Bud-wiser-er/ERD320-FinalReport/README.md

##READ ME##
No claude was not used, I used it to set up this repo and ensure no exe files wehre pushed. You can see everything is done by myself
