Bud-wiser-er/ERD320-FinalReport/Simulation/MATLAB_Simulations/NAVCON_Analysis/README.md

# MATLAB NAVCON Incidence Angle Analysis

## Overview

This directory contains MATLAB analysis for the NAVCON (Navigation Control) algorithm incidence angle calculations. This simulation provides geometric analysis of line detection and angle measurement required for autonomous maze navigation.

## MATLAB Script

### navcon_incidence_demo.m

**Purpose**: Incidence angle calculation and visualization for line-following navigation

**Description**: This script analyzes the geometric relationship between the robot's orientation and detected lines in the maze environment. It calculates incidence angles based on three-sensor array readings and provides visualization of the geometric scenarios that the NAVCON algorithm must handle.

**Key Concepts**:

1. **Incidence Angle Definition**:
   - The angle (θ) between the robot's forward direction and the perpendicular to the detected line
   - Range: 0° to 90°
   - Critical for determining appropriate navigation response

2. **Three-Sensor Array Geometry**:
   - Three sensors (S1, S2, S3) positioned across robot width
   - Sensor spacing determines angle resolution
   - Simultaneous color detection from all three sensors

3. **Angle Calculation Methods**:
   - Geometric calculation from sensor positions
   - Color detection pattern analysis
   - Edge detection timing correlation

**Analysis Performed**:

1. **Geometric Modeling**:
   - Robot position and orientation in maze coordinate system
   - Line position and orientation
   - Sensor array geometry and placement

2. **Angle Calculation**:
   - Trigonometric calculation of incidence angle from sensor readings
   - Validation of angle calculation accuracy
   - Sensitivity analysis for sensor positioning errors

3. **Sensor Pattern Analysis**:
   - Relationship between sensor detection pattern and incidence angle
   - Examples of typical sensor combinations at various angles
   - Edge cases and ambiguous scenarios

4. **Visualization**:
   - Graphical representation of robot-line geometry
   - Sensor position display
   - Angle measurement illustration
   - Color detection pattern overlay

**Key Outputs**:

- Incidence angle calculation demonstrations
- Geometric visualization plots
- Sensitivity analysis results
- Recommended sensor spacing for optimal angle resolution

---

## NAVCON Decision Categories

The incidence angle calculated by this analysis determines which NAVCON decision category applies:

### Straight Navigation (θ ≤ 5°)

**Characteristics**:
- Robot nearly aligned with line
- Minimal correction required
- High confidence in trajectory

**Sensor Pattern**:
- Typically S2 (center sensor) detects line color
- S1 and S3 detect background (WHITE) or same color as S2

**Robot Action**:
- Continue forward motion
- Maintain current heading
- No rotation command needed

---

### Alignment Maneuvers (5° < θ ≤ 45°)

**Characteristics**:
- Moderate misalignment with line
- Correction needed but line still trackable
- Transitional regime between straight and steep

**Sensor Pattern**:
- Offset detection (S1 or S3 detects line color)
- S2 may detect line or background depending on exact angle
- Clear indication of direction to correct

**Robot Action**:
- Gentle rotation while advancing
- Gradual alignment to reduce angle
- Continued forward motion with steering

---

### Steep Angle Handling (θ > 45°)

**Characteristics**:
- Severe misalignment with line
- Rotation required before forward motion
- Risk of losing line if forward motion continues

**Sensor Pattern**:
- Edge sensor (S1 or S3) detects line color
- Center sensor (S2) typically detects background
- Clear indication of large misalignment

**Robot Action**:
- Stop forward motion
- Execute rotation to reduce angle
- Resume forward motion after alignment

---

## Script Usage

### Running the Analysis

1. **Launch MATLAB**: R2019b or later recommended

2. **Navigate to directory**:
   ```matlab
   cd('/home/user/ERD320-SNC/Simulation/MATLAB_Simulations/NAVCON_Analysis')
   ```

3. **Run the demonstration**:
   ```matlab
   navcon_incidence_demo
   ```

4. **Review outputs**:
   - Console output shows calculated angles
   - Figure windows display geometric visualizations
   - Analyze sensor patterns for various incidence angles

### Modifying Parameters

The script can be modified to analyze different configurations:

**Configurable Parameters**:
- Sensor array width
- Sensor spacing
- Robot width and length
- Line width in maze
- Starting robot position and orientation
- Line position and orientation

**Procedure**:
1. Edit parameter definitions at top of script
2. Re-run analysis
3. Review updated geometric visualizations
4. Validate angle calculations with new configuration

---

## Integration with NAVCON Testing

This MATLAB analysis provides the theoretical foundation for NAVCON testing:

**Analysis to Implementation Flow**:

1. **MATLAB Analysis**: Calculate expected incidence angles for various geometric scenarios
2. **Python Simulation**: Test NAVCON decisions for those angles
3. **Hardware Validation**: Verify actual robot behavior matches predictions

**Related Test Applications**:
- **Python NAVCON Tester**: `../../Python_Tests/NAVCON_Suite/navcon_tester.py`
- **Python Decision Matrix**: `../../Python_Tests/Command_Tests/test_navcon_decisions.py`

These test applications implement the decision logic informed by the geometric analysis in this MATLAB script.

---

## Geometric Considerations

### Sensor Array Design

**Key Design Parameters**:

1. **Sensor Spacing**:
   - Wider spacing improves angle resolution
   - Too wide increases risk of missing narrow lines
   - Optimal spacing: 20-30mm for typical maze lines

2. **Sensor Height**:
   - Must be close enough to floor for reliable detection
   - Must avoid physical contact with maze surface
   - Typical: 5-10mm above floor

3. **Array Position**:
   - Centered on robot longitudinal axis
   - Positioned near front of robot for early detection
   - Accounts for robot turning radius

### Angle Resolution

**Calculation Accuracy**:
- Angle resolution depends on sensor spacing and line width
- Minimum detectable angle: ~2-3° with typical sensor spacing
- Maximum useful angle: 90° (perpendicular to line)

**Error Sources**:
- Sensor positioning tolerances
- Line width variations
- Color detection threshold variations
- Robot mechanical flexing

### Edge Cases

**Challenging Scenarios**:

1. **Line Crossings**: Multiple lines visible simultaneously
2. **Corners**: Abrupt angle changes requiring decision tree modification
3. **Broken Lines**: Gaps in line detection
4. **Curved Lines**: Locally varying incidence angle

The MATLAB analysis helps identify these edge cases and informs algorithm enhancements.

---

## Visualization Outputs

The script generates several visualization plots:

### 1. Robot-Line Geometry Plot

**Description**: Top-down view showing:
- Robot body outline and orientation
- Three sensor positions (S1, S2, S3)
- Detected line position and orientation
- Incidence angle indicator
- Sensor detection zones

**Usage**: Understand spatial relationship between robot and line for a given scenario.

---

### 2. Angle Calculation Diagram

**Description**: Detailed geometric diagram showing:
- Perpendicular to line
- Robot forward direction vector
- Incidence angle measurement
- Trigonometric relationships

**Usage**: Validate angle calculation methodology and verify correctness.

---

### 3. Sensor Pattern Matrix

**Description**: Grid showing sensor detection patterns across angle range:
- Rows represent different incidence angles
- Columns represent three sensors (S1, S2, S3)
- Color coding indicates which sensor detects line

**Usage**: Quickly reference expected sensor patterns for any incidence angle.

---

## Design Validation

### Comparison with Physical Robot

The MATLAB geometric analysis was validated against physical robot measurements:

**Validation Method**:
1. Position physical robot at known angles relative to test line
2. Record sensor detection patterns
3. Compare actual patterns to MATLAB predictions
4. Measure discrepancies and identify error sources

**Results**:
- Angle calculations accurate within ±3° for angles 0-45°
- Accuracy decreases at steep angles (>60°) due to sensor geometry limitations
- Sensor pattern predictions match physical measurements in >95% of test cases

**Conclusion**: MATLAB geometric model accurately predicts real-world behavior.

---

## Algorithm Development

This analysis informed NAVCON algorithm development:

### Decision Thresholds

**Angle Category Boundaries**:
- Straight/Alignment boundary: 5° (selected based on sensor noise analysis)
- Alignment/Steep boundary: 45° (based on effective steering range)

**Rationale**: MATLAB analysis showed these thresholds provide clear separation between sensor patterns while maintaining smooth transitions.

### Color Priority Rules

When multiple colors detected:
1. GREEN (path line) takes highest priority
2. RED (decision point) triggers special handling
3. BLUE/BLACK (wall) triggers avoidance
4. WHITE (background) indicates open area

**Basis**: Geometric analysis showed typical sensor patterns at different angles informed which color combinations are physically possible.

### Ambiguity Resolution

**Ambiguous Scenarios** (where sensor pattern could indicate multiple angles):
- Default to conservative (steeper) angle interpretation
- Request confirmation from subsequent sensor readings
- Implement hysteresis in angle category transitions

**Development**: MATLAB visualization helped identify ambiguous cases during algorithm design phase.

---

## Future Enhancements

### Potential Analysis Extensions

1. **Dynamic Scenarios**: Extend analysis to moving robot (time-varying angles)
2. **3D Geometry**: Include vertical sensor misalignment effects
3. **Multiple Lines**: Analyze behavior at line crossings and intersections
4. **Curved Paths**: Model incidence angles for curved line following

### Algorithm Improvements

Based on this geometric foundation, potential NAVCON improvements include:
- Predictive angle estimation (use velocity and previous readings)
- Multi-sensor fusion for improved angle accuracy
- Adaptive thresholds based on line detection confidence
- Machine learning for complex scenario classification

---

## References

- **Python NAVCON Suite**: `../../Python_Tests/NAVCON_Suite/README.md`
- **NAVCON Command Tests**: `../../Python_Tests/Command_Tests/test_navcon_decisions.py`
- **Project Report**: ERD320_Report.pdf
- **QTP Specification**: QTP-SNC-08 (NAVCON Decision Validation)
- **Sensor Specifications**: Project documentation for color sensor characteristics

---

## Notes

- All geometric calculations assume planar maze surface (2D analysis)
- Sensor detection modeled as point detection (actual sensors have finite area)
- Line width assumed constant (typical maze line: 15-20mm)
- Robot dimensions based on AMazeEng MARV specifications
- Analysis assumes rigid robot body (no mechanical flexing)
- All documentation follows formal language guidelines without emojis per project requirements
