Bud-wiser-er/ERD320-FinalReport/EPR320_Group_45_Final_Report/acronyms.tex

% acronyms/acronyms.tex
% Define acronyms for automatic first-use expansion and list generation.

% ==================== PROJECT-SPECIFIC ACRONYMS ====================
\newacronym{marv}{MARV}{Miniature Autonomous Robotic Vehicle}
\newacronym{snc}{SNC}{State-and-Navigation Control}
\newacronym{ss}{SS}{Sensor Subsystem}
\newacronym{mdps}{MDPS}{Motor Drive and Power Subsystem}
\newacronym{scs}{SCS}{Structured Command Set}
\newacronym{navcon}{NAVCON}{Navigation Control}
\newacronym{hmi}{HMI}{Human-Machine Interface}
\newacronym{pec}{PEC}{Project Evaluation Criteria}
\newacronym{hub}{HUB}{Hardware Unit Bench (testing interface)}
\newacronym{eoc}{EoC}{End-of-Calibration}
\newacronym{eom}{EoM}{End-of-Maze}
\newacronym{sos}{SOS}{Save Our Ship (emergency state)}
\newacronym{ist}{IST}{Instruction Type}
\newacronym{spl}{SPL}{Sound Pressure Level}

% ==================== SYSTEMS ENGINEERING ====================
\newacronym{qtp}{QTP}{Qualification Test Procedure}
\newacronym{icd}{ICD}{Interface Control Document}
\newacronym{rtm}{RTM}{Requirements Traceability Matrix}
\newacronym{opscon}{OpsCon}{Operational Concept}
\newacronym{stp}{STP}{System Test Plan}
\newacronym{vv}{V\&V}{Verification and Validation}
\newacronym{fsm}{FSM}{Finite State Machine}
\newacronym{hil}{HIL}{Hardware-in-the-Loop}
\newacronym{mtbf}{MTBF}{Mean Time Between Failures}
\newacronym{mttr}{MTTR}{Mean Time To Repair}

% ==================== HARDWARE & MICROCONTROLLER ====================
\newacronym{mcu}{MCU}{Microcontroller Unit}
\newacronym{cpu}{CPU}{Central Processing Unit}
\newacronym{gpio}{GPIO}{General Purpose Input/Output}
\newacronym{adc}{ADC}{Analogue-to-Digital Converter}
\newacronym{dac}{DAC}{Digital-to-Analogue Converter}
\newacronym{pwm}{PWM}{Pulse Width Modulation}
\newacronym{led}{LED}{Light Emitting Diode}
\newacronym{pcb}{PCB}{Printed Circuit Board}
\newacronym{ic}{IC}{Integrated Circuit}
\newacronym{mosfet}{MOSFET}{Metal-Oxide-Semiconductor Field-Effect Transistor}
\newacronym{afe}{AFE}{Analogue Front-End}
\newacronym{isr}{ISR}{Interrupt Service Routine}

% ==================== COMMUNICATION PROTOCOLS ====================
\newacronym{uart}{UART}{Universal Asynchronous Receiver-Transmitter}
\newacronym{iic}{I\textsuperscript{2}C}{Inter-Integrated Circuit}
\newacronym{spi}{SPI}{Serial Peripheral Interface}
\newacronym{usb}{USB}{Universal Serial Bus}
\newacronym{rf}{RF}{Radio Frequency}

% ==================== NETWORKING & DATA ====================
\newacronym{wifi}{Wi-Fi}{Wireless Fidelity}
\newacronym{http}{HTTP}{Hypertext Transfer Protocol}
\newacronym{rest}{REST}{Representational State Transfer}
\newacronym{api}{API}{Application Programming Interface}
\newacronym{json}{JSON}{JavaScript Object Notation}
\newacronym{csv}{CSV}{Comma-Separated Values}
\newacronym{ws}{WS}{WebSocket}

% ==================== DATA INTEGRITY & PROTOCOL ====================
\newacronym{crc}{CRC}{Cyclic Redundancy Check}
\newacronym{sof}{SOF}{Start of Frame}
\newacronym{eof}{EOF}{End of Frame}
\newacronym{ack}{ACK}{Acknowledge}
\newacronym{nak}{NAK}{Negative Acknowledge}
\newacronym{ber}{BER}{Bit Error Rate}

% ==================== MEMORY & STORAGE ====================
\newacronym{ram}{RAM}{Random Access Memory}
\newacronym{rom}{ROM}{Read-Only Memory}
\newacronym{eeprom}{EEPROM}{Electrically Erasable Programmable Read-Only Memory}
\newacronym{rtc}{RTC}{Real-Time Clock}
\newacronym{dma}{DMA}{Direct Memory Access}

% ==================== CONTROL & SIGNAL PROCESSING ====================
\newacronym{pid}{PID}{Proportional-Integral-Derivative}
\newacronym{dsp}{DSP}{Digital Signal Processing}

% ==================== ELECTROMAGNETIC & SAFETY ====================
\newacronym{emi}{EMI}{Electromagnetic Interference}
\newacronym{emc}{EMC}{Electromagnetic Compatibility}
\newacronym{dc}{DC}{Direct Current}

% ==================== DEVELOPMENT TOOLS ====================
\newacronym{ide}{IDE}{Integrated Development Environment}
\newacronym{cad}{CAD}{Computer-Aided Design}
\newacronym{git}{Git}{Distributed Version Control System}

% ==================== OTHER TECHNICAL TERMS ====================
\newacronym{fpga}{FPGA}{Field-Programmable Gate Array}
\newacronym{iot}{IoT}{Internet of Things}

% ==================== ESP32 & EMBEDDED SYSTEMS ====================
\newacronym{soc}{SoC}{System on Chip}
\newacronym{rtos}{RTOS}{Real-Time Operating System}
\newacronym{wdt}{WDT}{Watchdog Timer}
\newacronym{ota}{OTA}{Over-The-Air (firmware update)}
\newacronym{sdk}{SDK}{Software Development Kit}
\newacronym{bsp}{BSP}{Board Support Package}
\newacronym{hal}{HAL}{Hardware Abstraction Layer}
\newacronym{nvs}{NVS}{Non-Volatile Storage}
\newacronym{jtag}{JTAG}{Joint Test Action Group (debugging interface)}
\newacronym{sram}{SRAM}{Static Random Access Memory}

% ==================== SENSORS & MEASUREMENT ====================
\newacronym{ir}{IR}{Infrared}
\newacronym{rgb}{RGB}{Red Green Blue}
\newacronym{imu}{IMU}{Inertial Measurement Unit}
\newacronym{tof}{ToF}{Time of Flight}
\newacronym{ldr}{LDR}{Light Dependent Resistor}
\newacronym{snr}{SNR}{Signal-to-Noise Ratio}

% ==================== MOTOR CONTROL & POWER ====================
\newacronym{hbridge}{H-Bridge}{H-Bridge Motor Driver Circuit}
\newacronym{rpm}{RPM}{Revolutions Per Minute}
\newacronym{emf}{EMF}{Electromotive Force}
\newacronym{bemf}{Back-EMF}{Back Electromotive Force}
\newacronym{ldo}{LDO}{Low Dropout Regulator}
\newacronym{smps}{SMPS}{Switching Mode Power Supply}
\newacronym{bms}{BMS}{Battery Management System}
\newacronym{lipo}{LiPo}{Lithium Polymer}
\newacronym{liion}{Li-ion}{Lithium-ion}

% ==================== NETWORKING & PROTOCOLS ====================
\newacronym{tcp}{TCP}{Transmission Control Protocol}
\newacronym{udp}{UDP}{User Datagram Protocol}
\newacronym{ip}{IP}{Internet Protocol}
\newacronym{dhcp}{DHCP}{Dynamic Host Configuration Protocol}
\newacronym{dns}{DNS}{Domain Name System}
\newacronym{ssid}{SSID}{Service Set Identifier}
\newacronym{mac}{MAC}{Media Access Control}
\newacronym{ntp}{NTP}{Network Time Protocol}
\newacronym{ap}{AP}{Access Point}
\newacronym{sta}{STA}{Station (Wi-Fi client mode)}

% ==================== SOFTWARE & INTERFACES ====================
\newacronym{cli}{CLI}{Command Line Interface}
\newacronym{gui}{GUI}{Graphical User Interface}
\newacronym{ui}{UI}{User Interface}
\newacronym{cicd}{CI/CD}{Continuous Integration/Continuous Deployment}

% ==================== DATA STRUCTURES & FORMATS ====================
\newacronym{fifo}{FIFO}{First In First Out}
\newacronym{lifo}{LIFO}{Last In First Out}
\newacronym{ascii}{ASCII}{American Standard Code for Information Interchange}
\newacronym{utf}{UTF-8}{8-bit Unicode Transformation Format}
\newacronym{msb}{MSB}{Most Significant Bit}
\newacronym{lsb}{LSB}{Least Significant Bit}

% ==================== COMMUNICATION SIGNALS ====================
\newacronym{rxtx}{RX/TX}{Receive/Transmit}
\newacronym{rtscts}{RTS/CTS}{Request to Send/Clear to Send}
\newacronym{miso}{MISO}{Master In Slave Out}
\newacronym{mosi}{MOSI}{Master Out Slave In}
\newacronym{sck}{SCK}{Serial Clock}
\newacronym{sda}{SDA}{Serial Data}
\newacronym{scl}{SCL}{Serial Clock}

% ==================== SIGNAL PROCESSING ====================
\newacronym{fft}{FFT}{Fast Fourier Transform}
\newacronym{fir}{FIR}{Finite Impulse Response}
\newacronym{iir}{IIR}{Infinite Impulse Response}
\newacronym{lpf}{LPF}{Low Pass Filter}
\newacronym{hpf}{HPF}{High Pass Filter}
\newacronym{bpf}{BPF}{Band Pass Filter}
\newacronym{mfb}{MFB}{Multiple Feedback}

% ==================== ELECTRICAL MEASUREMENTS ====================
\newacronym{rms}{RMS}{Root Mean Square}
\newacronym{ac}{AC}{Alternating Current}
\newacronym{gnd}{GND}{Ground}
\newacronym{vcc}{VCC}{Voltage Common Collector (positive supply)}
\newacronym{vdd}{VDD}{Voltage Drain Drain (positive supply)}

% ==================== UNIVERSITY & DOCUMENTATION ====================
\newacronym{up}{UP}{University of Pretoria}
\newacronym{eece}{EECE}{Electrical, Electronic and Computer Engineering}
\newacronym{pdf}{PDF}{Portable Document Format}
\newacronym{cots}{COTS}{Commercial Off-The-Shelf}
\newacronym{tbd}{TBD}{To Be Determined}
\newacronym{tbc}{TBC}{To Be Confirmed}
\newacronym{wip}{WIP}{Work In Progress}
