Bud-wiser-er/ERD320-FinalReport/EPR320_Group_45_Final_Report/02_SS/concept_exploration.tex

\subsection{Subsystem Concept Exploration}
\textit{-	Refer to Kossiakoff, Chapter 6, 7 and 8\\
-	Do a brief survey of literature on possible methods / circuits / designs that could meet the above needs, other than the prescribed subsystem. MAKE SURE THAT THE DOCUMENTS YOU REFERENCE ARE INCLUDED IN SECTION 1.2!!!}

% Write your concept exploration here

\subsubsection{Colour Detection Sensors}

\subsubsection{Incidence Angle Detection}
