Bud-wiser-er/ERD320-FinalReport/EPR320_Group_45_Final_Report/02_SS/lab_book_excerpts.tex

\subsection{Lab Book Excerpts}
\stepcounter{subsubsection}  % Increment the section number manually

\subsubsection*{\thesubsubsection\hspace{1em} Design Constraints}
% Add lab book excerpt for design constraints
\begin{figure}[H]
\centering
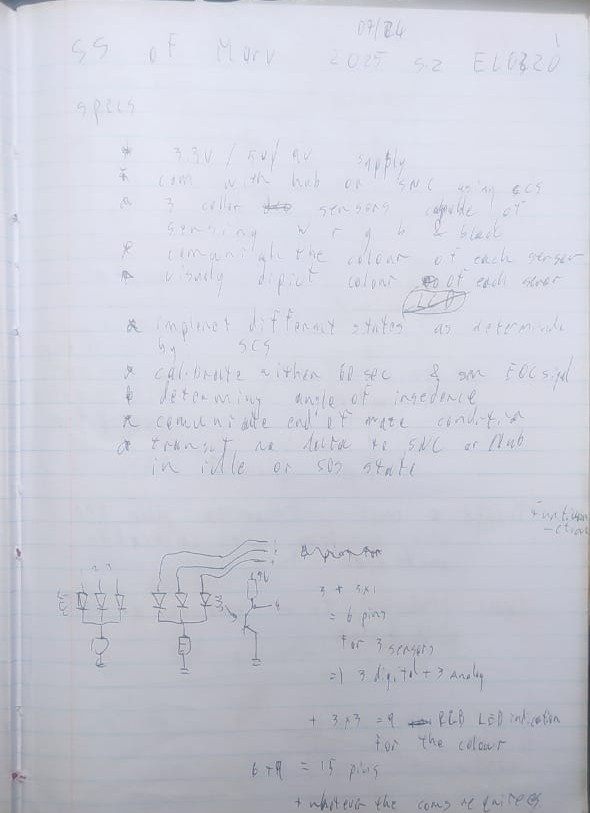
[picture p15: EPR320_Group_45_Final_Report/02_SS/figures/lab_book_constraints.jpg]

\caption{Pure Tone Detection Flow: Analog Signal Chain and Digital Validation}
\label{fig:pure-tone-detection-flow}
\end{figure}

\stepcounter{subsubsection}  % Increment the section number manually

\subsubsection*{\thesubsubsection\hspace{1em} Trade-offs}
% Add lab book excerpt for trade-offs
\begin{figure}[H]
\centering
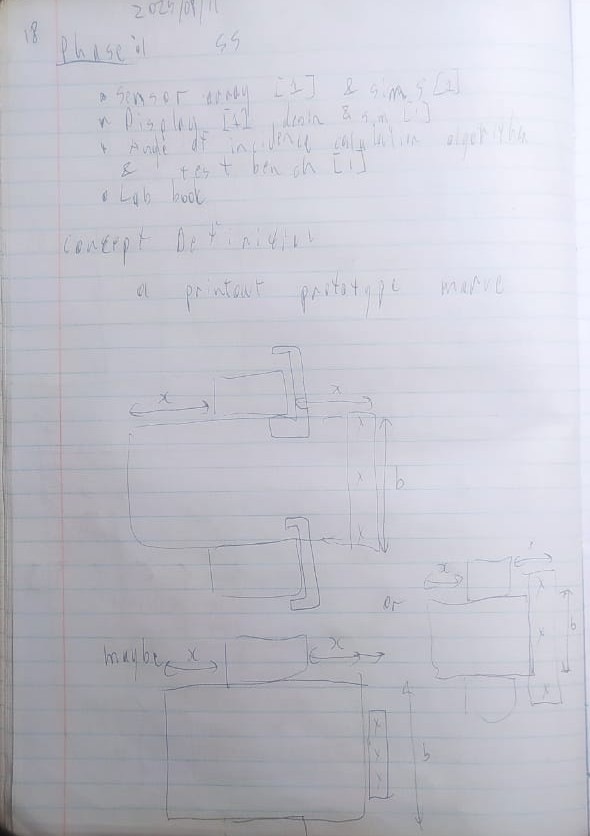
[picture p16: EPR320_Group_45_Final_Report/02_SS/figures/lab_book_trade_offs.jpg]

\caption{Pure Tone Detection Flow: Analog Signal Chain and Digital Validation}
\label{fig:pure-tone-detection-flow}
\end{figure}

\stepcounter{subsubsection}  % Increment the section number manually

\subsubsection*{\thesubsubsection\hspace{1em} Engineering tools}
% Add lab book excerpt for engineering tools
\begin{figure}[H]
\centering
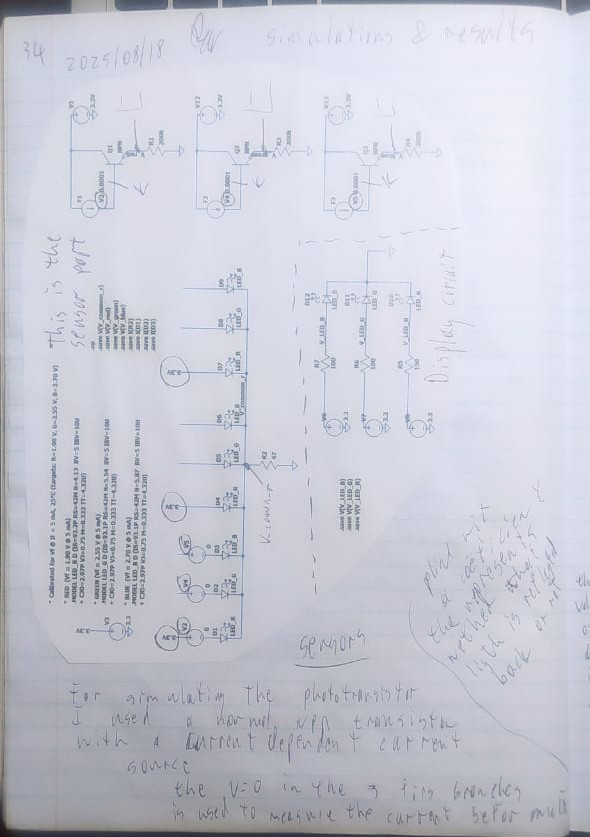
[picture p17: EPR320_Group_45_Final_Report/02_SS/figures/lab_book_tools.jpg]

\caption{Pure Tone Detection Flow: Analog Signal Chain and Digital Validation}
\label{fig:pure-tone-detection-flow}
\end{figure}

\stepcounter{subsubsection}  % Increment the section number manually
\subsubsection*{\thesubsubsection\hspace{1em} Engineering methods}
\begin{figure}[H]
\centering
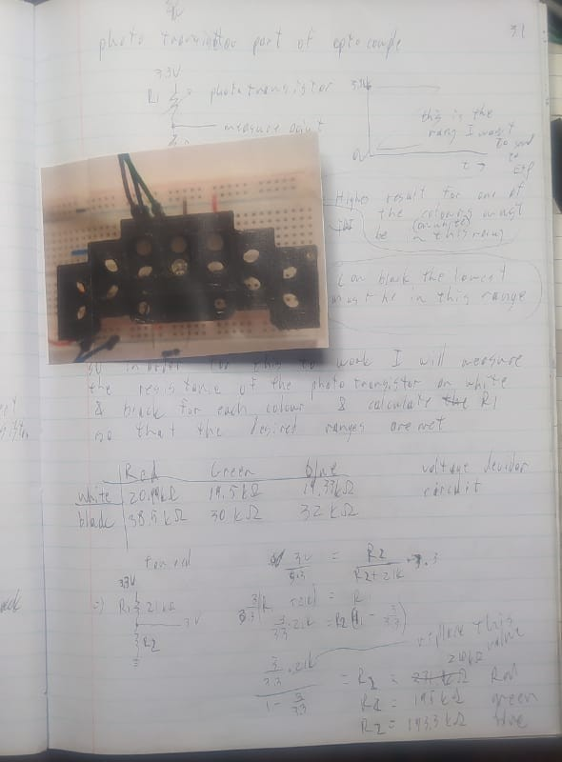
[picture p18: EPR320_Group_45_Final_Report/02_SS/figures/lab_book_methods.jpg]

\caption{Pure Tone Detection Flow: Analog Signal Chain and Digital Validation}
\label{fig:pure-tone-detection-flow}
\end{figure}
% Add lab book excerpt for engineering methods

\stepcounter{subsubsection}  % Increment the section number manually
\subsubsection*{\thesubsubsection\hspace{1em} Statements of requirements}

\begin{figure}[H]
\centering
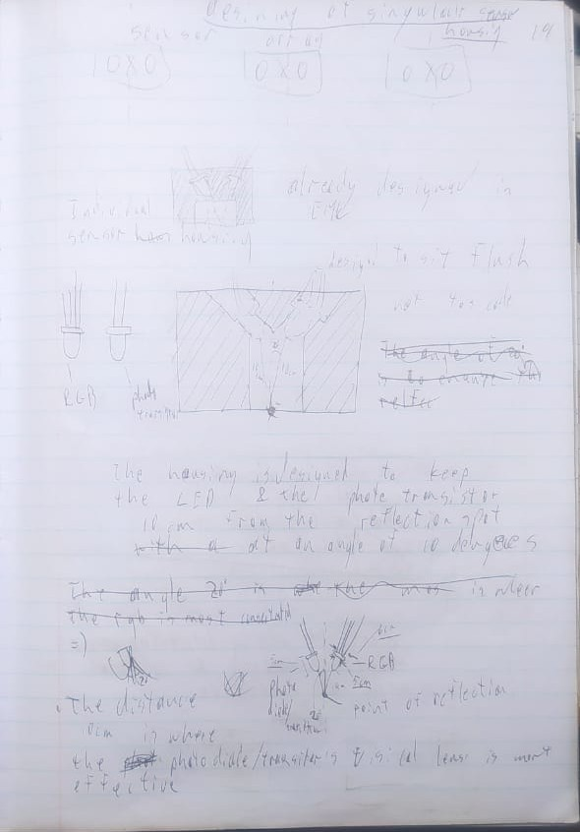
[picture p19: EPR320_Group_45_Final_Report/02_SS/figures/lab_book_requirements.jpg]

\caption{Pure Tone Detection Flow: Analog Signal Chain and Digital Validation}
\label{fig:pure-tone-detection-flow}
\end{figure}
% Add lab book excerpt for statements of requirements

\stepcounter{subsubsection}  % Increment the section number manually
\subsubsection*{\thesubsubsection\hspace{1em} Development}

\begin{figure}[H]
\centering
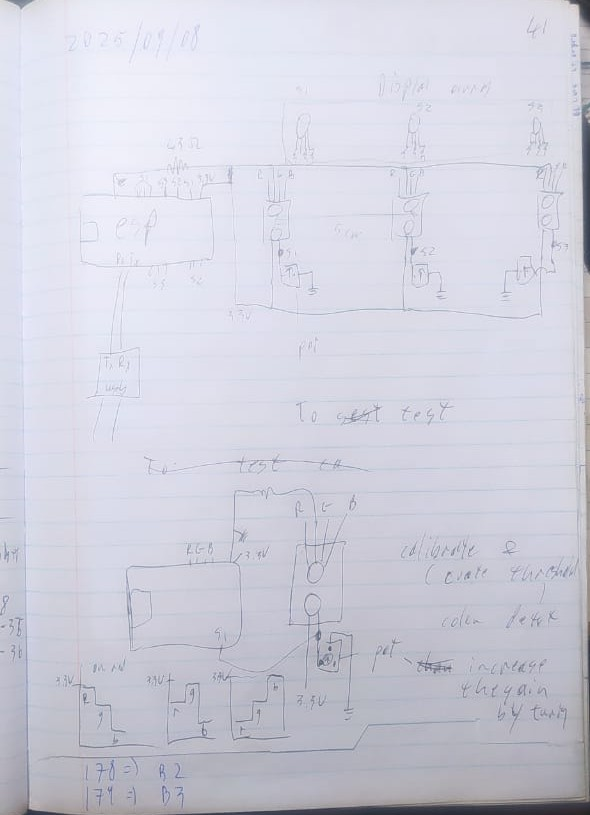
[picture p20: EPR320_Group_45_Final_Report/02_SS/figures/lab_book_developement.jpg]

\caption{Pure Tone Detection Flow: Analog Signal Chain and Digital Validation}
\label{fig:pure-tone-detection-flow}
\end{figure}
% Add lab book excerpt for development

\stepcounter{subsubsection}  % Increment the section number manually
\subsubsection*{\thesubsubsection\hspace{1em} Simulations}
\begin{figure}[H]
\centering
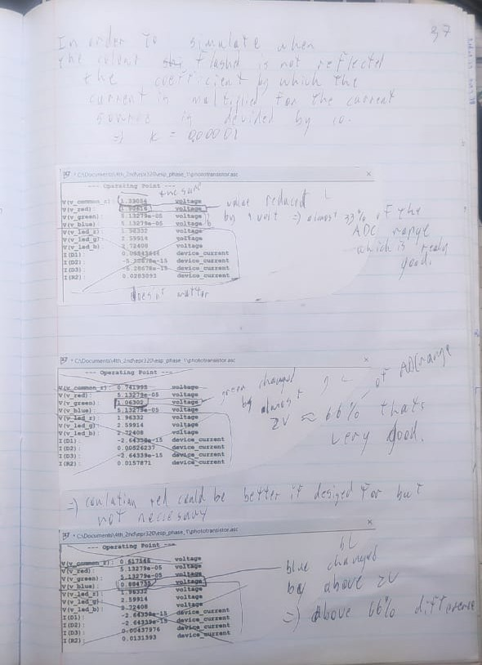
[picture p21: EPR320_Group_45_Final_Report/02_SS/figures/lab_book_simulation.jpg]

\caption{Pure Tone Detection Flow: Analog Signal Chain and Digital Validation}
\label{fig:pure-tone-detection-flow}
\end{figure}
% Add lab book excerpt for simulations

\stepcounter{subsubsection}  % Increment the section number manually
\subsubsection*{\thesubsubsection\hspace{1em} Approach to coding and testing}
\begin{figure}[H]
\centering
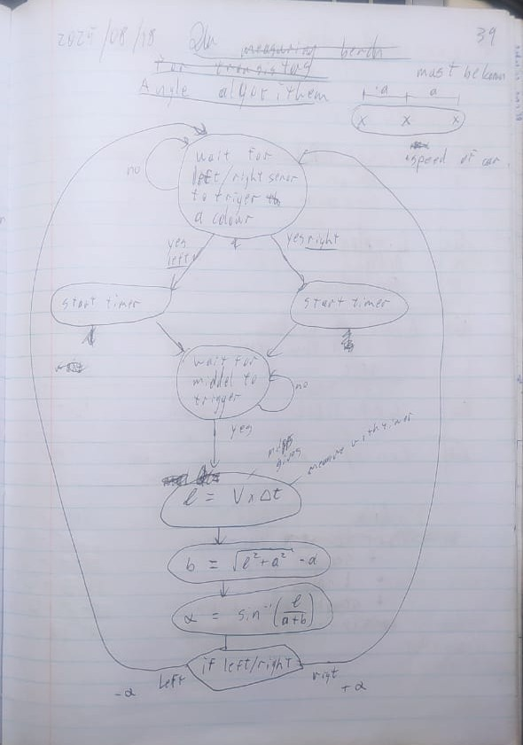
[picture p22: EPR320_Group_45_Final_Report/02_SS/figures/lab_book_coding.jpg]

\caption{Pure Tone Detection Flow: Analog Signal Chain and Digital Validation}
\label{fig:pure-tone-detection-flow}
\end{figure}
% Add lab book excerpt for approach to coding and testing
