Bud-wiser-er/ERD320-FinalReport/EPR320_Group_45_Final_Report/03_MDPS/0_title.tex

\subsection{Title: Subsystem 3: MDPS}

\textbf{Subsystem Name:} Motor Driver and Power Supply (MDPS) Subsystem

\textbf{Student Name:} Kyle Green

\textbf{Student Number:} 21441325
