Bud-wiser-er/ERD320-FinalReport/EPR320_Group_45_Final_Report/01_SNC/diagrams/pure_tone_flow_simple.pdf

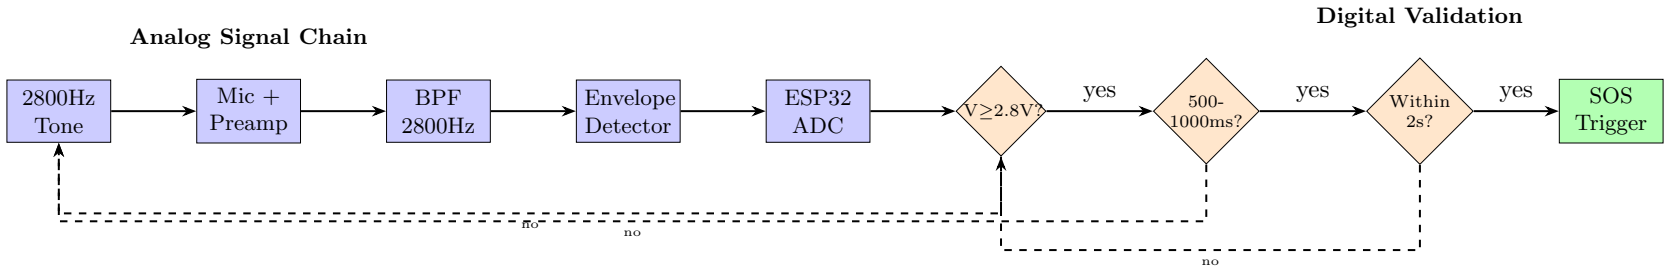
[picture p31: figure]
2800Hz Tone; Mic + Preamp; BPF 2800Hz; Envelope Detector; ESP32 ADC; Within 2s?; SOS Trigger; yes; Analog Signal Chain; Digital Validation
