Bud-wiser-er/ERD320-FinalReport/EPR320_Group_45_Final_Report/01_SNC/diagrams/objectives_tree/out/objectives_tree.pdf

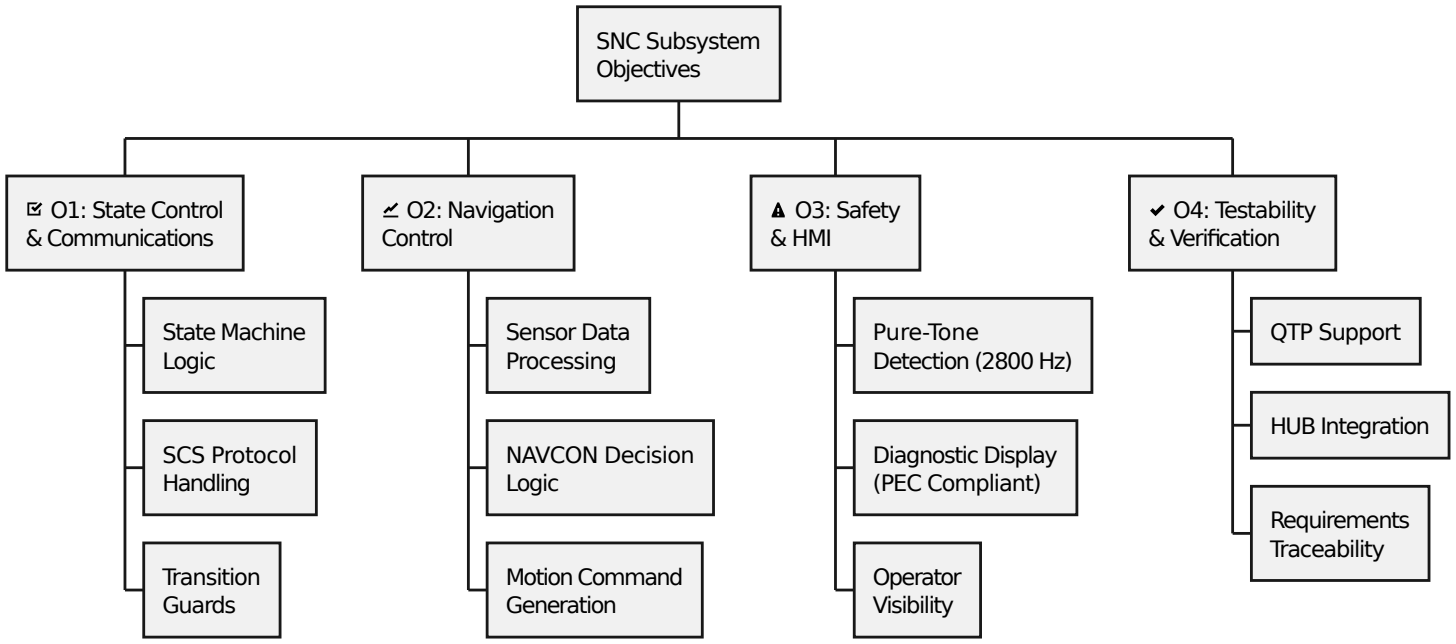
[picture p32: figure]
O1: State Control & Communications; State Machine Logic; SCS Protocol Handling; Transition Guards; O2: Navigation Control; Sensor Data Processing; NAVCON Decision Logic; Motion Command Generation; O3: Safety & HMI; Pure-Tone Detection (2800 Hz); Diagnostic Display (PEC Compliant); Operator Visibility; O4: Testability & Verification; QTP Support; HUB Integration; Requirements Traceability; SNC Subsystem Objectives
