Bud-wiser-er/ERD320-FinalReport/Phase 0/SNC/ERD_code_flow_.pdf

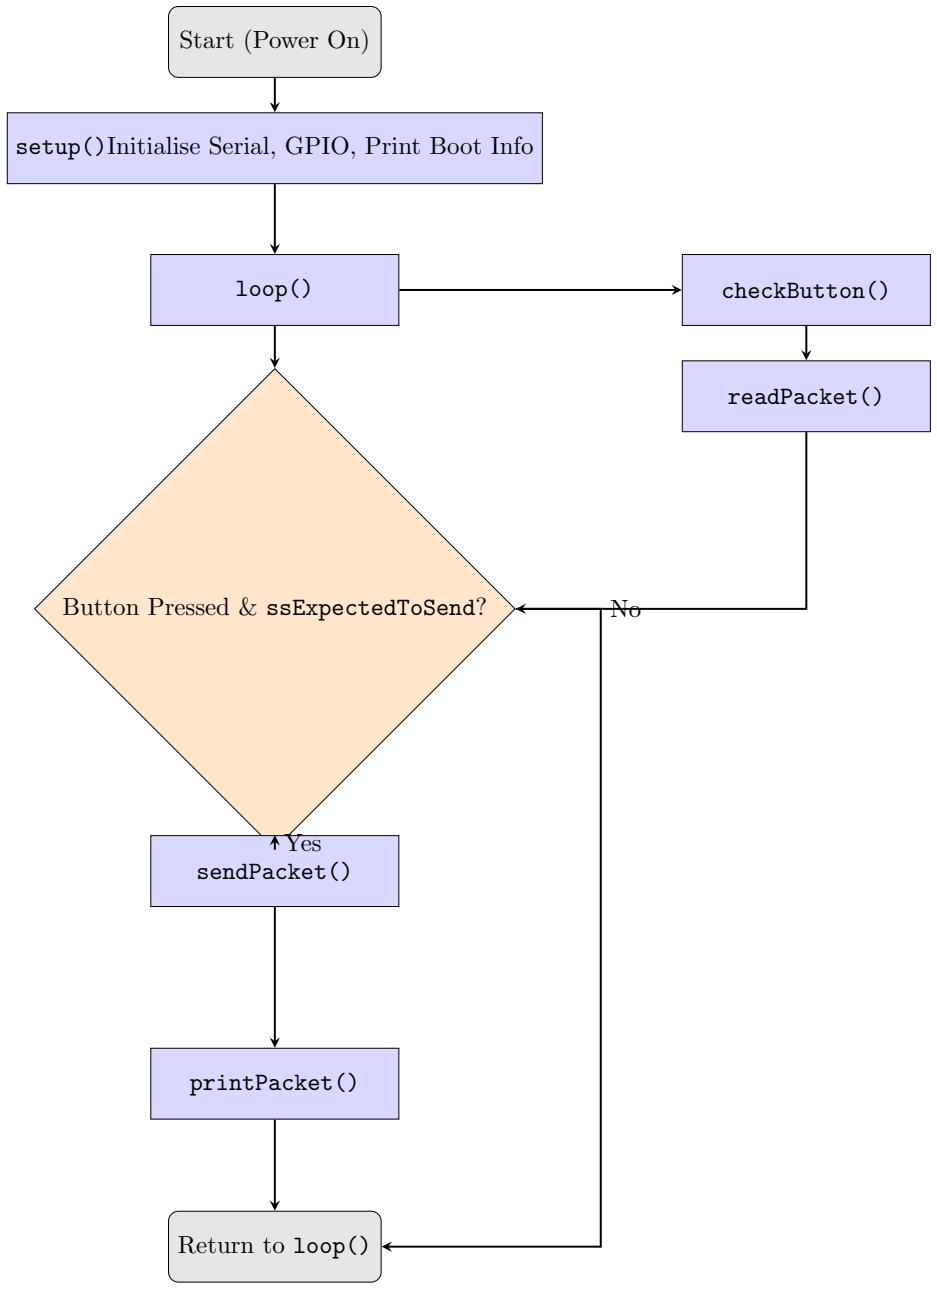
[picture p33: figure]
Start (Power On); loop(); checkButton(); readPacket(); Button Pressed & ssExpectedToSend?; sendPacket(); printPacket(); Return to loop(); Yes

setup()Initialise Serial, GPIO, Print Boot Info

1
