Bud-wiser-er/ERD320-FinalReport/EPR320_Group_45_Final_Report/00_FullSystem/referenced_documents.tex

\subsection{Referenced Documents}

System development referenced the following documents:

\begin{itemize}
    \item \textit{Project Guide to an AMazeENG MARV 2025} \cite{marv-guide-2025} -- System specifications, \gls{qtp} procedures, and subsystem interface definitions
    \item \textit{AMazeEng MARV QTPs 2025} \cite{marv-qtp-2025} -- Qualification test procedures and acceptance criteria
    \item Kossiakoff et al., \textit{Systems Engineering Principles and Practice} \cite{kossiakoff2011systems} -- Systems engineering methodology and needs analysis framework
\end{itemize}

\begingroup
  \renewcommand{\section}[2]{}
  % Make the reference font the same size as the rest of the text.
  \IEEEtriggercmd{\normalsize}
  \IEEEtriggeratref{1}
  \bibliographystyle{IEEEtran}%
  \bibliography{references}%
\endgroup
