Bud-wiser-er/ERD320-FinalReport/EPR320_Group_45_Final_Report/drawings/EECELogo.pdf

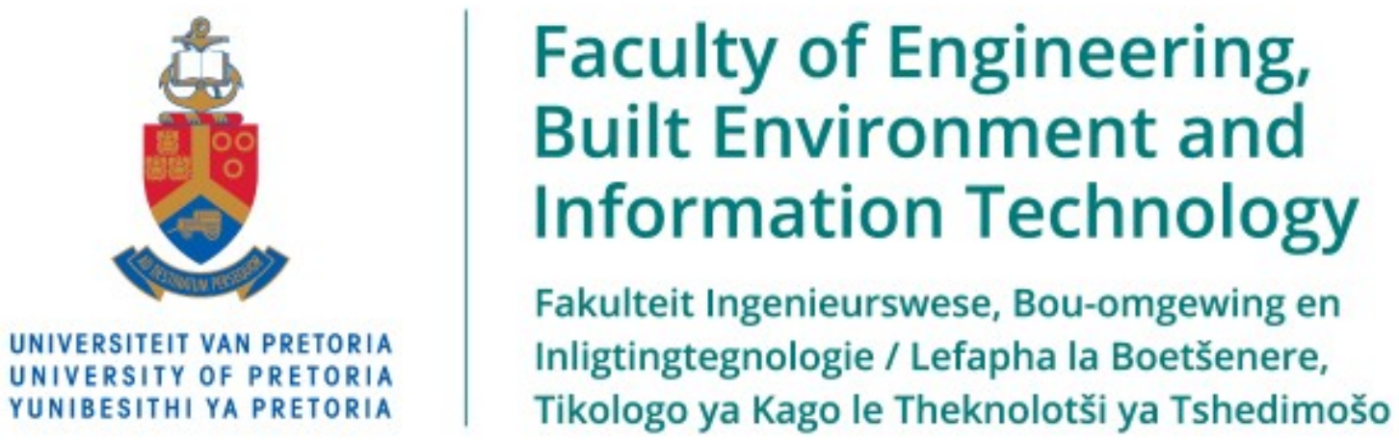
[picture p36: page 1]
