Bud-wiser-er/ERD320-FinalReport/EPR320_Group_45_Final_Report/drawings/up_logo_ebit.pdf

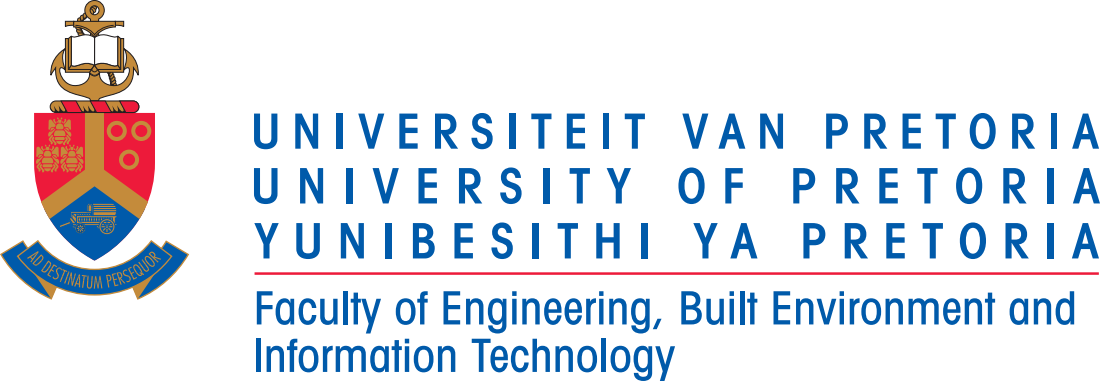
[picture p37: page 1]
