Bud-wiser-er/ERD320-FinalReport/Phase 1/Pure tone sims/MATLAB sims for gain/MCP6024_Design_Decision.pdf

10² | 10³ | 10⁴

### Preamp Gain (V/V)

NOT FEASIBLE

FEASIBLE

### Design Feasibility

### MCP6024 Preamp Design Decision

Feasibility
Design Range 1000-1200x
data1
Target 1100x
1000x Min
1200x Max
