Bud-wiser-er/ERD320-FinalReport/EPR320_Group_45_Final_Report/01_SNC/diagrams/architecture_interfaces/out/architecture_interfaces.png

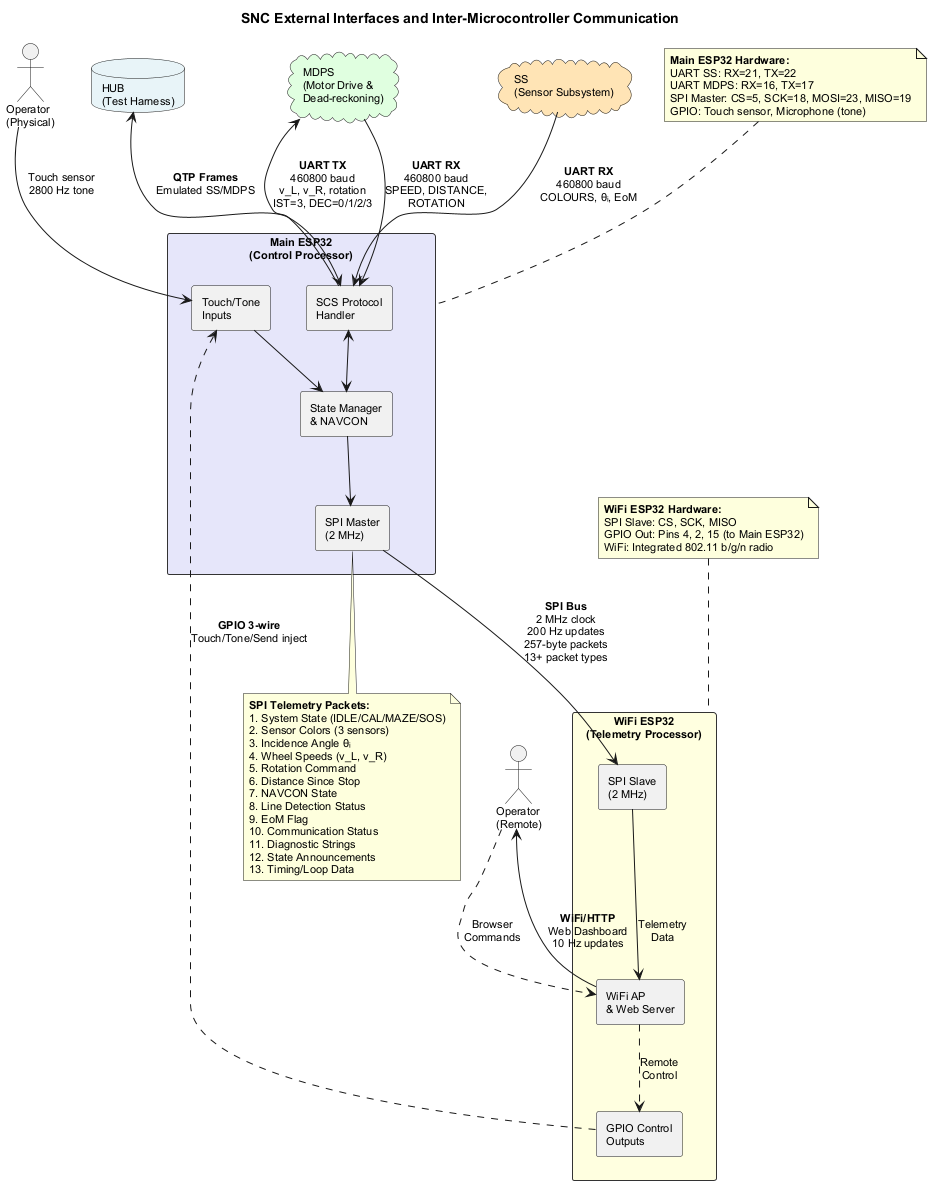
EPR320_Group_45_Final_Report/01_SNC/diagrams/architecture_interfaces/out/architecture_interfaces.png
