Bud-wiser-er/ERD320-FinalReport/EPR320_Group_45_Final_Report/01_SNC/diagrams/architecture_main_esp32/out/architecture_main_esp32.png

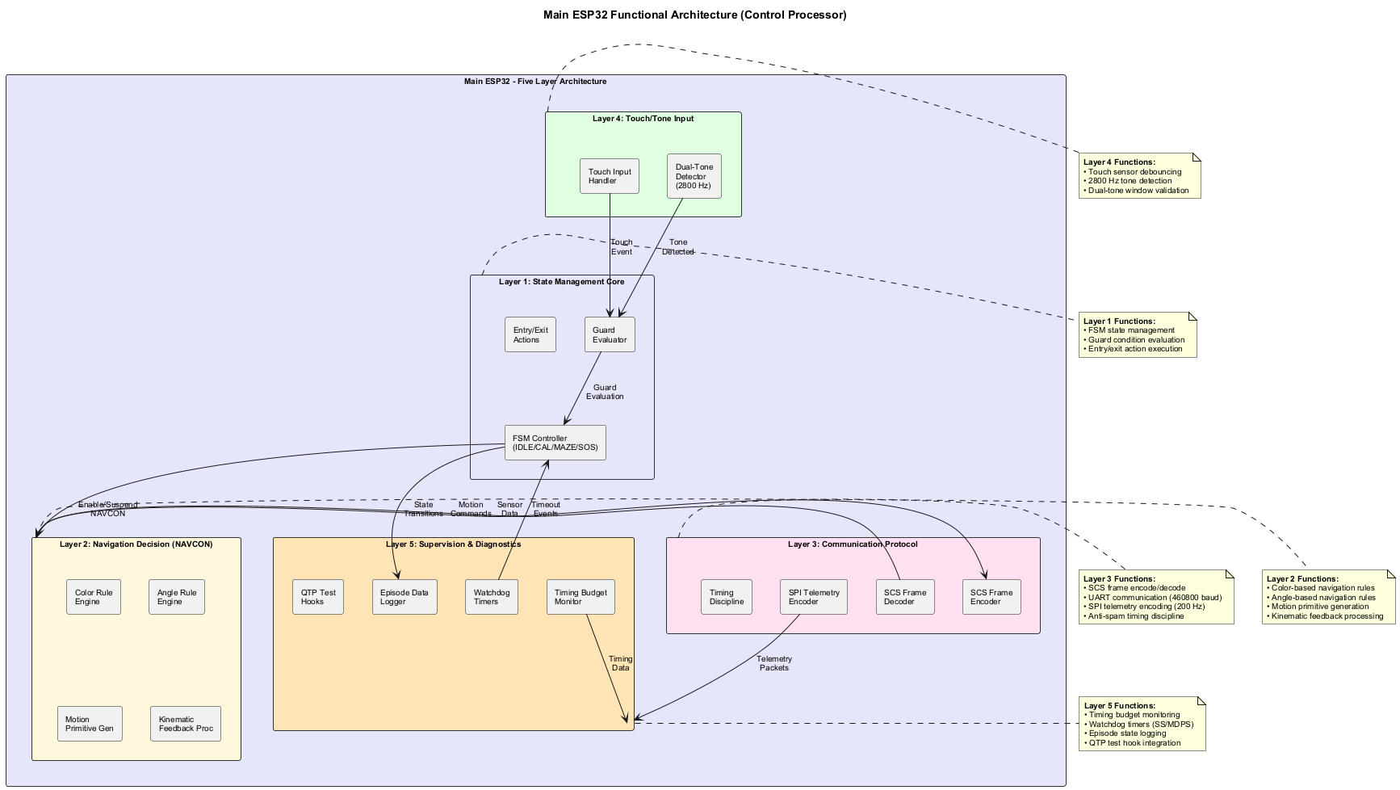
EPR320_Group_45_Final_Report/01_SNC/diagrams/architecture_main_esp32/out/architecture_main_esp32.png
