Bud-wiser-er/ERD320-FinalReport/EPR320_Group_45_Final_Report/01_SNC/diagrams/conops_swimlane/out/conops_swimlane.png

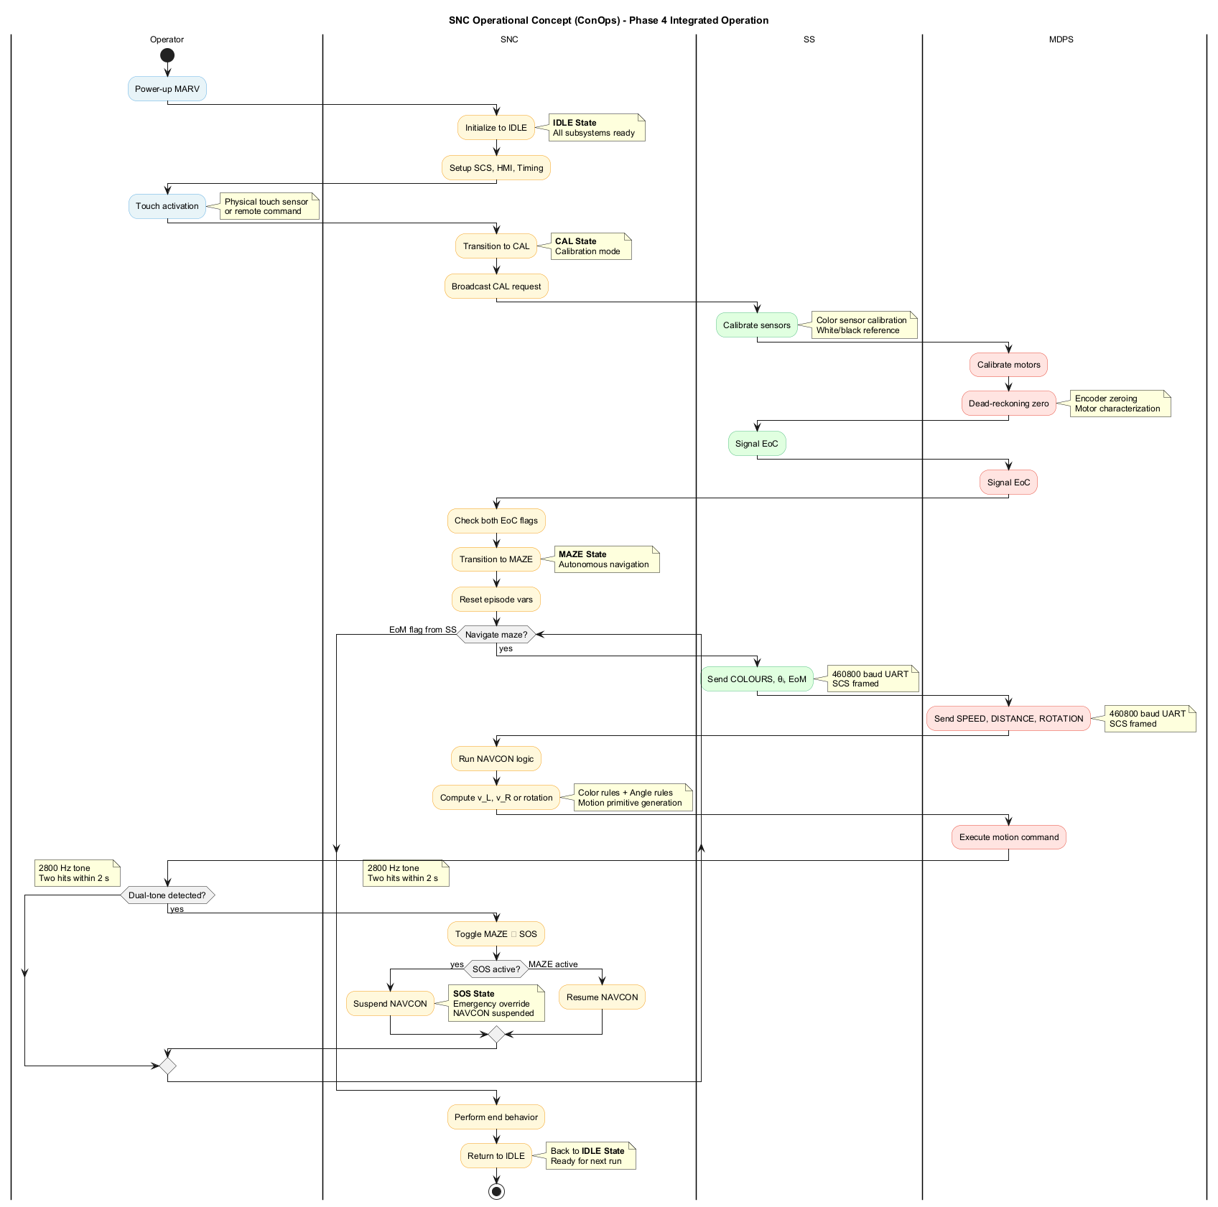
EPR320_Group_45_Final_Report/01_SNC/diagrams/conops_swimlane/out/conops_swimlane.png
