Bud-wiser-er/ERD320-FinalReport/EPR320_Group_45_Final_Report/01_SNC/diagrams/dataflow_main_control/out/dataflow_main_control.png

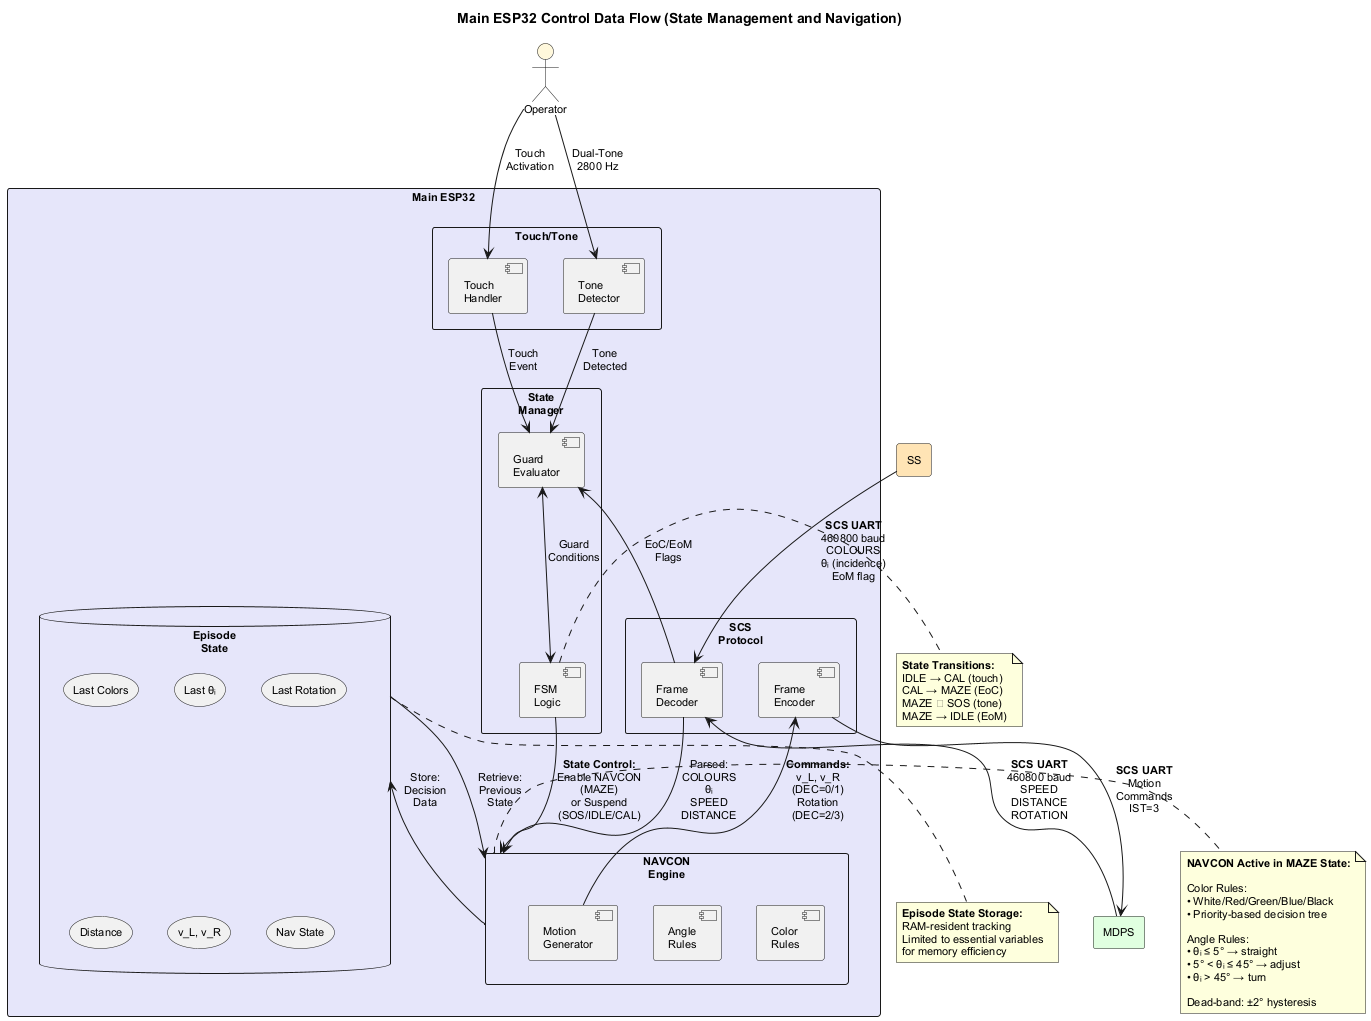
EPR320_Group_45_Final_Report/01_SNC/diagrams/dataflow_main_control/out/dataflow_main_control.png
