Bud-wiser-er/ERD320-FinalReport/EPR320_Group_45_Final_Report/01_SNC/diagrams/dataflow_telemetry/out/dataflow_telemetry.png

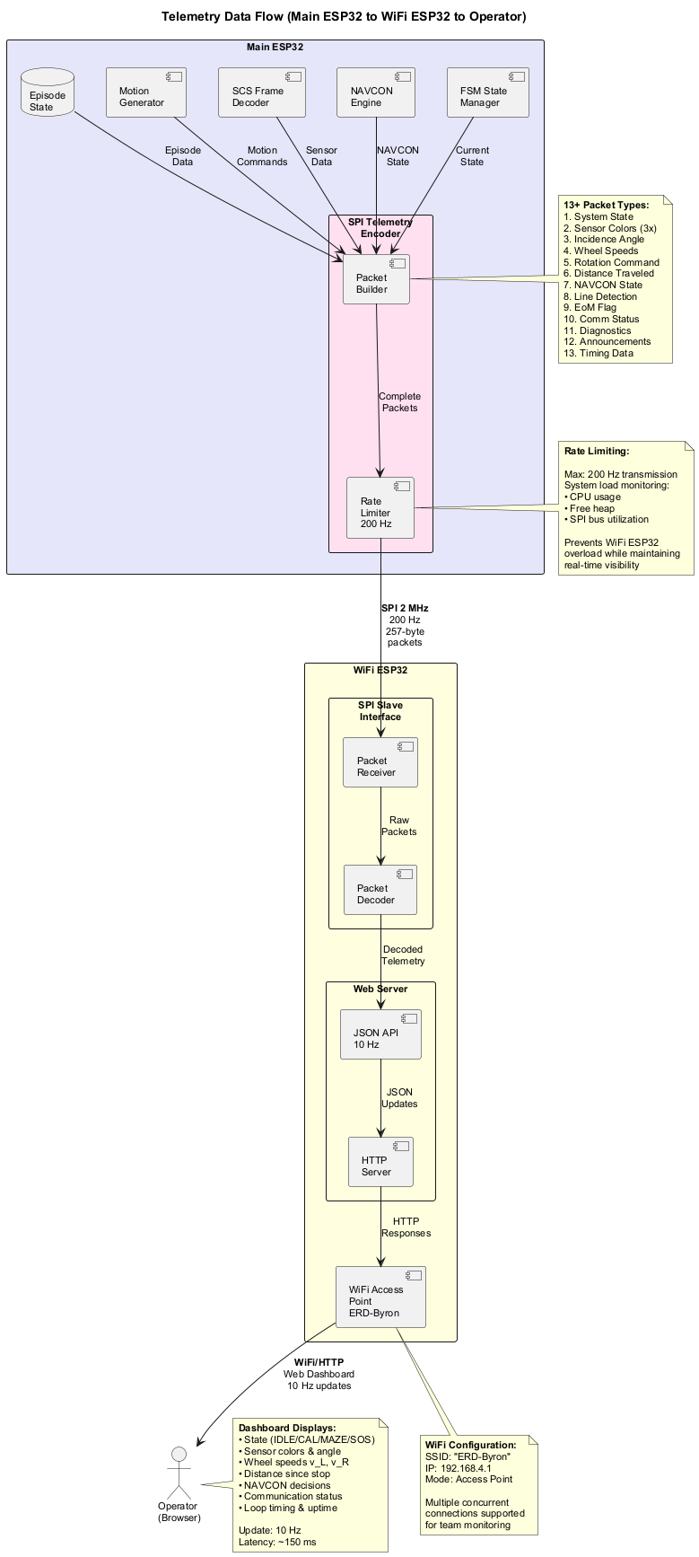
EPR320_Group_45_Final_Report/01_SNC/diagrams/dataflow_telemetry/out/dataflow_telemetry.png
