Bud-wiser-er/ERD320-FinalReport/EPR320_Group_45_Final_Report/01_SNC/diagrams/hmi_wireframe/out/hmi_wireframe.png

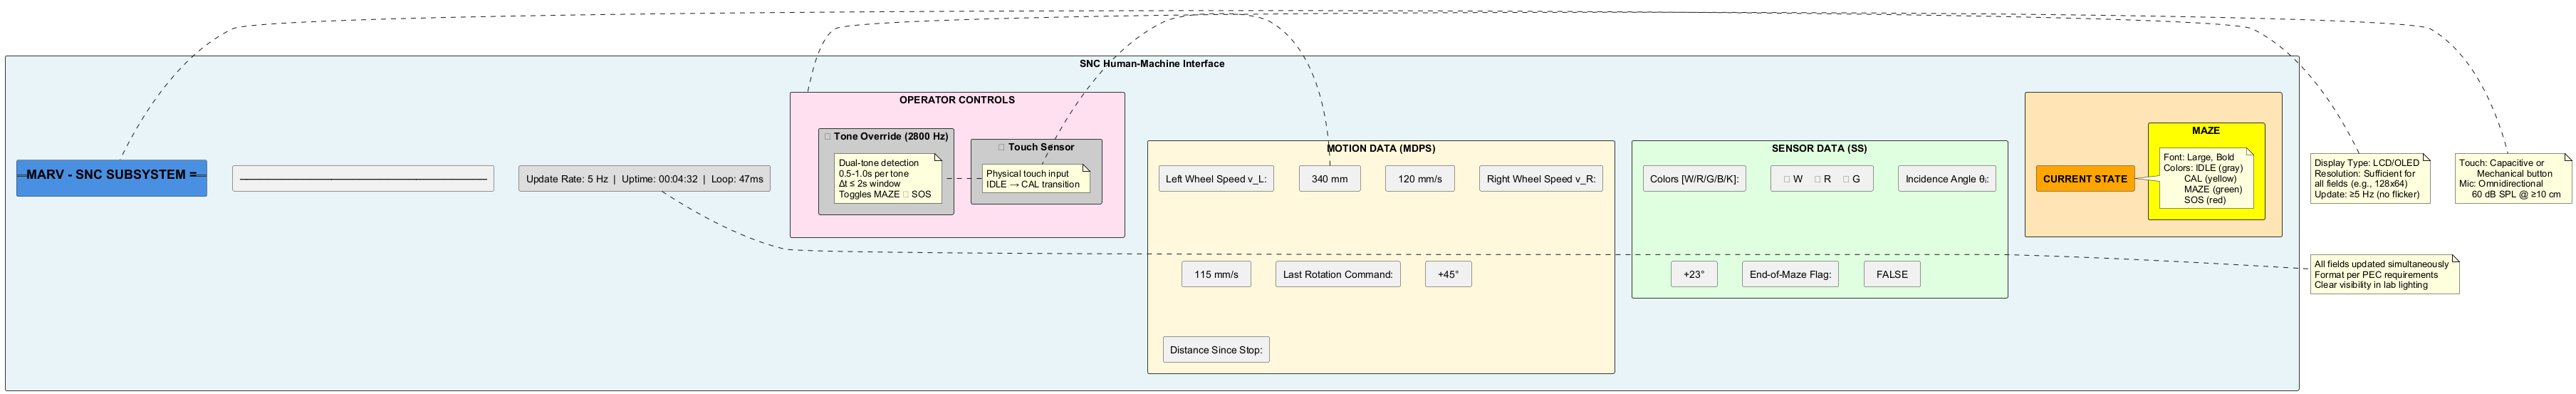
EPR320_Group_45_Final_Report/01_SNC/diagrams/hmi_wireframe/out/hmi_wireframe.png
