Bud-wiser-er/ERD320-FinalReport/EPR320_Group_45_Final_Report/01_SNC/diagrams/icd_sketch/out/icd_sketch.png

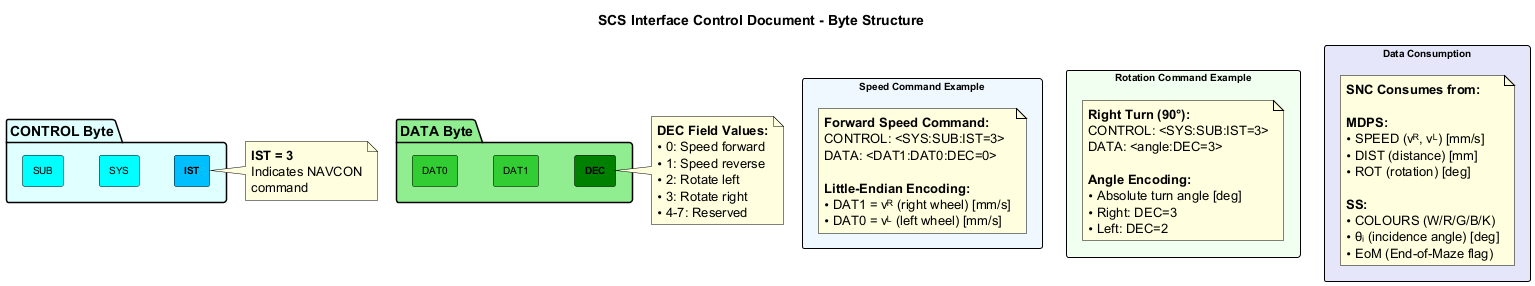
EPR320_Group_45_Final_Report/01_SNC/diagrams/icd_sketch/out/icd_sketch.png
