Bud-wiser-er/ERD320-FinalReport/EPR320_Group_45_Final_Report/01_SNC/diagrams/navcon_decision_logic/out/navcon_decision_logic.png

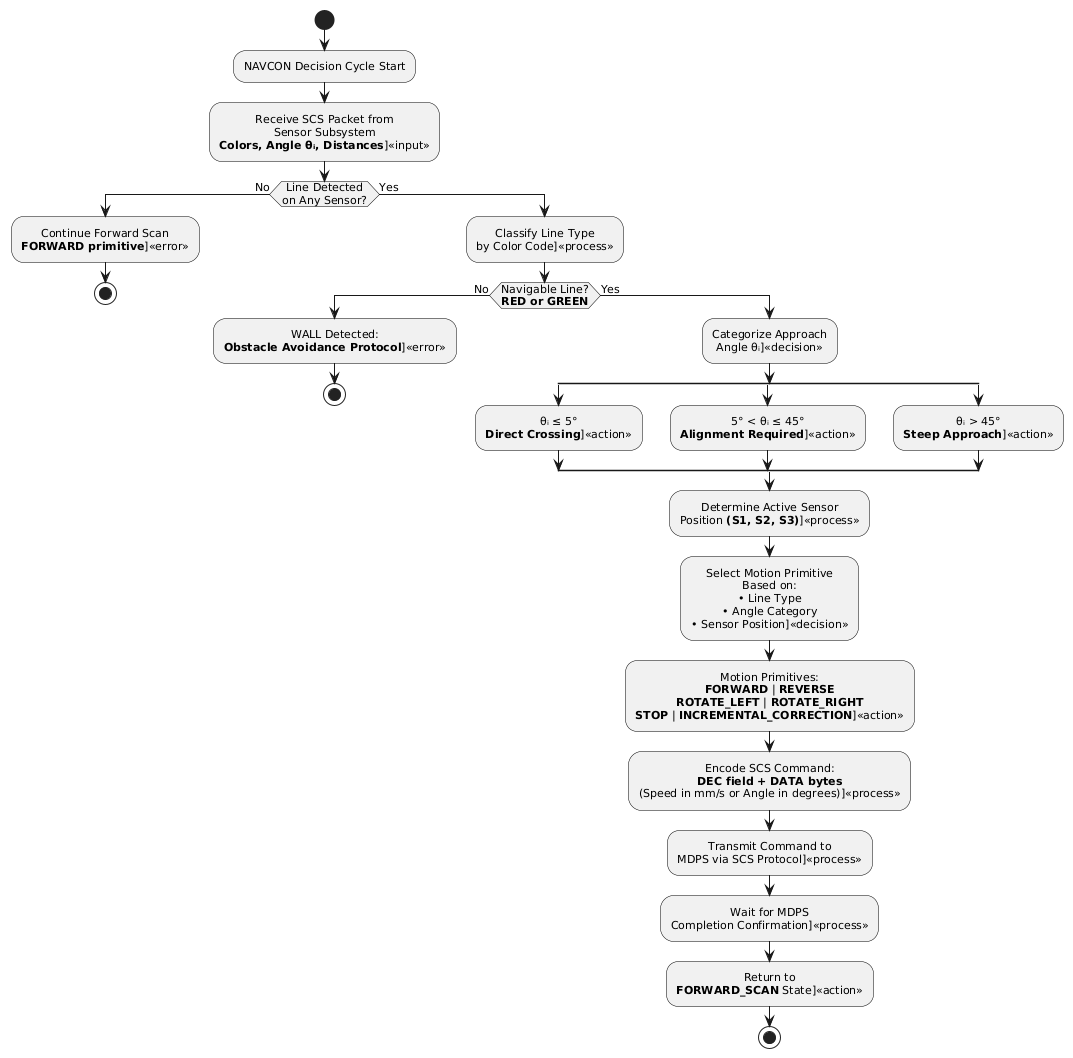
EPR320_Group_45_Final_Report/01_SNC/diagrams/navcon_decision_logic/out/navcon_decision_logic.png
