Bud-wiser-er/ERD320-FinalReport/EPR320_Group_45_Final_Report/01_SNC/diagrams/navcon_state_machine/out/navcon_state_machine.png

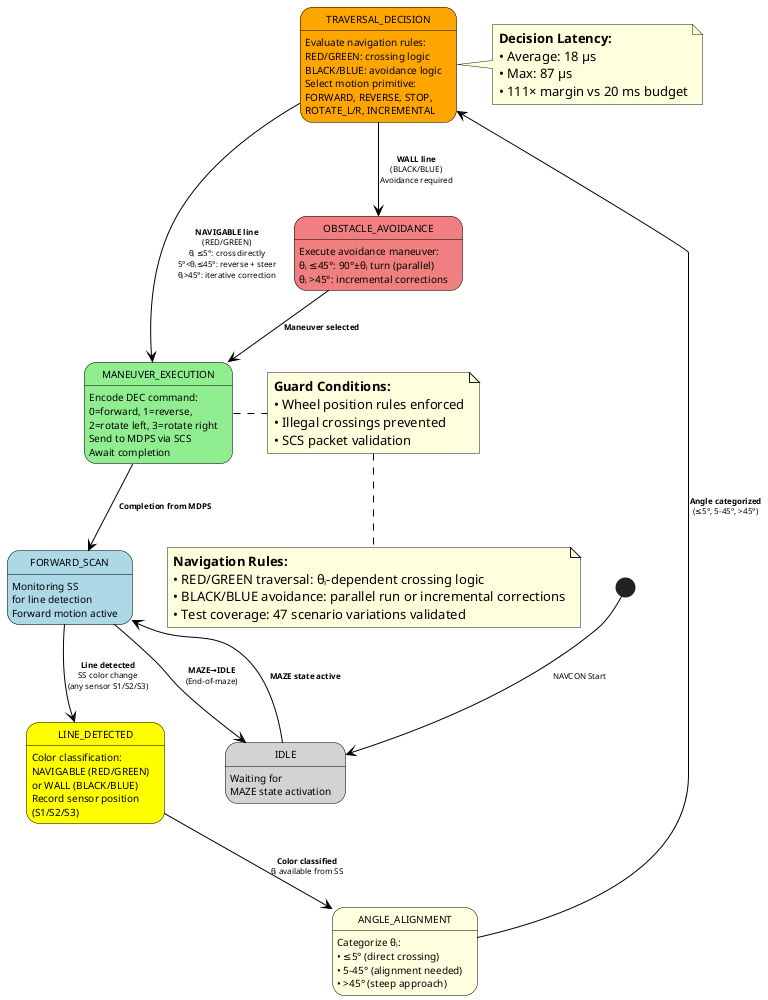
EPR320_Group_45_Final_Report/01_SNC/diagrams/navcon_state_machine/out/navcon_state_machine.png
