Bud-wiser-er/ERD320-FinalReport/EPR320_Group_45_Final_Report/01_SNC/diagrams/pure_tone_detection_flow/out/pure_tone_detection_flow.png

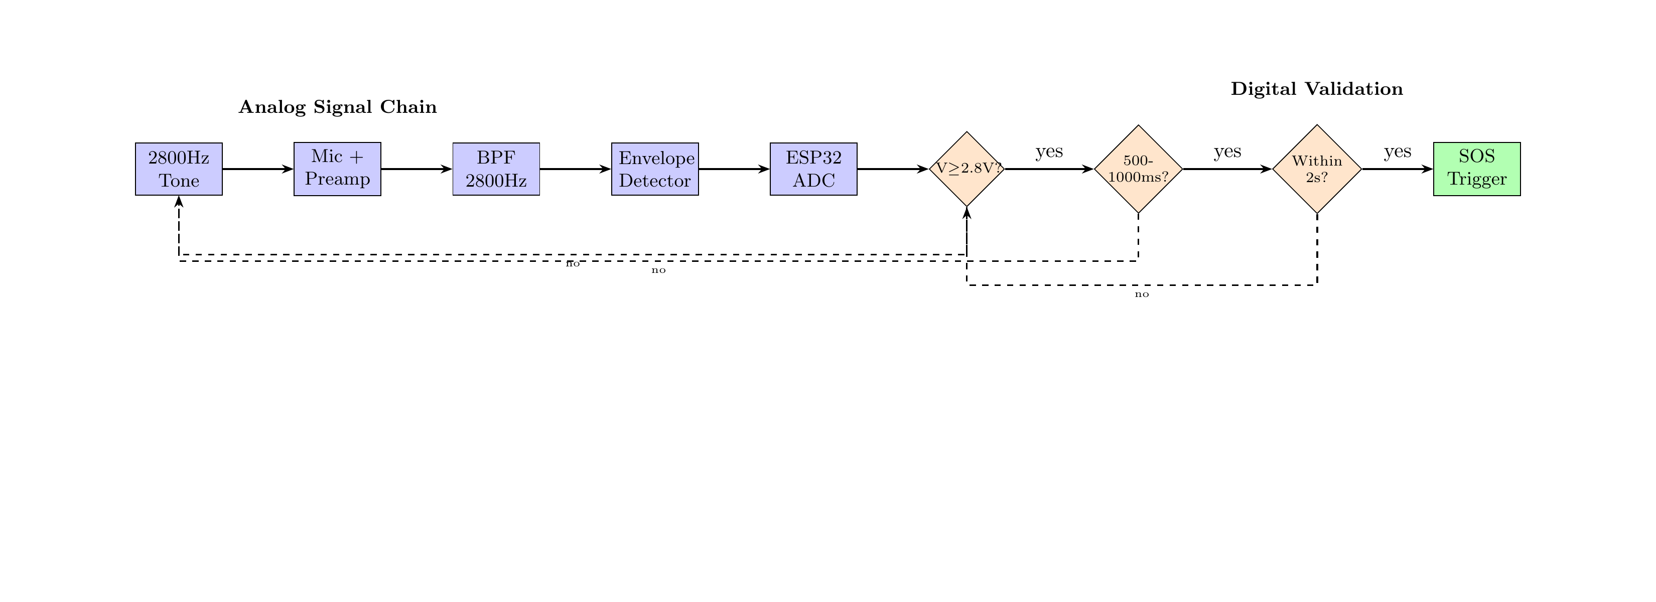
EPR320_Group_45_Final_Report/01_SNC/diagrams/pure_tone_detection_flow/out/pure_tone_detection_flow.png
