Bud-wiser-er/ERD320-FinalReport/EPR320_Group_45_Final_Report/01_SNC/diagrams/snc_architecture/out/snc_architecture.png

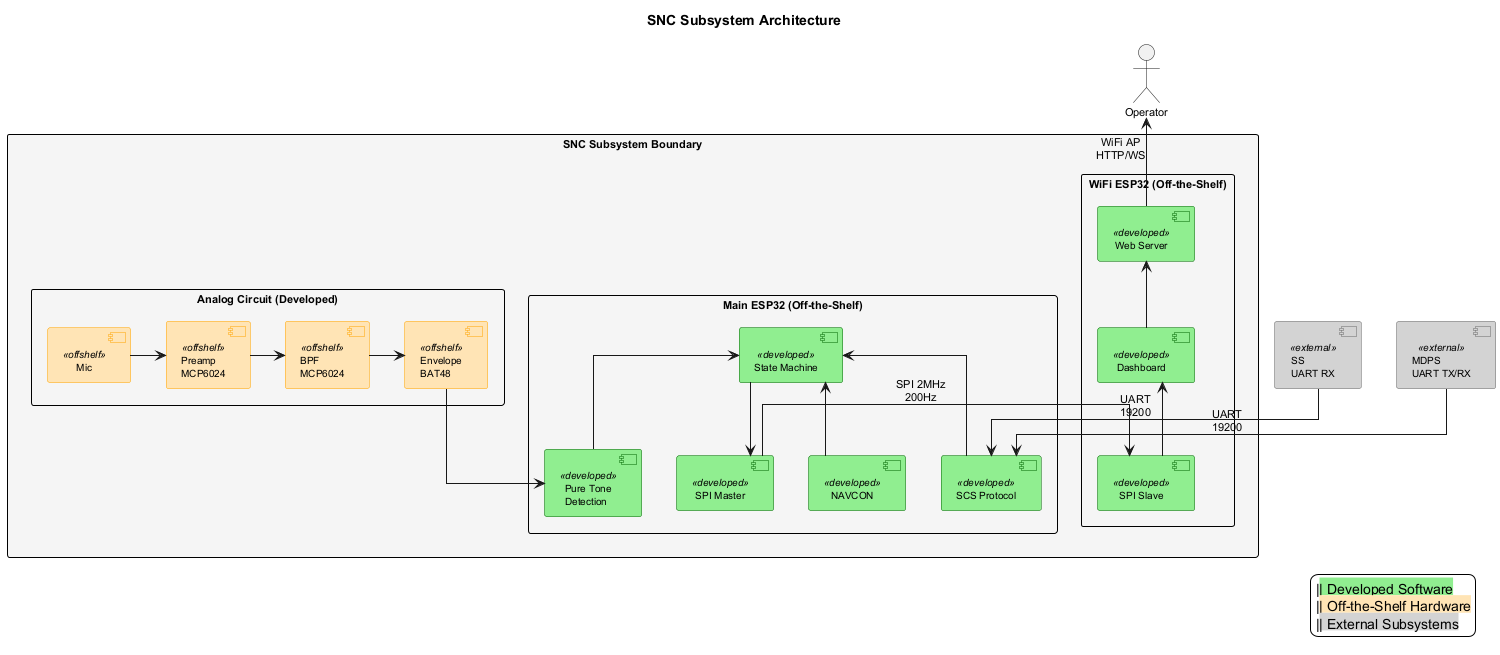
EPR320_Group_45_Final_Report/01_SNC/diagrams/snc_architecture/out/snc_architecture.png
