Bud-wiser-er/ERD320-FinalReport/EPR320_Group_45_Final_Report/01_SNC/diagrams/state_machine/out/state_machine.png

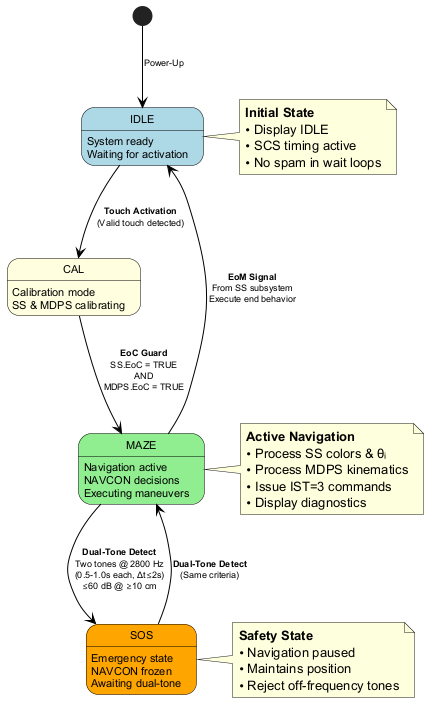
EPR320_Group_45_Final_Report/01_SNC/diagrams/state_machine/out/state_machine.png
