Bud-wiser-er/ERD320-FinalReport/EPR320_Group_45_Final_Report/01_SNC/diagrams/tone_detection_signal_chain/out/tone_detection_signal_chain.png

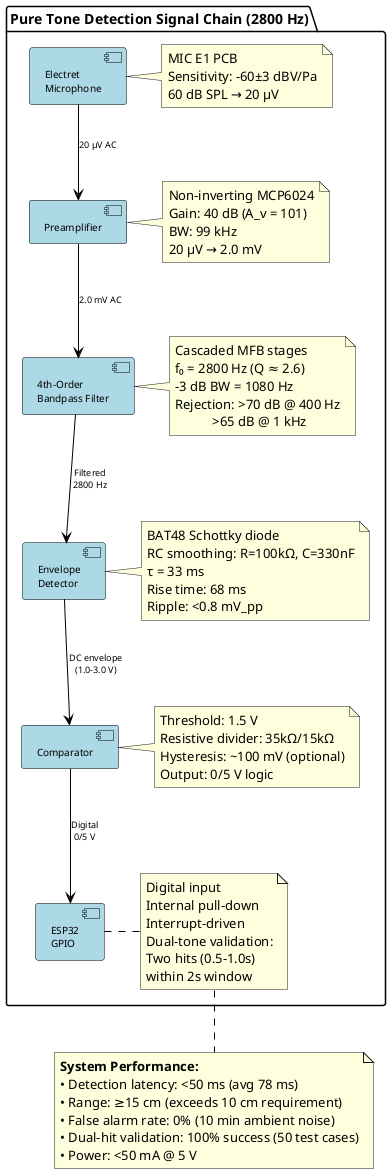
EPR320_Group_45_Final_Report/01_SNC/diagrams/tone_detection_signal_chain/out/tone_detection_signal_chain.png
