Bud-wiser-er/ERD320-FinalReport/EPR320_Group_45_Final_Report/02_SS/figures/blue_on_black.png

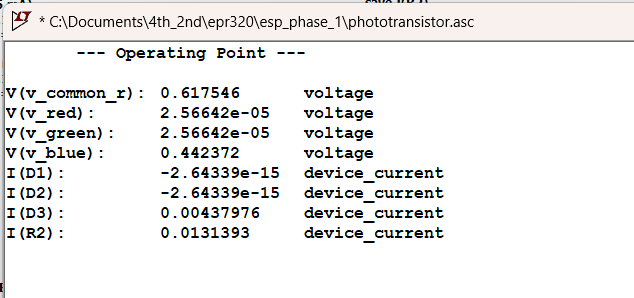
EPR320_Group_45_Final_Report/02_SS/figures/blue_on_black.png
