Bud-wiser-er/ERD320-FinalReport/EPR320_Group_45_Final_Report/02_SS/figures/functional_block_diagram.png

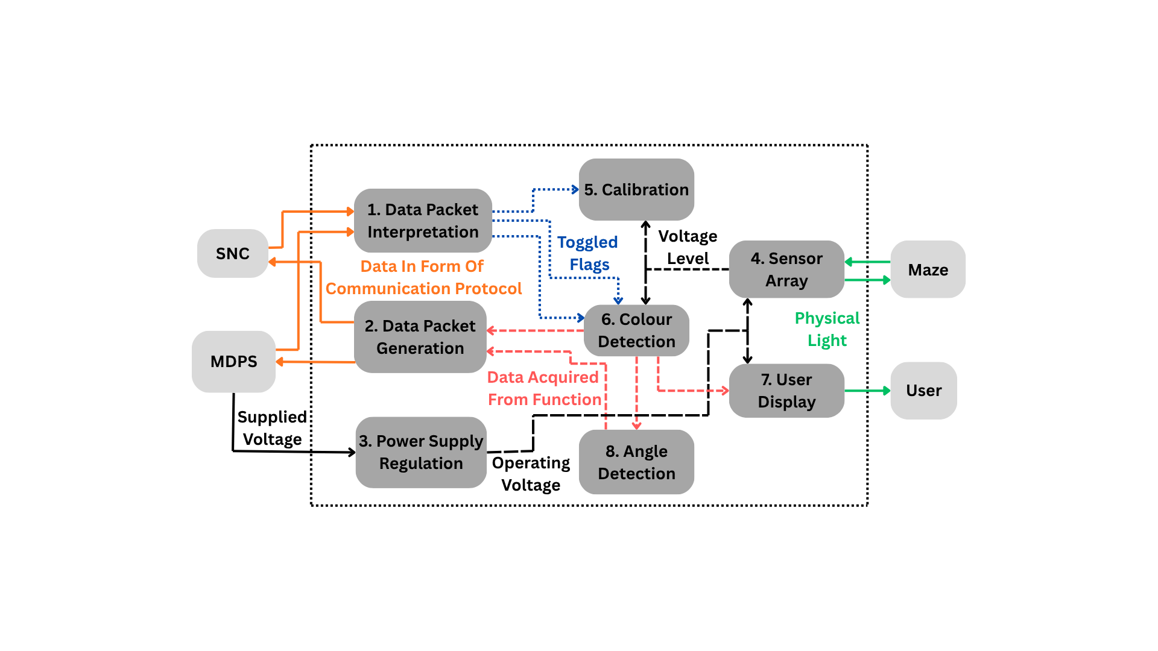
EPR320_Group_45_Final_Report/02_SS/figures/functional_block_diagram.png
