Bud-wiser-er/ERD320-FinalReport/EPR320_Group_45_Final_Report/02_SS/figures/green_on_green.png

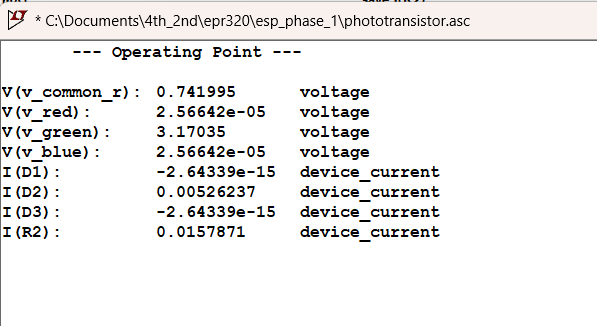
EPR320_Group_45_Final_Report/02_SS/figures/green_on_green.png
