Bud-wiser-er/ERD320-FinalReport/EPR320_Group_45_Final_Report/03_MDPS/documents/Functional_Block_Diagram.png

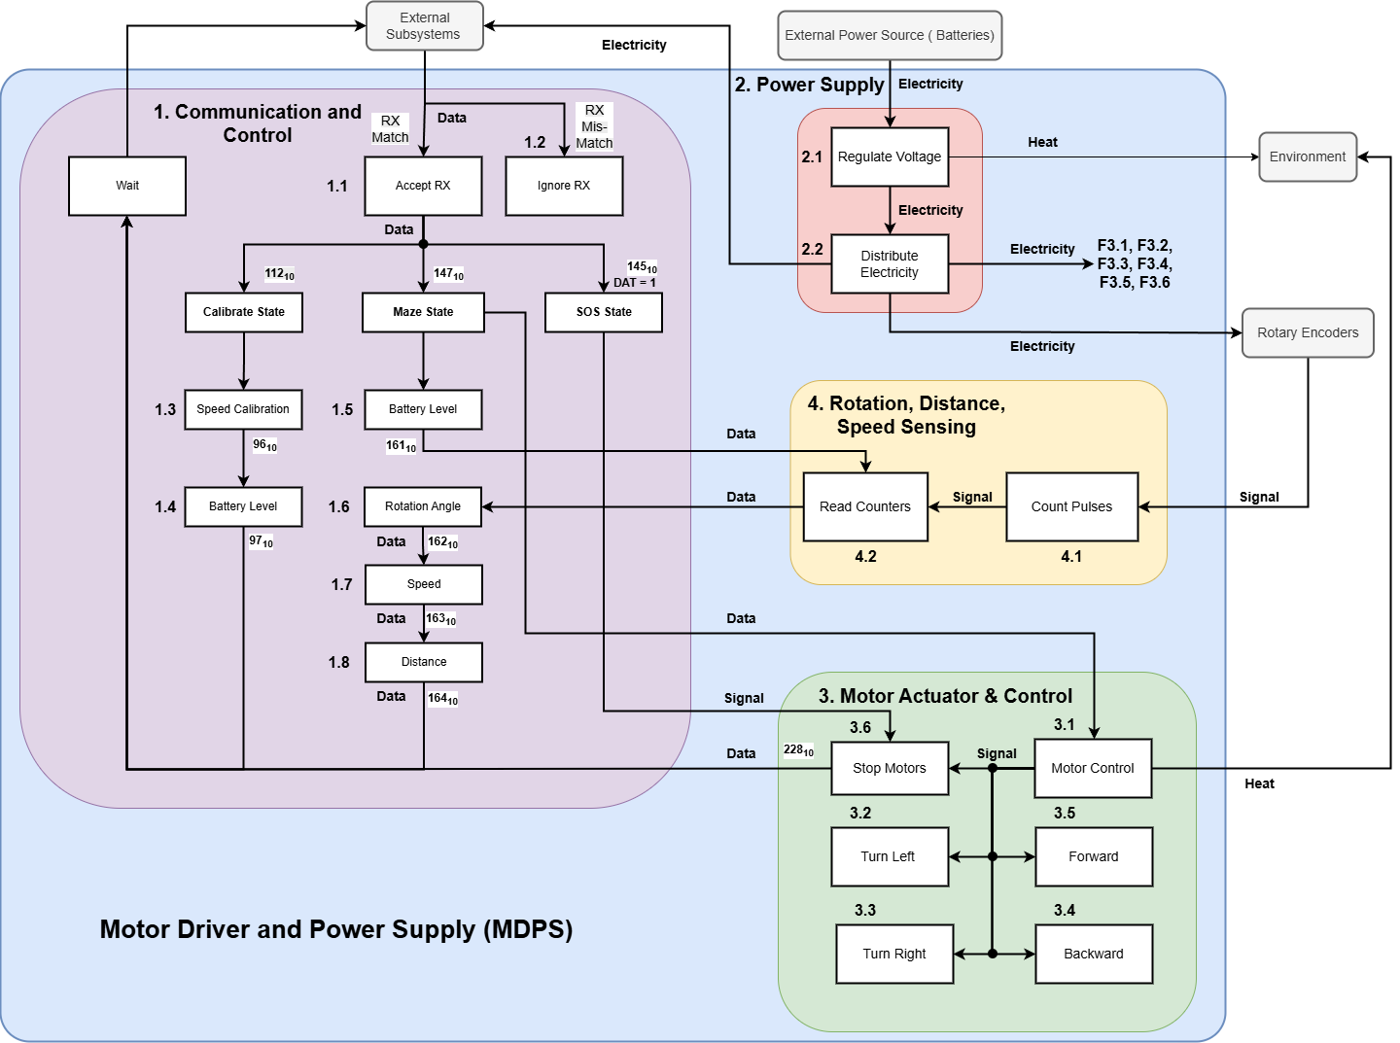
EPR320_Group_45_Final_Report/03_MDPS/documents/Functional_Block_Diagram.png
