Bud-wiser-er/ERD320-FinalReport/EPR320_Group_45_Final_Report/figures/copyright.png

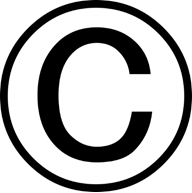
EPR320_Group_45_Final_Report/figures/copyright.png
