Bud-wiser-er/ERD320-FinalReport/Phase3/out/Documentation/FlowCharts/2_Pure_Tone_Detection_Flow/Pure_Tone_Detection_Flow.png

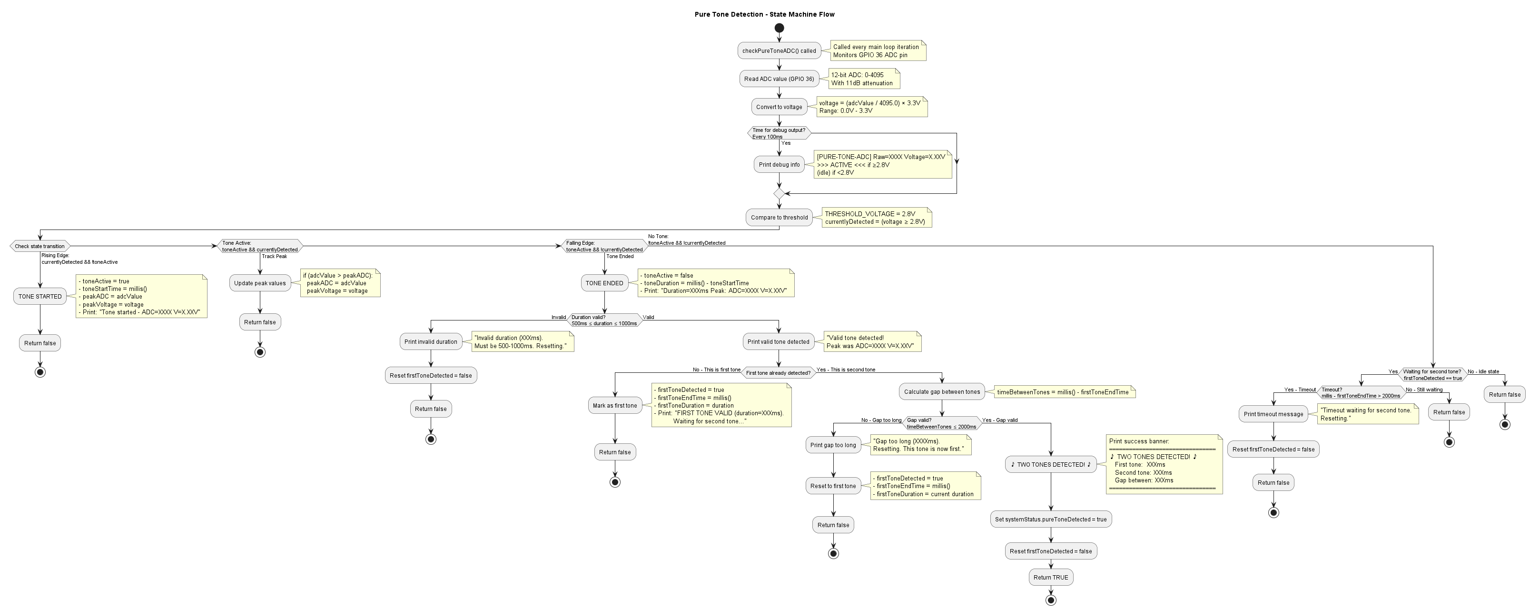
Phase3/out/Documentation/FlowCharts/2_Pure_Tone_Detection_Flow/Pure_Tone_Detection_Flow.png
