Bud-wiser-er/ERD320-FinalReport/Phase3/out/Documentation/FlowCharts/3_Edge_Case_Matrix/Edge_Case_Matrix.png

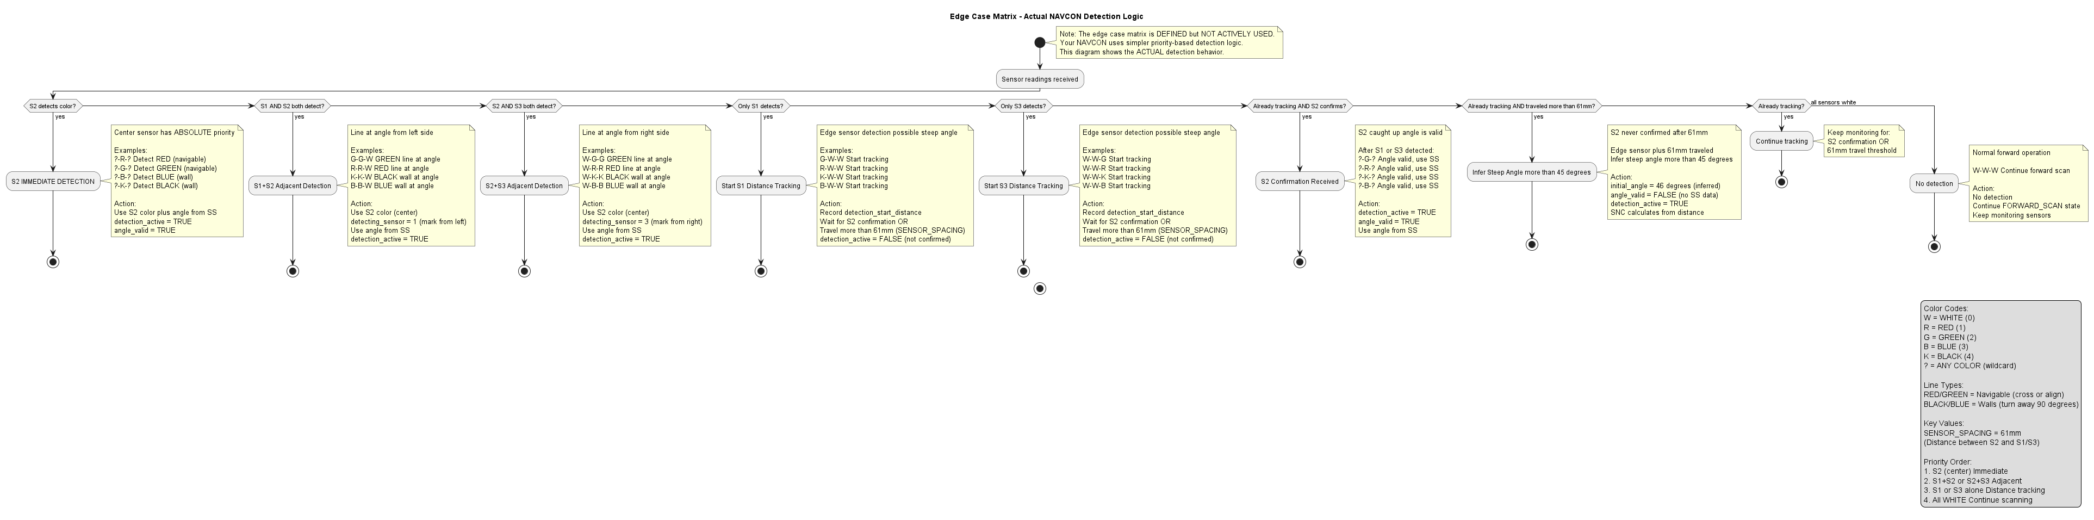
Phase3/out/Documentation/FlowCharts/3_Edge_Case_Matrix/Edge_Case_Matrix.png
