Bud-wiser-er/ERD320-FinalReport/Phase3/out/Documentation/FlowCharts/4_updateLineDetectionWithEdgeCases_Flow/updateLineDetectionWithEdgeCases_Flow.png

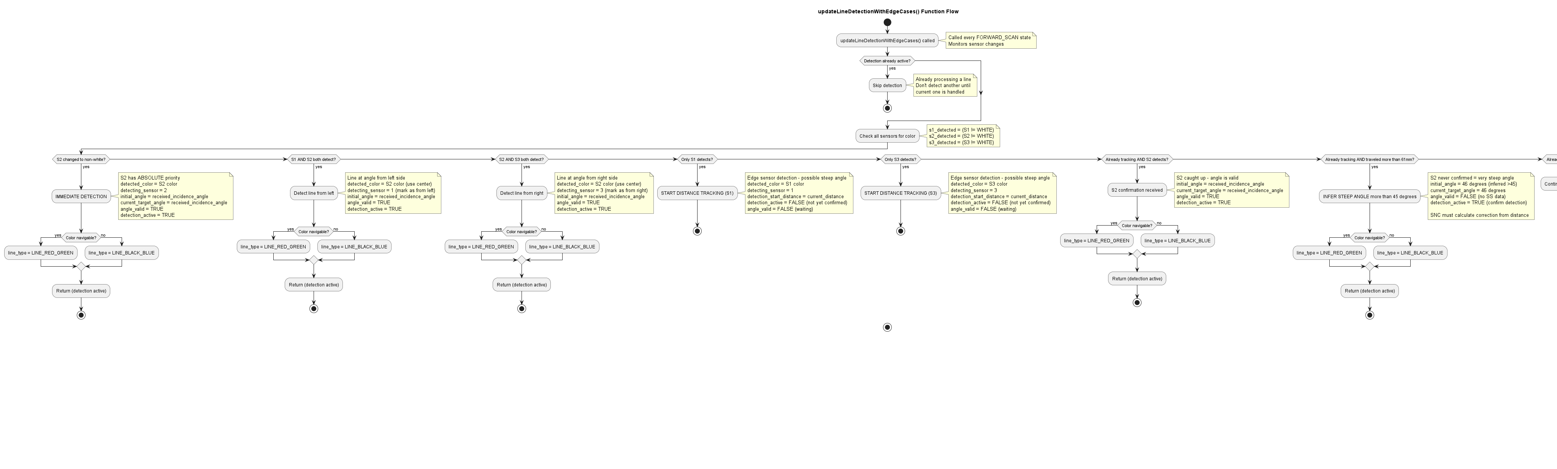
Phase3/out/Documentation/FlowCharts/4_updateLineDetectionWithEdgeCases_Flow/updateLineDetectionWithEdgeCases_Flow.png
