Bud-wiser-er/ERD320-FinalReport/Phase3/out/Documentation/FlowCharts/5_Distance_Tracking_Steep_Angle/Distance_Tracking_Steep_Angle.png

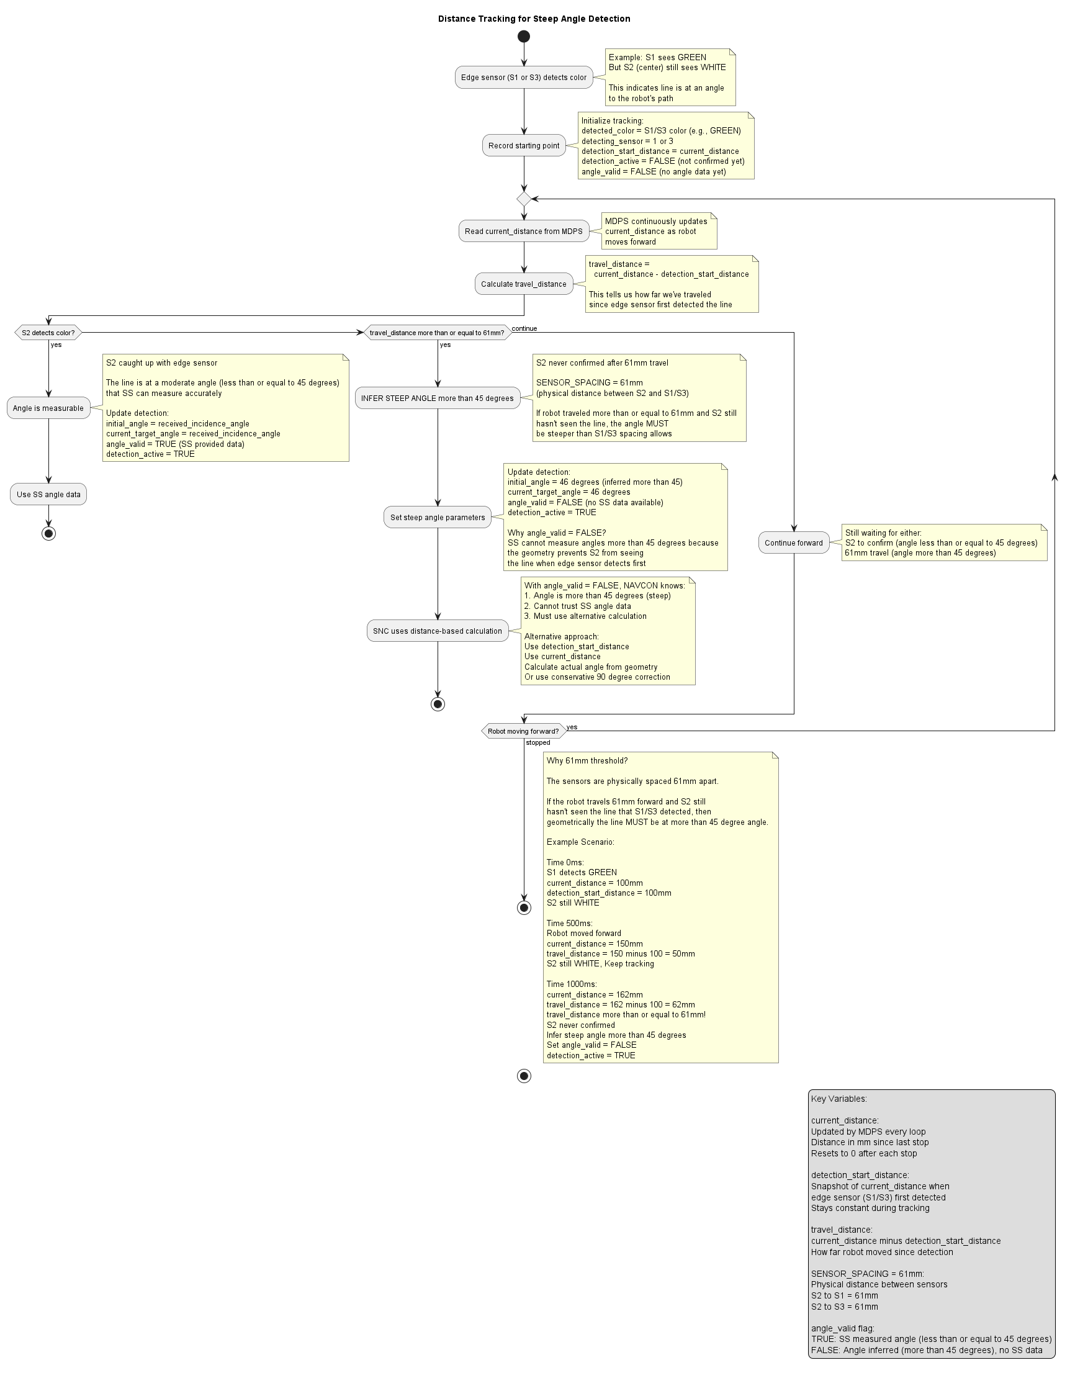
Phase3/out/Documentation/FlowCharts/5_Distance_Tracking_Steep_Angle/Distance_Tracking_Steep_Angle.png
