Bud-wiser-er/ERD320-FinalReport/Phase 0/Draw IO State diagrams/ERD_Comms.png

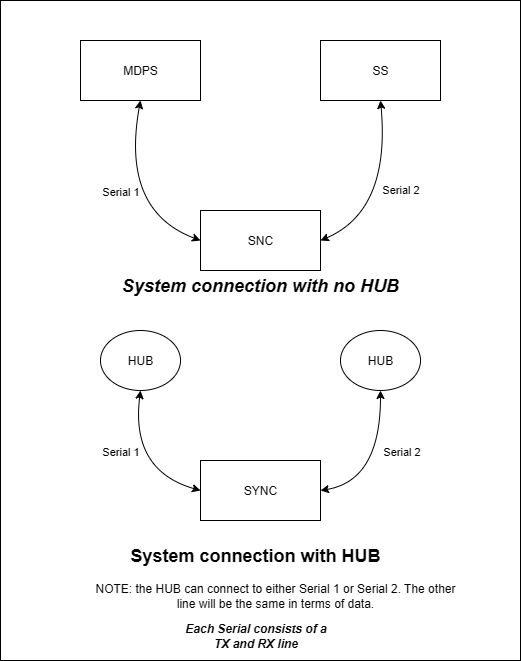
Phase 0/Draw IO State diagrams/ERD_Comms.png
