Bud-wiser-er/ERD320-FinalReport/Phase 0/Draw IO State diagrams/Serial_Forwarding.png

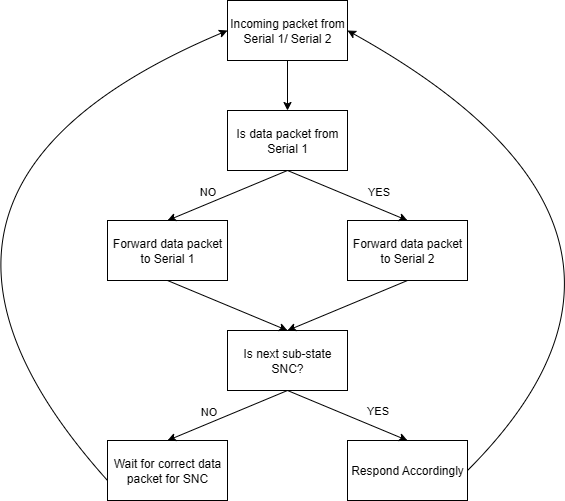
Phase 0/Draw IO State diagrams/Serial_Forwarding.png
