Bud-wiser-er/ERD320-FinalReport/Phase 0/State Diagrams/mermaid224744.png

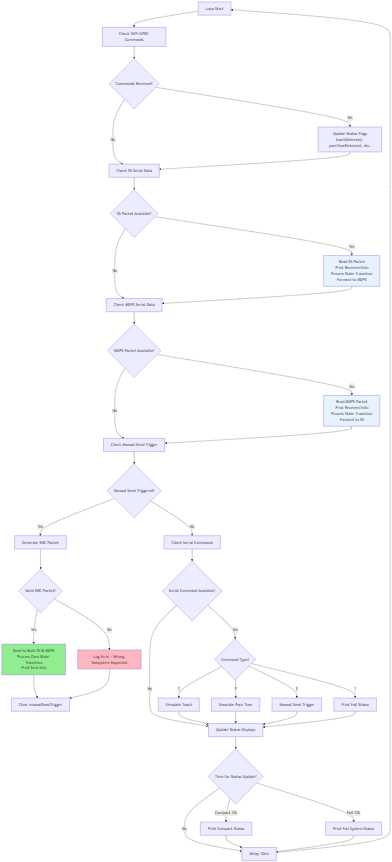
Phase 0/State Diagrams/mermaid224744.png
