Bud-wiser-er/ERD320-FinalReport/Phase 0/State Diagrams/mermaid225206.jpg

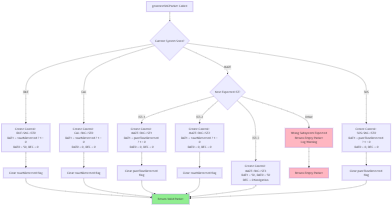
Phase 0/State Diagrams/mermaid225206.jpg
