Bud-wiser-er/ERD320-FinalReport/Phase 0/State Diagrams/PacketGneration.png

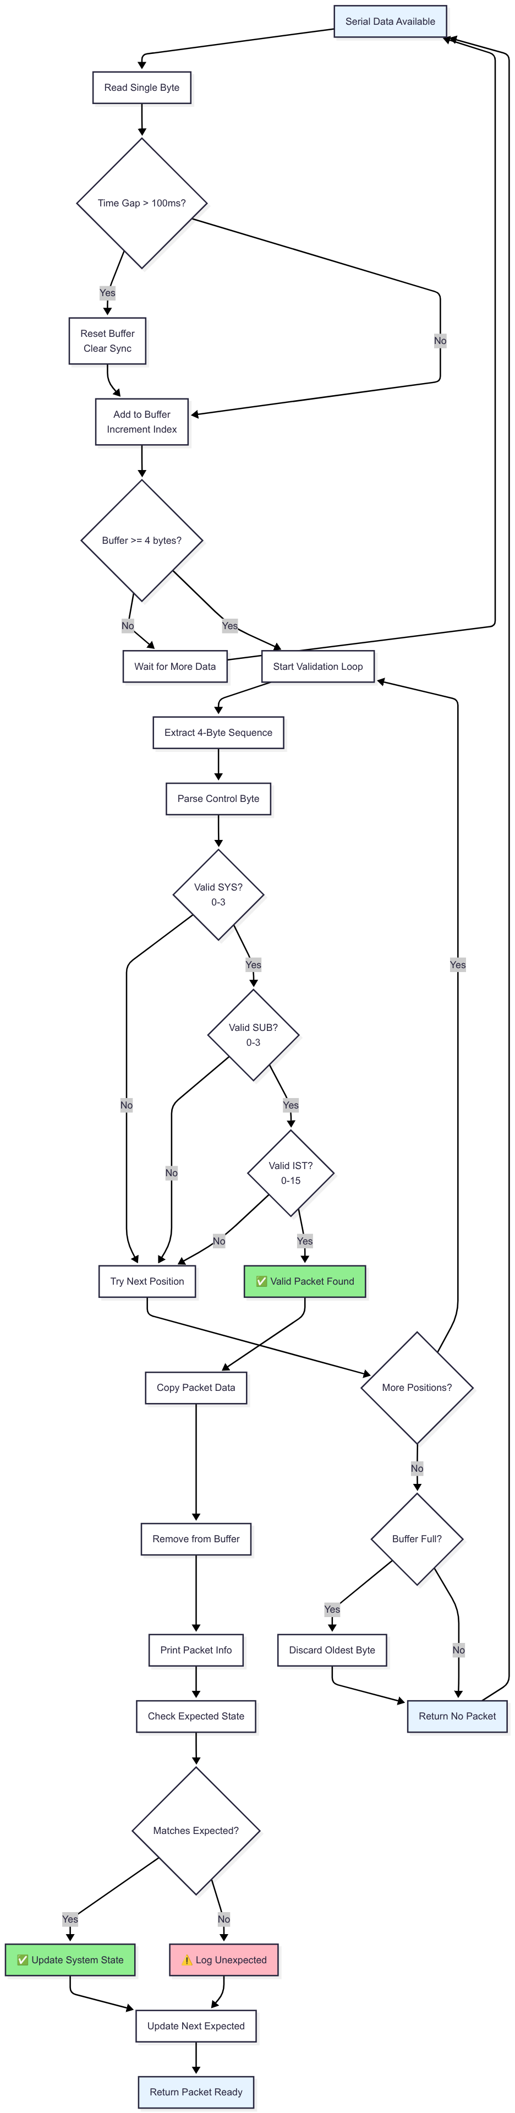
Phase 0/State Diagrams/PacketGneration.png
