Bud-wiser-er/ERD320-FinalReport/Phase 0/State Diagrams/SerailDataFlow.png

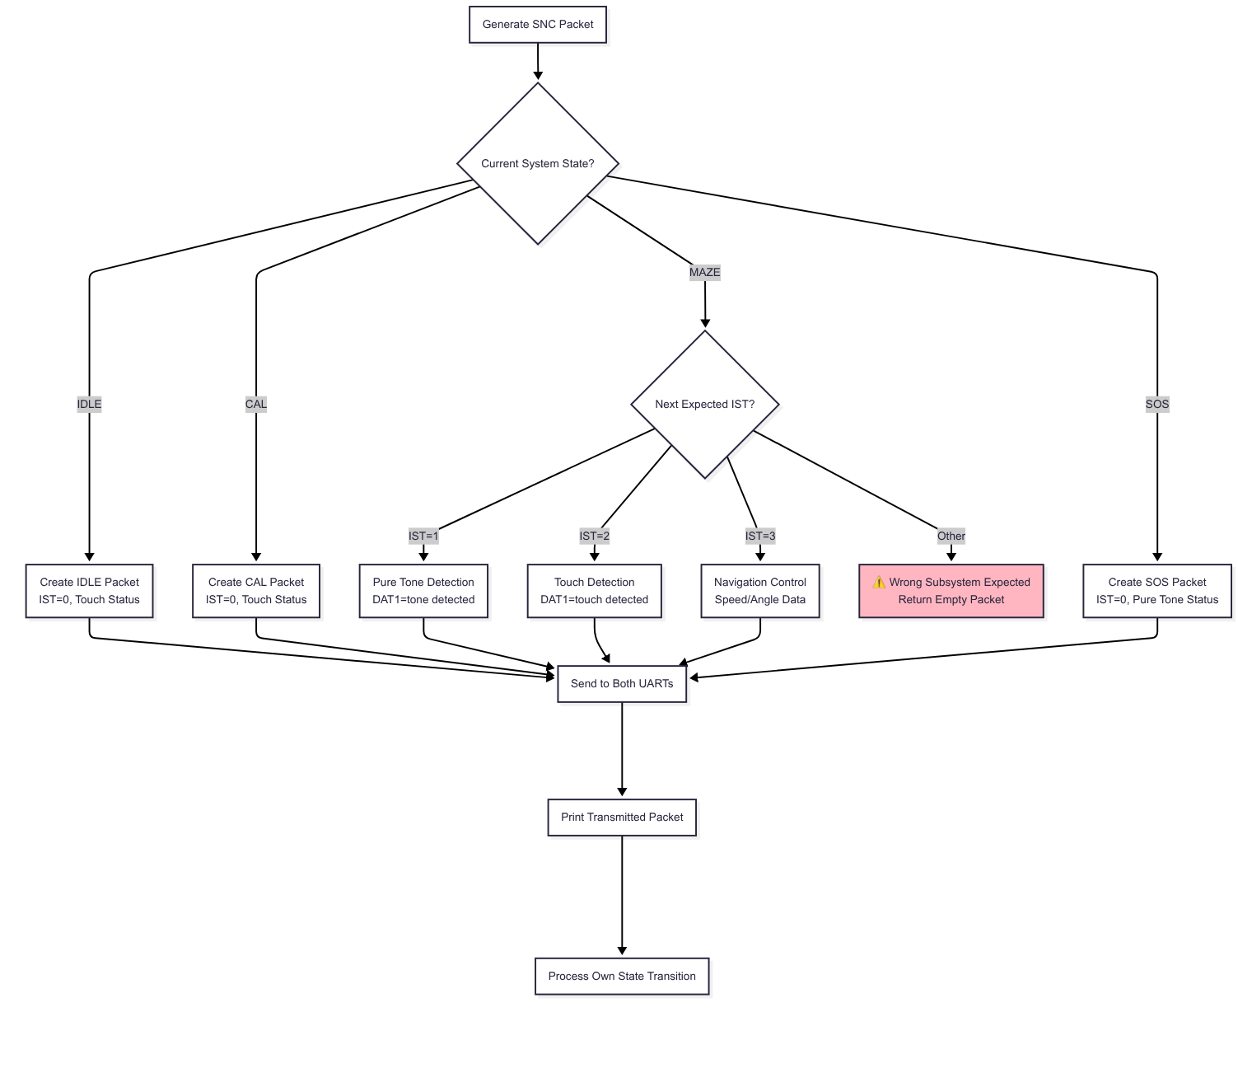
Phase 0/State Diagrams/SerailDataFlow.png
