Bud-wiser-er/ERD320-FinalReport/Phase 0/State Diagrams/SSC_StanmeMachine.png

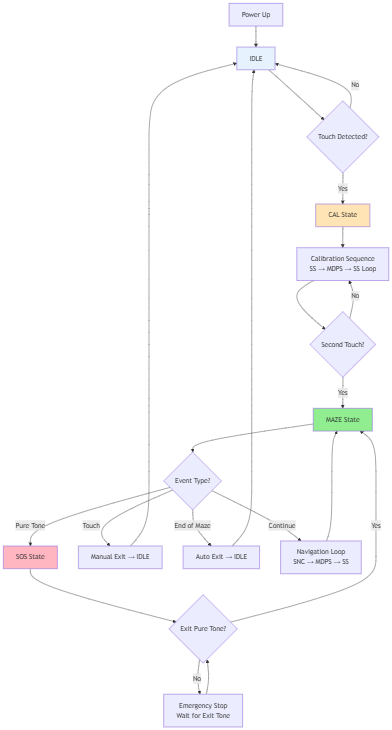
Phase 0/State Diagrams/SSC_StanmeMachine.png
