Bud-wiser-er/ERD320-FinalReport/Phase 0/State Diagrams/StateMachine.png

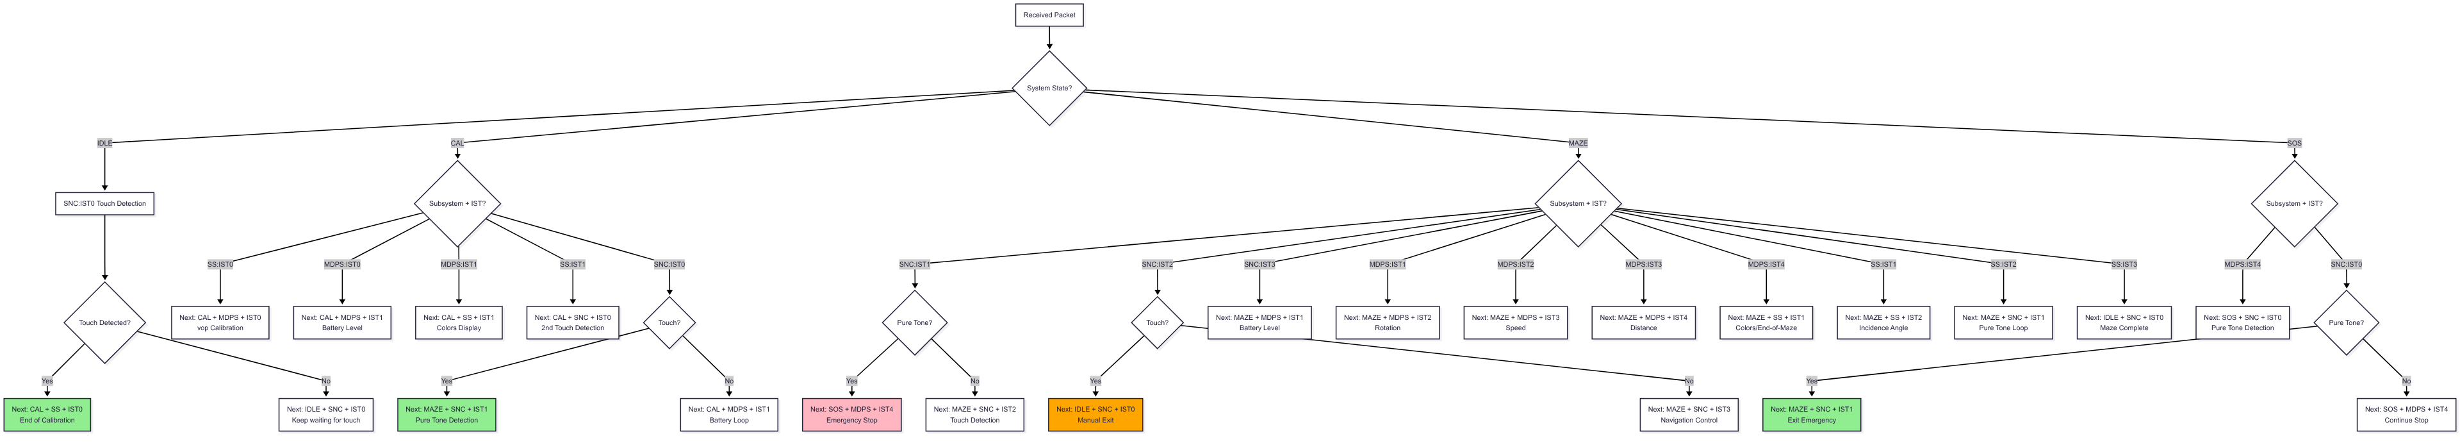
Phase 0/State Diagrams/StateMachine.png
