Bud-wiser-er/ERD320-FinalReport/Phase 1/Cap Touch/FullSim_connected.jpg

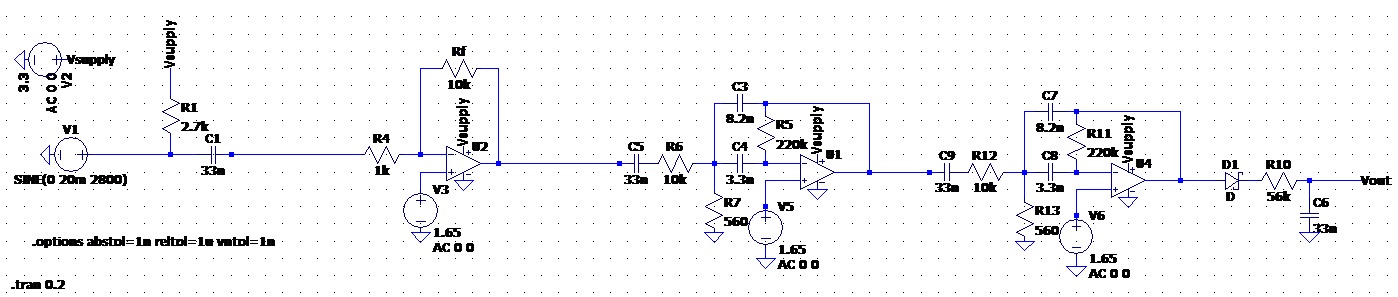
Phase 1/Cap Touch/FullSim_connected.jpg
