Bud-wiser-er/ERD320-FinalReport/Phase 1/Cap Touch/Response.png

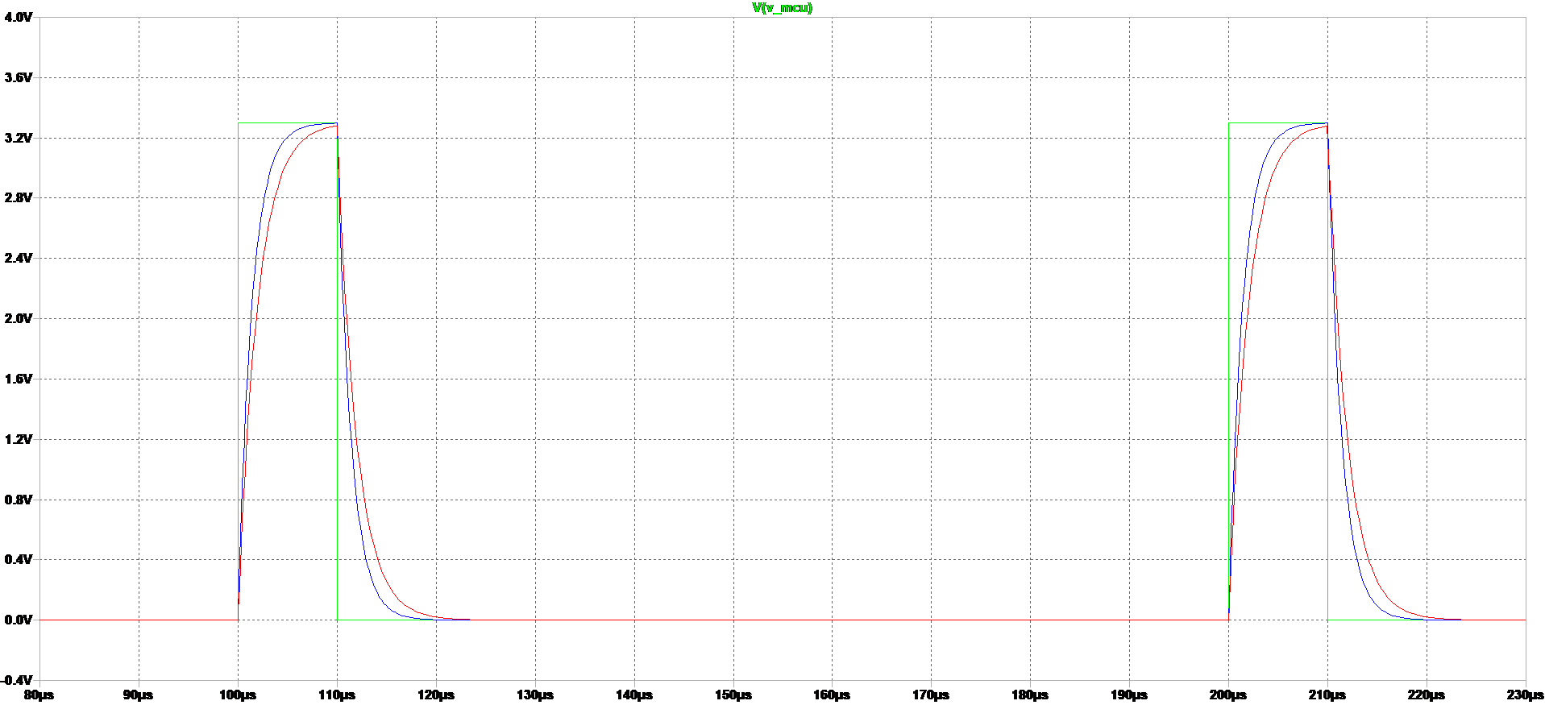
Phase 1/Cap Touch/Response.png
