Bud-wiser-er/ERD320-FinalReport/Phase 1/Cap Touch/Schematic.png

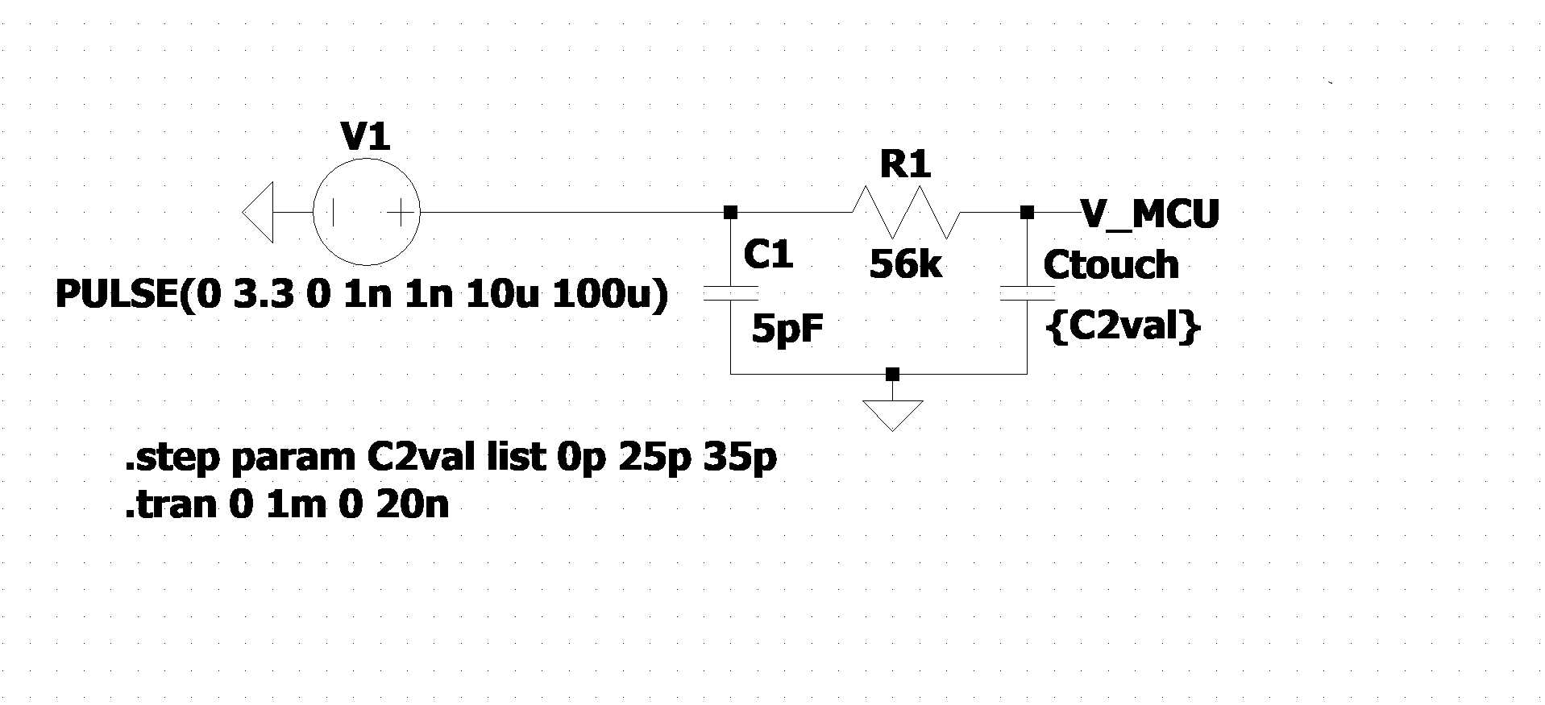
Phase 1/Cap Touch/Schematic.png
