Bud-wiser-er/ERD320-FinalReport/Phase 1/NAVCON/NAVCON.png

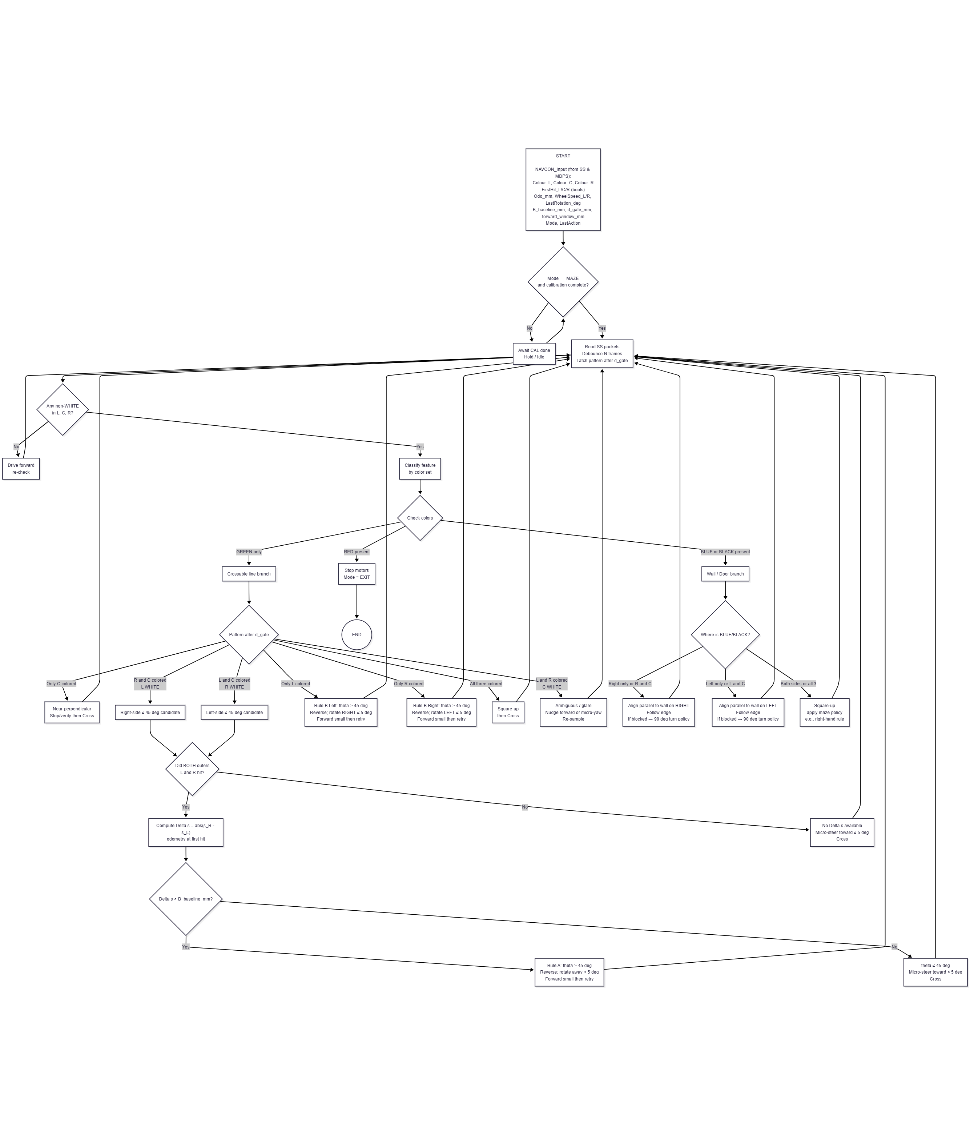
Phase 1/NAVCON/NAVCON.png
