Bud-wiser-er/ERD320-FinalReport/Verification/Phase2_Lab_Results/Pure_Tone_Oscilloscope/New MFB second order combined with MIC/TEK00002.PNG

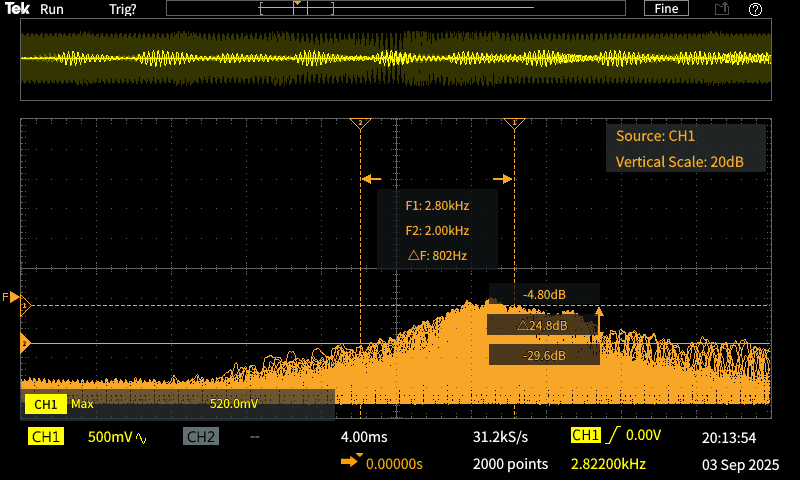
Verification/Phase2_Lab_Results/Pure_Tone_Oscilloscope/New MFB second order combined with MIC/TEK00002.PNG
