Bud-wiser-er/ERD320-FinalReport/Phase3/Phase3/SETUP_INSTRUCTIONS.md

# MARV WiFi Communication System - Setup Instructions

## Overview
This system provides real-time WiFi monitoring and control for your MARV robot using two ESP32 modules:
- **Main ESP32**: Runs your existing MARV control system + SPI communication
- **WiFi ESP32**: Receives SPI data and serves a professional web interface

## Hardware Requirements
- 2x ESP32 Development Boards
- Jumper wires for connections
- WiFi network for remote access

## Wiring Connections

### SPI Communication (Main ESP32 → WiFi ESP32)
```
Main ESP32          →    WiFi ESP32
GPIO 18 (SCK)       →    GPIO 18 (SCK)
GPIO 23 (MOSI)      →    GPIO 19 (MISO)
GPIO 15 (CS)        →    GPIO 5  (CS)
GND                 →    GND
3.3V                →    3.3V
```

### GPIO Commands (WiFi ESP32 → Main ESP32)
```
WiFi ESP32          →    Main ESP32
GPIO 4              →    GPIO 4  (Touch Command)
GPIO 2              →    GPIO 2  (Pure Tone Command)
GPIO 15             →    GPIO 15 (Send Packet Command)
```

## Software Setup

### Step 1: Prepare Main ESP32
1. Upload the enhanced `Phase3.ino` to your main ESP32
2. This includes all your existing NAVCON functionality PLUS efficient SPI communication
3. Monitor serial output to verify initialization

### Step 2: Configure WiFi ESP32
1. Open `ESP32_wifi_coms.ino`
2. **IMPORTANT**: Update WiFi credentials at the top:
   ```cpp
   const char* ssid = "YOUR_WIFI_SSID";
   const char* password = "YOUR_WIFI_PASSWORD";
   ```
3. Upload to the second ESP32

### Step 3: Power On and Connect
1. Power both ESP32s
2. WiFi ESP32 will connect to your network and display its IP address
3. Access the web interface from any device on the same network

## Features

### Real-Time Web Dashboard
- **System Status**: Connection state, system mode, navigation state
- **Sensor Display**: Color-coded visual sensor readings
- **Movement Data**: Real-time wheel speeds and movement information
- **Performance Monitor**: Packet statistics and communication health
- **Manual Controls**: Touch sensor, pure tone, and packet send buttons

### Mobile-Friendly Interface
- Responsive design works on phones, tablets, and computers
- Professional styling with gradients and animations
- Real-time updates every 100ms for responsive monitoring

### Efficient Communication
- **20Hz SPI polling** (every 50ms) - won't overload main ESP32
- **Rate-limited updates**: Different data types sent at optimized frequencies
  - System state: 5Hz (every 200ms)
  - Sensor data: 10Hz (every 100ms)
  - Movement data: 20Hz (every 50ms)
  - Heartbeat: 1Hz (every 1000ms)

## Performance Optimization

### Main ESP32 Protection
- SPI communication uses only **0.1ms per packet** (very fast)
- Total SPI overhead: **< 2ms per 50ms cycle** (< 4% CPU usage)
- GPIO checks remain responsive at 100Hz
- NAVCON and packet handling unchanged

### WiFi ESP32 Efficiency
- Dedicated WiFi handling
- Efficient memory management
- Automatic reconnection on WiFi loss
- Background SPI monitoring

## Usage Instructions

### Accessing the Web Interface
1. Check WiFi ESP32 serial monitor for IP address
2. Open browser on any device and navigate to: `http://[IP_ADDRESS]`
3. Bookmark for easy access

### Manual Controls
- **Touch Sensor**: Simulates touch detection via GPIO 4
- **Pure Tone**: Simulates pure tone detection via GPIO 2
- **Send Packet**: Triggers manual packet send via GPIO 15

### Monitoring Data
- All sensor colors displayed with visual indicators
- Real-time movement data and navigation states
- Performance statistics for troubleshooting
- Debug messages from main ESP32

## Troubleshooting

### WiFi ESP32 Won't Connect
1. Verify WiFi credentials are correct
2. Check WiFi network is 2.4GHz (ESP32 doesn't support 5GHz)
3. Monitor serial output for connection status

### No SPI Data Received
1. Verify all wiring connections, especially GND
2. Check that main ESP32 is powered and running
3. Ensure CS pin (GPIO 15) connection is secure

### Web Interface Not Loading
1. Verify WiFi ESP32 connected (check serial monitor)
2. Ping the IP address from your device
3. Try accessing from different device/browser

### GPIO Commands Not Working
1. Check GPIO wire connections (4, 2, 15)
2. Verify main ESP32 GPIO monitoring is active
3. Watch main ESP32 serial for GPIO debug messages

## Advanced Configuration

### Changing Update Rates
In `Phase3.ino`, modify the timing in `sendSPIUpdates()`:
```cpp
// Current: 20Hz updates (every 50ms)
if (millis() - lastSPIUpdate > 50) {

// For 10Hz: change to > 100
// For 5Hz: change to > 200
```

### Adding Custom Data
1. Define new packet type in `spi_protocol.h`
2. Add payload structure
3. Implement send function in `spi_protocol_impl.cpp`
4. Add processing in WiFi ESP32 `processPacket()`
5. Update web interface to display new data

### Custom Web Styling
Modify the CSS in `handleRoot()` function in `ESP32_wifi_coms.ino`

## Technical Specifications
- **SPI Speed**: 2MHz
- **Web Update Rate**: 100ms (10Hz)
- **SPI Packet Size**: ~256 bytes
- **Memory Usage**: < 200KB on WiFi ESP32
- **Network Latency**: < 50ms on local network

## Safety Features
- Automatic WiFi reconnection
- SPI communication error detection
- Performance monitoring and alerts
- Non-blocking operations preserve GPIO responsiveness
- Graceful degradation if WiFi ESP32 disconnects

## Support
Monitor serial outputs from both ESP32s for debugging information. The system provides comprehensive logging for troubleshooting any issues.
