Bud-wiser-er/ERD320-FinalReport/Phase3/Phase3/ESP32_Wifi_coms/SIMPLE_WIFI_GUIDE.md

# MARV WiFi ESP32 - Simple Hotspot Only

## ✅ No Confusion - Hotspot Only!

The code has been cleaned up to **ONLY create a WiFi hotspot**. There are no options for connecting to existing networks - it's completely simple and foolproof.

## How It Works

### ESP32 Creates WiFi Hotspot
- **Network Name**: `MARV-WiFi`
- **Password**: `marv1234`
- **Web Interface**: `http://192.168.4.1`

### Expected Serial Output
```
╔══════════════════════════════════════════════════════╗
║        MARV WiFi Communication System               ║
║        ESP32 WiFi Communications Module             ║
╚══════════════════════════════════════════════════════╝

Setup starting...
Will create WiFi hotspot: MARV-WiFi
GPIO pins initialized for communication with main ESP32
  Touch Command   -> GPIO 4
  Tone Command    -> GPIO 2
  Send Command    -> GPIO 15

About to initialize SPI...
SPI receiver initialized
SPI initialization complete

Starting WiFi connection...
Creating MARV WiFi hotspot...
Network Name: MARV-WiFi
Password: marv1234
✅ MARV WiFi hotspot created successfully!
📱 Connect your phone to: MARV-WiFi
🔐 Password: marv1234
🌐 Web interface: http://192.168.4.1

🎉 MARV WiFi System Ready!
════════════════════════════════════════════════════════
📱 WiFi Hotspot: MARV-WiFi
🔐 Password: marv1234
🌐 Web Interface: http://192.168.4.1
════════════════════════════════════════════════════════

Web server started and ready for connections

📋 Quick Connection Guide:
   1. Connect phone to WiFi: MARV-WiFi
   2. Use password: marv1234
   3. Open browser to: http://192.168.4.1
   4. Monitor MARV robot in real-time!

╔══════════════════════════════════════════════════════╗
║  System Ready - Monitoring SPI and serving web UI   ║
╚══════════════════════════════════════════════════════╝
```

## Usage Steps

1. **Upload code** to WiFi ESP32
2. **Look for "MARV-WiFi"** in your WiFi settings
3. **Connect with password "marv1234"**
4. **Browse to http://192.168.4.1**
5. **Enjoy real-time MARV monitoring!**

## Key Changes Made

### ❌ Removed All Confusing Options:
- No station mode
- No existing network connection
- No WiFi credential configuration
- No conditional compilation flags
- No backup network options

### ✅ Simple and Clean:
- Only creates WiFi hotspot
- Fixed network name and password
- Single clear connection method
- No configuration needed

## Benefits

- 🎯 **Zero configuration** - just upload and use
- 🚀 **Always works** - no network dependencies
- 📱 **Mobile friendly** - perfect for demos
- 🔧 **Reliable** - no WiFi setup issues
- 🎪 **Portable** - works anywhere

This is now a foolproof WiFi solution for your MARV robot monitoring system!
