Bud-wiser-er/ERD320-FinalReport/Phase3/Phase3/ESP32_Wifi_coms/WIFI_ACCESS_POINT_GUIDE.md

# MARV WiFi ESP32 - Access Point Mode Guide

## What Changed ✅

The WiFi ESP32 now creates its **own WiFi hotspot** instead of trying to connect to your existing WiFi network. This is much more reliable and easier to use!

## How It Works

### 1. **ESP32 Creates WiFi Hotspot**
- **Network Name**: `MARV-WiFi`
- **Password**: `marv1234`
- **IP Address**: `192.168.4.1` (default AP IP)

### 2. **Connect Your Phone/Computer**
1. Look for WiFi network called **"MARV-WiFi"**
2. Connect using password **"marv1234"**
3. Open browser and go to **http://192.168.4.1**
4. Enjoy real-time MARV robot monitoring!

## Expected Serial Output

```
╔══════════════════════════════════════════════════════╗
║        MARV WiFi Communication System               ║
║        ESP32 WiFi Communications Module             ║
╚══════════════════════════════════════════════════════╝

Setup starting...
WiFi SSID configured: MARV-WiFi
GPIO pins initialized for communication with main ESP32
  Touch Command   -> GPIO 4
  Tone Command    -> GPIO 2
  Send Command    -> GPIO 15

About to initialize SPI...
SPI receiver initialized
SPI initialization complete

Starting WiFi connection...
Setting up WiFi Access Point...
SSID: MARV-WiFi
Password: marv1234
✅ WiFi Access Point created successfully!
📱 Connect your phone to WiFi network: MARV-WiFi
🔐 Password: marv1234
🌐 Then open browser to: http://192.168.4.1

🎉 MARV WiFi System Ready!
════════════════════════════════════════════════════════
📱 WiFi Network: MARV-WiFi
🔐 Password: marv1234
🌐 Web Interface: http://192.168.4.1
════════════════════════════════════════════════════════

Web server started
```

## Configuration Options

You can easily switch between modes by changing this line in the code:

```cpp
#define USE_ACCESS_POINT true   // Creates hotspot (recommended)
#define USE_ACCESS_POINT false  // Connects to existing WiFi
```

### Access Point Mode (Recommended)
- ✅ **Always works** - no WiFi network dependencies
- ✅ **Portable** - works anywhere
- ✅ **Simple setup** - just connect and browse
- ✅ **Perfect for demos** and testing

### Station Mode (Alternative)
- Connects to your existing WiFi network
- Good if you want MARV on your home/office network
- Requires configuring your WiFi credentials

## Troubleshooting

### "Can't find MARV-WiFi network"
- Make sure ESP32 is powered on and code uploaded
- Check serial monitor for "Access Point created successfully"
- ESP32 might be in bootloader mode - press EN button

### "Can't connect to MARV-WiFi"
- Verify password is exactly: `marv1234`
- Try forgetting and reconnecting to the network
- Some devices are picky about 2.4GHz networks

### "Can't access http://192.168.4.1"
- Make sure you're connected to MARV-WiFi network
- Try http://192.168.4.1 (not https)
- Clear browser cache or try incognito mode

## Web Interface Features

Once connected, you'll see:
- **Real-time sensor data** (S1, S2, S3 colors)
- **NAVCON state information**
- **Wheel speeds and distance**
- **Live SPI packet monitoring**
- **Touch/Tone command buttons**
- **System performance metrics**

This creates a professional mobile interface for monitoring your MARV robot!
