Bud-wiser-er/ERD320-FinalReport/EPR320_Group_45_Final_Report/01_SNC/vmodel_print.pdf

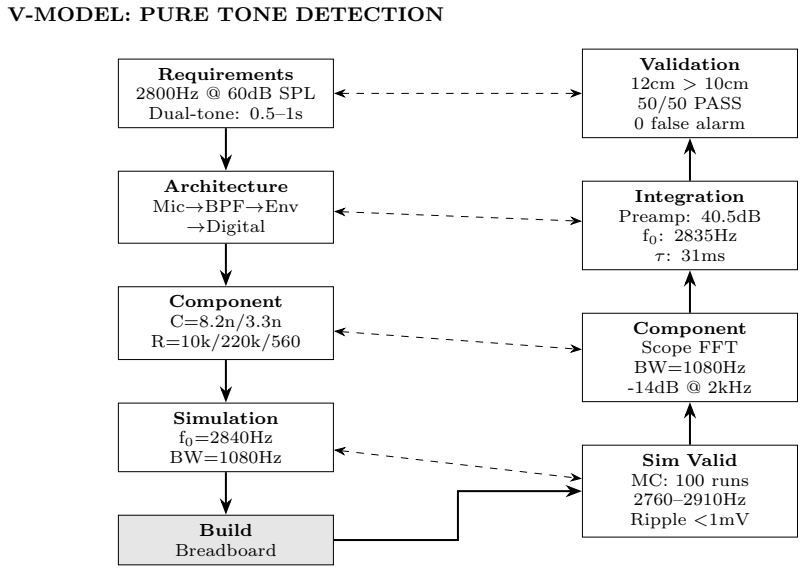
[picture p83: figure]
V-MODEL: PURE TONE DETECTION; Requirements 2800Hz @ 60dB SPL Dual-tone: 0.5–1s; Architecture Mic→BPF→Env →Digital; Component C=8.2n/3.3n R=10k/220k/560; Simulation f0=2840Hz BW=1080Hz; Build Breadboard; Validation 12cm > 10cm 50/50 PASS 0 false alarm; Integration Preamp: 40.5dB f0: 2835Hz τ: 31ms; Component Scope FFT BW=1080Hz -14dB @ 2kHz; Sim Valid MC: 100 runs 2760–2910Hz Ripple <1mV
