Bud-wiser-er/ERD320-FinalReport/Phase3/Pure Tone vera baord builder sinm/Veroboard_Stripboard-Layout-1.pdf

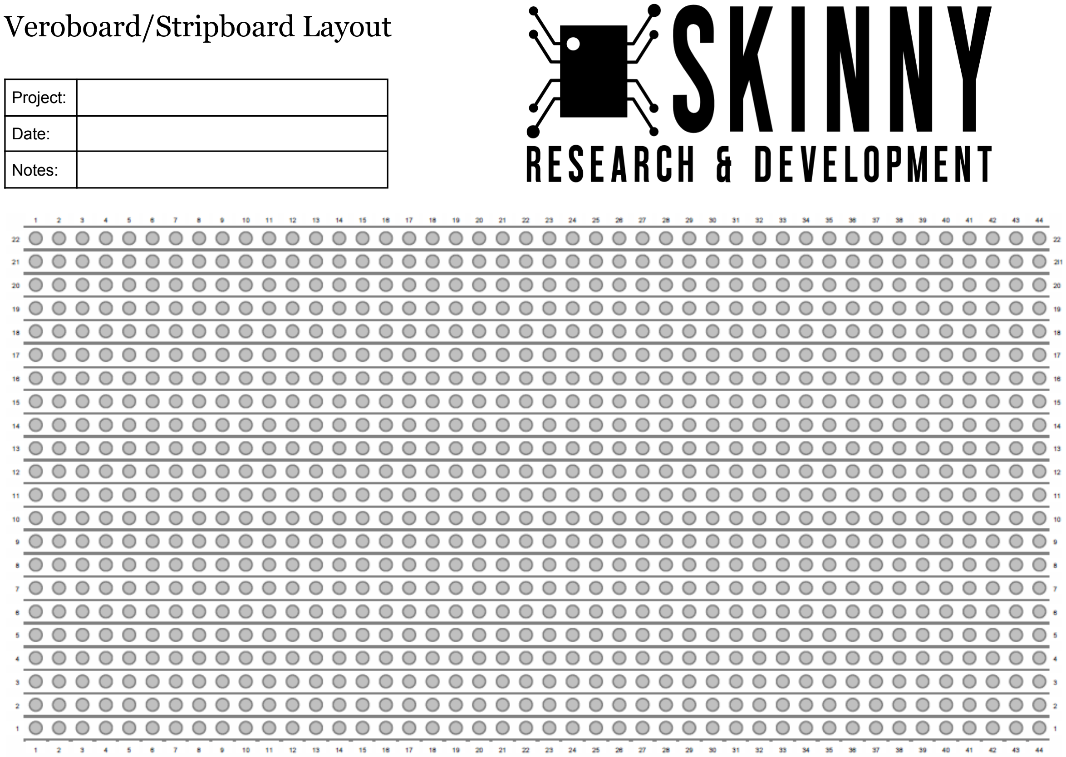
[picture p99: page 1]

Veroboard/Stripboard Layout

Project:

Date:

Notes:

Veroboard/Stripboard Layout

Project:

Date:

Notes:
