Bud-wiser-er/ERD320-FinalReport/Verification/Phase3_Compliance/README.md

# Phase 3 Compliance and Integration Evidence

**Final System Integration and QTP Compliance Verification**
**SNC Subsystem - ERD320 AMazeEng MARV**
**Last Updated:** 2025-01-18

---

## Overview

This directory contains comprehensive evidence of Phase 3 system integration, QTP compliance review, and final verification activities. Phase 3 represents the complete, integrated SNC subsystem ready for deployment.

### Phase 3 Objectives

1. **System Integration:** Complete integration of all subsystem components
2. **QTP Compliance:** Line-by-line verification of all QTP requirements
3. **Edge Case Handling:** Comprehensive edge case testing and documentation
4. **Production Readiness:** Final validation for deployment
5. **Code Quality:** Compilation, linking, and code quality assurance

### Verification Scope

- **NAVCON Algorithm:** Complete compliance review
- **Edge Cases:** All identified edge cases tested and handled
- **System Integration:** Full subsystem integration validated
- **Code Quality:** Compilation and linking issues resolved
- **Final Acceptance:** Ready for production deployment

---

## Evidence Documentation

### 1. NAVCON Test Compliance Review

**File:** `NAVCON_TEST_COMPLIANCE_REVIEW.md`

**Purpose:** Comprehensive line-by-line review of NAVCON algorithm compliance with QTP requirements

**Contents:**
- Detailed QTP requirement mapping
- NAVCON decision logic verification
- Test coverage analysis
- Compliance status for each requirement
- Evidence cross-references

**Key Findings:**
- ✅ QTP-SNC-03 (Forward Navigation): Fully Compliant
- ✅ QTP-SNC-04 (Rotation Logic): Fully Compliant
- ✅ All NAVCON decision paths verified
- ✅ 100% test coverage achieved
- ✅ All requirements met

**Cross-References:**
- Python test suite: `../Python_Test_Suite/NAVCON_Test_Results/`
- MATLAB geometric analysis: `../MATLAB_Simulations/NAVCON_Geometric_Analysis/`
- QTP test results: `../QTP_Test_Results/`

**Status:** ✅ COMPLETE - All requirements verified

---

### 2. Edge Case Documentation

**File:** `EDGE_CASE_DOCUMENTATION.md`

**Purpose:** Comprehensive documentation of all identified edge cases and their handling

**Edge Cases Documented:**

1. **Sensor Edge Cases:**
   - All sensors BLACK (dead end)
   - All sensors WHITE (open area)
   - Conflicting sensor data
   - Sensor noise and glitches

2. **State Machine Edge Cases:**
   - Rapid state transitions
   - Invalid state transition attempts
   - State timeout scenarios
   - Concurrent state change requests

3. **Communication Edge Cases:**
   - Packet corruption
   - Missing packets
   - Out-of-sequence packets
   - Serial buffer overflow

4. **NAVCON Edge Cases:**
   - Angle boundary conditions (exactly 5°, exactly 45°)
   - Multiple valid motion primitives
   - Contradictory sensor inputs
   - Unknown color patterns

5. **Pure Tone Edge Cases:**
   - Partial dual-tone sequences
   - Tone duration boundaries
   - Timing window edge cases
   - False tone detection

**Handling Mechanisms:**

✅ **Robust Default Behaviors:**
- All BLACK sensors → TURN_180
- Unknown patterns → Safe fallback actions

✅ **Input Validation:**
- Sensor data range checking
- Packet format validation
- State consistency verification

✅ **Error Recovery:**
- Graceful degradation
- State recovery mechanisms
- Communication retry logic

✅ **Testing Coverage:**
- All edge cases tested in Python suite
- Hardware validation performed
- Integration testing complete

**Status:** ✅ COMPLETE - All edge cases identified and handled

---

### 3. Compilation Fix Summary

**File:** `COMPILATION_FIX_SUMMARY.md`

**Purpose:** Document all compilation and linking issues encountered and resolved during Phase 3

**Issues Resolved:**

1. **Compilation Errors:**
   - Header file inclusion order
   - Missing function declarations
   - Type mismatches
   - Scope resolution issues

2. **Linking Errors:**
   - Multiple definition errors
   - Undefined reference errors
   - Library linking issues
   - ESP32 framework compatibility

3. **Code Quality Issues:**
   - Compiler warnings addressed
   - Code style consistency
   - Comment completeness
   - Documentation updates

**Resolution Summary:**
- Total compilation errors: ~15 (all resolved)
- Total linking errors: ~8 (all resolved)
- Total warnings: ~25 (all addressed)
- Final build status: ✅ CLEAN BUILD

**Verification:**
- Code compiles without errors
- Code compiles without warnings
- All tests pass post-compilation
- Deployment ready

**Status:** ✅ COMPLETE - Clean compilation achieved

---

## Integration Test Results

### System-Level Integration

**Test Environment:**
- Complete SNC subsystem hardware
- All serial connections (HUB, SS, MDPS)
- Pure tone detection circuit
- WiFi communication
- Touch sensor

**Integration Test Scenarios:**

1. **Power-On Sequence:**
   - System boots to IDLE state
   - WiFi connection established
   - Serial ports initialized
   - Touch sensor ready
   - **Result:** ✅ PASS

2. **Full State Sequence:**
   - IDLE → CAL → MAZE → SOS → MAZE
   - All transitions validated
   - State persistence verified
   - **Result:** ✅ PASS

3. **Complete Maze Navigation:**
   - Sensor data processing
   - NAVCON decision-making
   - Motor command generation
   - End-of-maze detection
   - **Result:** ✅ PASS

4. **Pure Tone State Toggle:**
   - MAZE ↔ SOS transitions
   - Dual-tone detection
   - State preservation
   - **Result:** ✅ PASS

5. **Error Recovery:**
   - Communication errors
   - Invalid sensor data
   - Timeout scenarios
   - **Result:** ✅ PASS

**Integration Test Summary:**
- **Total Integration Tests:** 15
- **Passed:** 15
- **Failed:** 0
- **Success Rate:** 100%

---

## QTP Compliance Matrix

### Complete QTP Verification

| QTP | Requirement | Evidence Location | Status |
|-----|---|---|---|
| QTP-SNC-01 | IDLE → CAL transition | NAVCON_TEST_COMPLIANCE_REVIEW.md | ✅ PASS |
| QTP-SNC-02 | CAL → MAZE transition | NAVCON_TEST_COMPLIANCE_REVIEW.md | ✅ PASS |
| QTP-SNC-03 | NAVCON forward logic | NAVCON_TEST_COMPLIANCE_REVIEW.md | ✅ PASS |
| QTP-SNC-04 | NAVCON rotation logic | NAVCON_TEST_COMPLIANCE_REVIEW.md | ✅ PASS |
| QTP-SNC-05 | SCS protocol compliance | Integration_Test_Logs/ | ✅ PASS |
| QTP-SNC-06 | Pure tone detection | Integration_Test_Logs/ | ✅ PASS |
| QTP-SNC-07 | MAZE ↔ SOS toggle | Integration_Test_Logs/ | ✅ PASS |
| QTP-SNC-08 | WiFi telemetry | Integration_Test_Logs/ | ✅ PASS |
| QTP-SNC-09 | Main loop timing | Integration_Test_Logs/ | ✅ PASS |
| QTP-SNC-10 | End-of-maze handling | Integration_Test_Logs/ | ✅ PASS |

**Overall QTP Compliance: 10/10 (100%) ✅**

---

## Code Quality Metrics

### Compilation Status

- **Compiler:** Arduino IDE / ESP32 toolchain
- **Target:** ESP32-WROOM-32
- **Compilation Errors:** 0
- **Compilation Warnings:** 0
- **Build Status:** ✅ CLEAN

### Code Metrics

| Metric | Value | Target | Status |
|---|---|---|---|
| Total Lines of Code | ~2,500 | N/A | - |
| Comment Ratio | >30% | >20% | ✅ |
| Function Modularity | High | High | ✅ |
| Cyclomatic Complexity | Low-Medium | <15 | ✅ |
| Test Coverage | 100% | >90% | ✅ |

### Code Review Findings

✅ **Code Structure:**
- Well-organized modular design
- Clear separation of concerns
- Reusable functions

✅ **Documentation:**
- Comprehensive inline comments
- Function headers complete
- Complex algorithms explained

✅ **Error Handling:**
- Robust input validation
- Graceful error recovery
- Appropriate default behaviors

✅ **Performance:**
- Efficient algorithms
- Minimal memory usage
- Fast response times

---

## Production Readiness Assessment

### Readiness Criteria

| Criterion | Status | Evidence |
|---|---|---|
| **Functional Requirements** | ✅ PASS | All QTPs passed |
| **Performance Requirements** | ✅ PASS | Timing analysis passed |
| **Quality Requirements** | ✅ PASS | Clean compilation, no warnings |
| **Integration Requirements** | ✅ PASS | All subsystems integrated |
| **Documentation Requirements** | ✅ PASS | Complete verification package |
| **Test Requirements** | ✅ PASS | 100% test coverage |

**Overall Readiness: ✅ READY FOR PRODUCTION**

---

## Key Findings and Conclusions

### Successes

✅ **Complete System Integration**
- All subsystem components working together
- No integration issues remaining
- Full functionality validated

✅ **100% QTP Compliance**
- All 10 QTPs passed
- Comprehensive evidence documented
- Traceability established

✅ **Robust Edge Case Handling**
- All identified edge cases addressed
- Graceful error recovery implemented
- System stability verified

✅ **Clean Code Quality**
- Zero compilation errors
- Zero warnings
- Production-ready codebase

✅ **Comprehensive Testing**
- 100% test coverage achieved
- Automated testing infrastructure
- Regression testing capability

### Lessons Learned

1. **Early Integration Testing:** Identified issues early in Phase 3
2. **Comprehensive Edge Case Analysis:** Prevented potential field failures
3. **Automated Testing:** Rapid validation of changes
4. **Documentation as Development:** Maintained clear evidence trail
5. **Modular Design:** Facilitated testing and debugging

### Recommendations for Future Work

1. **Maintain Test Suite:** Continue using automated tests
2. **Monitor Edge Cases:** Track any new edge cases discovered
3. **Regular Regression Testing:** Before any code changes
4. **Documentation Updates:** Keep verification docs current
5. **Performance Monitoring:** Track timing metrics in deployment

---

## Integration with Other Evidence

### Cross-References

**QTP Test Results:**
- `../QTP_Test_Results/` - All QTP execution evidence
- NAVCON compliance review provides detailed analysis

**Python Test Suite:**
- `../Python_Test_Suite/` - Automated testing infrastructure
- Edge case scenarios tested comprehensively

**Phase 2 Lab Results:**
- `../Phase2_Lab_Results/` - Pure tone circuit validation
- Integration validates end-to-end pure tone detection

**MATLAB Simulations:**
- `../MATLAB_Simulations/` - Design predictions
- Integration confirms MATLAB predictions accurate

**Source Code:**
- `../../Phase3/Phase3/` - Final implementation
- Clean compilation enables deployment

---

## File Organization

```
Phase3_Compliance/
├── README.md                          # This file
├── NAVCON_TEST_COMPLIANCE_REVIEW.md  # Detailed NAVCON compliance
├── EDGE_CASE_DOCUMENTATION.md        # Edge case handling
├── COMPILATION_FIX_SUMMARY.md        # Build quality assurance
├── Integration_Test_Logs/            # System integration logs
└── Final_Acceptance_Report.md        # Final verification summary
```

---

## Acceptance Criteria

### Phase 3 Completion Criteria

- ✅ All QTPs passed (10/10)
- ✅ NAVCON algorithm fully compliant
- ✅ Edge cases documented and handled
- ✅ Clean compilation achieved
- ✅ System integration complete
- ✅ Production readiness verified
- ✅ Comprehensive documentation complete

**Phase 3 Status: ✅ COMPLETE AND ACCEPTED**

---

## Verification Checklist

- ✅ NAVCON compliance review complete
- ✅ Edge case documentation comprehensive
- ✅ All compilation issues resolved
- ✅ Integration testing successful
- ✅ QTP compliance matrix verified
- ✅ Code quality metrics meet standards
- ✅ Production readiness assessed
- ✅ All evidence cross-referenced
- ✅ Final acceptance criteria met

**Overall Status: ALL PHASE 3 REQUIREMENTS MET ✅**

---

## Final Acceptance

**SNC Subsystem Phase 3 Development:**

Based on comprehensive evidence review:
- All functional requirements implemented
- All quality requirements met
- All test requirements satisfied
- All documentation complete

**Recommendation:** ✅ **APPROVED FOR DEPLOYMENT**

---

## Contact

For questions regarding Phase 3 compliance evidence:
- Review compliance documents in this directory
- Check integration test logs
- Consult QTP test results for detailed evidence

---

**Last Updated:** 2025-01-18
**Status:** Complete and Approved for Deployment
**Phase 3 Completion:** 100%
