Bud-wiser-er/ERD320-FinalReport/Phase3/Phase3/NAVCON_Test_Suite/ENHANCED_MAZE_TEST.md

# Enhanced NAVCON Maze Test - Complete Coverage

## Overview

The NAVCON tester now includes **critical edge cases**:
- ✅ Large angle corrections (>45°)
- ✅ Very large angles (>60°)
- ✅ End-of-maze alignment verification (<5° requirement)
- ✅ Gradual rectification before EOM acceptance

---

## Complete Test Timeline

| Loop | Distance | Color | Angle | Event | Expected SNC Behavior |
|---|---|---|---|---|---|
| 1-9  | 44-60cm  | 0 | 0° | WHITE surface | MAZE:SNC:3 (vR, vL) forward |
| **10** | **62cm** | **16** | **22°** | **🟢 GREEN #1 - moderate** | IST=2 (STOP), IST=1 (ROTATE 22°), IST=3 (RESUME) |
| 11-14 | 64-70cm | 16 | 22° | GREEN continues | Continue correction |
| **15** | **72cm** | **0** | **0°** | **⚪ GREEN cleared** | IST=3 (FORWARD) |
| 16-24 | 74-92cm | 0 | 0° | WHITE surface | MAZE:SNC:3 (vR, vL) |
| **25** | **94cm** | **24** | **30°** | **🔵 BLUE wall** | IST=2 (STOP), IST=1 (ROTATE 90°), IST=3 (RESUME) |
| 26-29 | 96-102cm | 24 | 30° | BLUE continues | Turn away |
| **30** | **104cm** | **0** | **0°** | **⚪ BLUE cleared** | IST=3 (FORWARD new direction) |
| 31-39 | 106-122cm | 0 | 0° | WHITE surface | MAZE:SNC:3 (vR, vL) |
| **40** | **124cm** | **16** | **35°** | **🟢 GREEN #2 - moderate-high** | IST=2 (STOP), IST=1 (ROTATE 35°), IST=3 (RESUME) |
| 41-44 | 126-132cm | 16 | 35° | GREEN continues | Continue correction |
| **45** | **134cm** | **0** | **0°** | **⚪ GREEN cleared** | IST=3 (FORWARD) |
| 46-49 | 136-142cm | 0 | 0° | WHITE surface | MAZE:SNC:3 (vR, vL) |
| **50** | **144cm** | **16** | **52°** | **🟢 GREEN #3 - LARGE (>45°) ⚠️** | IST=2 (STOP), IST=1 (ROTATE 52°) **special handling**, IST=3 (RESUME) |
| 51-54 | 146-152cm | 16 | 52° | GREEN continues | Large correction |
| **55** | **154cm** | **0** | **0°** | **⚪ GREEN cleared** | IST=3 (FORWARD) |
| 56-59 | 156-162cm | 0 | 0° | WHITE surface | MAZE:SNC:3 (vR, vL) |
| **60** | **164cm** | **32** | **28°** | **⚫ BLACK wall** | IST=2 (STOP), IST=1 (ROTATE 90°), IST=3 (RESUME) |
| 61-64 | 166-172cm | 32 | 28° | BLACK continues | Turn away |
| **65** | **174cm** | **0** | **0°** | **⚪ BLACK cleared** | IST=3 (FORWARD new direction) |
| 66-69 | 176-182cm | 0 | 0° | WHITE surface | MAZE:SNC:3 (vR, vL) |
| **70** | **184cm** | **16** | **8°** | **🟢 GREEN #4 - small angle** | IST=2 (STOP), IST=1 (ROTATE 8°), IST=3 (RESUME) |
| 71-74 | 186-192cm | 16 | 8° | GREEN continues | Small correction |
| **75** | **194cm** | **0** | **0°** | **⚪ GREEN cleared** | IST=3 (FORWARD) |
| 76-79 | 196-202cm | 0 | 0° | WHITE surface | MAZE:SNC:3 (vR, vL) |
| **80** | **204cm** | **16** | **68°** | **🟢 GREEN #5 - VERY LARGE (>60°) ⚠️⚠️** | IST=2 (STOP), IST=1 (ROTATE 68°) **critical test**, IST=3 (RESUME) |
| 81-84 | 206-212cm | 16 | 68° | GREEN continues | Very large correction |
| **85** | **214cm** | **0** | **0°** | **⚪ GREEN cleared** | IST=3 (FORWARD) |
| 86-89 | 216-222cm | 0 | 0° | WHITE surface | MAZE:SNC:3 (vR, vL) |
| **90** | **224cm** | **0** | **12°** | **⚠️ EOM approach - misaligned** | **SNC should start rectifying** |
| 91 | 226cm | 0 | 12° | Still misaligned | Rectification in progress |
| **92** | **228cm** | **0** | **7°** | **⚠️ EOM approach - rectifying** | **Continue alignment correction** |
| 93 | 230cm | 0 | 7° | Rectifying | Alignment improving |
| **94** | **232cm** | **0** | **3°** | **✅ EOM approach - good alignment** | **Nearly aligned (<5°)** |
| 95 | 234cm | 0 | 3° | Good alignment | Maintain course |
| **96** | **236cm** | **0** | **1°** | **✅ EOM approach - excellent** | **Excellent alignment** |
| 97 | 238cm | 0 | 1° | Excellent | Final approach |
| **98** | **240cm** | **73** | **1°** | **🔴 RED EOM - angle=1° (<5°) ✅** | **IST=2 (STOP) - EOM accepted!** |
| **99** | **242cm** | **73** | **0°** | **🔴 RED EOM - angle=0° (perfect)** | **Remain stopped - maze complete!** |

---

## Critical Test Scenarios

### 1. Large Angle Handling (>45°)

**Loop 50**: GREEN line at **52° angle**

**Challenge**: Angles >45° may require:
- Different rotation strategy (multiple corrections vs single large turn)
- Speed reduction during turn
- Verification after rotation

**Expected SNC Behavior**:
```
Receive: MAZE:SS:1 (color=16), MAZE:SS:2 (angle=52)
Send:    MAZE:SNC:2 (STOP/REVERSE)
Send:    MAZE:SNC:1 (ROTATE angle=52, direction)
         [May require multiple rotations or special handling]
Send:    MAZE:SNC:3 (FORWARD vR, vL)
```

**Why Important**: Tests edge case handling for severe misalignments

---

### 2. Very Large Angle Handling (>60°)

**Loop 80**: GREEN line at **68° angle**

**Challenge**: Extremely large angles may indicate:
- Robot severely off course
- Possible 180° turn scenario
- Critical correction needed

**Expected SNC Behavior**:
```
Receive: MAZE:SS:1 (color=16), MAZE:SS:2 (angle=68)
Send:    MAZE:SNC:2 (STOP/REVERSE)
Send:    MAZE:SNC:1 (ROTATE angle=68 or possibly 90°+)
         [Critical test - may trigger special recovery logic]
Send:    MAZE:SNC:3 (FORWARD vR, vL)
```

**Why Important**: Tests extreme misalignment recovery

---

### 3. End-of-Maze Alignment Verification (<5° requirement)

**Loops 90-99**: Gradual alignment before EOM acceptance

**Challenge**: Robot must verify proper alignment before accepting EOM
- Loop 90: angle=12° (too misaligned - **reject EOM if RED appears**)
- Loop 92: angle=7° (still too misaligned - **reject EOM**)
- Loop 94: angle=3° (acceptable alignment - **can accept EOM**)
- Loop 96: angle=1° (excellent alignment)
- Loop 98: angle=1° + RED detected → **EOM accepted**

**Expected SNC Behavior**:

```
// Loop 90-92 (angle > 5°)
If RED detected now:
  → Reject EOM (angle too large)
  → Continue rectification
  → Keep driving forward

// Loop 94-99 (angle < 5°)
When RED detected (loop 98):
  → Check angle < 5° ✅
  → Accept EOM
  → Send MAZE:SNC:2 (STOP)
  → Transition to IDLE or remain stopped
```

**Why Important**: Ensures robot doesn't accept EOM while misaligned (could fail challenge requirements)

---

## Angle Progression Summary

| Category | Angles Tested | Loops |
|---|---|---|
| Small (<15°) | 8° | 70 |
| Moderate (15-35°) | 22°, 35° | 10, 40 |
| Large (45-60°) | 52° | 50 |
| Very Large (>60°) | 68° | 80 |
| Walls (BLUE/BLACK) | 28°, 30° | 25, 60 |
| EOM Approach | 12° → 7° → 3° → 1° → 0° | 90-99 |

---

## Expected SNC Responses

### Normal Forward Motion (WHITE surface, angle=0°)
```
SNC → MAZE:SNC:3 (DAT1=vR, DAT0=vL, DEC=0)
```

### Small Angle GREEN (<15°)
```
SNC → MAZE:SNC:2 (STOP/REVERSE)
SNC → MAZE:SNC:1 (ROTATE small angle)
SNC → MAZE:SNC:3 (FORWARD - quick recovery)
```

### Moderate Angle GREEN (15-35°)
```
SNC → MAZE:SNC:2 (STOP/REVERSE)
SNC → MAZE:SNC:1 (ROTATE angle, direction)
SNC → MAZE:SNC:3 (FORWARD)
```

### Large Angle GREEN (45-60°) ⚠️
```
SNC → MAZE:SNC:2 (STOP/REVERSE)
SNC → MAZE:SNC:1 (ROTATE large angle - may require special handling)
[Possible additional corrections]
SNC → MAZE:SNC:3 (FORWARD - careful resumption)
```

### Very Large Angle GREEN (>60°) ⚠️⚠️
```
SNC → MAZE:SNC:2 (STOP/REVERSE)
SNC → MAZE:SNC:1 (ROTATE extreme angle - critical recovery)
[May trigger 90° or 180° turn logic]
SNC → MAZE:SNC:3 (FORWARD)
```

### BLUE/BLACK Wall
```
SNC → MAZE:SNC:2 (STOP/REVERSE)
SNC → MAZE:SNC:1 (ROTATE 90° away from wall)
SNC → MAZE:SNC:3 (FORWARD new direction)
```

### EOM Approach (angle > 5°)
```
// If RED appears but angle > 5°
SNC → Continue forward (reject EOM)
SNC → MAZE:SNC:3 (maintain course to rectify)
```

### EOM Acceptance (angle < 5°)
```
// When RED appears AND angle < 5°
SNC → MAZE:SNC:2 (STOP)
SNC → May transition to IDLE:SNC:0
// Maze complete!
```

---

## What This Tests

### ✅ Protocol Compliance
- Correct SCS packet structure
- State transitions (IDLE→CAL→MAZE→IDLE)
- Control byte encoding
- Real-time packet stream

### ✅ NAVCON Decision Logic
- Small angle corrections
- Moderate angle corrections
- **Large angle corrections (>45°)**
- **Very large angle corrections (>60°)**
- Wall avoidance (90° turns)
- Line crossing strategies

### ✅ Edge Case Handling
- **Extreme misalignment recovery**
- **EOM alignment verification (<5° requirement)**
- **Gradual rectification before EOM**
- Multiple sequential corrections
- Angle range coverage (0° to 68°)

### ✅ Real-World Scenarios
- Progressive difficulty (small → large angles)
- Mixed obstacles (walls + lines)
- **Alignment verification sequence**
- Final approach precision

---

## Success Criteria Checklist

- [ ] IDLE→CAL→MAZE transitions completed
- [ ] GREEN 22° (loop 10): STOP→ROTATE→FORWARD
- [ ] BLUE wall (loop 25): STOP→90° TURN→FORWARD
- [ ] GREEN 35° (loop 40): STOP→ROTATE→FORWARD
- [ ] **GREEN 52° (loop 50): STOP→LARGE ROTATE→FORWARD** ⚠️
- [ ] BLACK wall (loop 60): STOP→90° TURN→FORWARD
- [ ] GREEN 8° (loop 70): STOP→SMALL ROTATE→FORWARD
- [ ] **GREEN 68° (loop 80): STOP→VERY LARGE ROTATE→FORWARD** ⚠️⚠️
- [ ] **Loops 90-96: Gradual rectification (12°→7°→3°→1°)**
- [ ] **Loop 98: RED EOM with angle=1° (<5°) → STOP** ✅
- [ ] SNC remains stopped at loop 99

---

## Troubleshooting

### Issue: SNC Accepts EOM at Loop 90 (angle=12°)
**Problem**: SNC not checking alignment before EOM acceptance
**Fix**: Add angle verification: `if (color == RED && angle < 5) accept_eom();`

### Issue: SNC Fails on 52° or 68° Angles
**Problem**: Large angle handling not implemented
**Fix**: Add conditional logic for angles >45° (may require 90° turn instead)

### Issue: SNC Continuously Rotates at Large Angles
**Problem**: Rotation never completes for large angles
**Fix**: Add rotation timeout or maximum rotation limit

### Issue: SNC Never Rectifies Before EOM
**Problem**: Not processing angle data when color=0
**Fix**: Ensure NAVCON processes SS:2 angle data even on WHITE surface

---

## Running The Enhanced Test

1. Upload SNC firmware with complete NAVCON logic
2. Connect to COM port (19200 baud)
3. Start NAVCON tester
4. Select test scenario
5. Click "Start Test"
6. **Watch for critical tests**:
   - Loop 50 (52° angle)
   - Loop 80 (68° angle)
   - Loops 90-96 (rectification)
   - Loop 98 (EOM acceptance at 1°)

---

## Expected Log Output

```
...
🟢 GREEN line #3 detected (52° angle - LARGE >45°) - requires special handling!
  ← SNC: MAZE:SNC:2 (STOP)
  ← SNC: MAZE:SNC:1 (ROTATE 52)
  ← SNC: MAZE:SNC:3 (RESUME)
...
🟢 GREEN line #5 detected (68° angle - VERY LARGE) - critical test!
  ← SNC: MAZE:SNC:2 (STOP)
  ← SNC: MAZE:SNC:1 (ROTATE 68)
  ← SNC: MAZE:SNC:3 (RESUME)
...
⚠️ Approaching EOM - angle=12° (robot should rectify to <5°)
  ← SNC: MAZE:SNC:3 (continue forward)
⚠️ EOM approach - angle=7° (still rectifying...)
  ← SNC: MAZE:SNC:3 (continue forward)
✅ EOM approach - angle=3° (good alignment!)
  ← SNC: MAZE:SNC:3 (continue forward)
✅ EOM approach - angle=1° (excellent alignment)
  ← SNC: MAZE:SNC:3 (continue forward)
🔴 RED END-OF-MAZE detected! Angle=1° (<5° requirement met) - SNC should accept EOM!
  ← SNC: MAZE:SNC:2 (STOP)
🔴 RED EOM confirmed - angle=0° (perfect) - maze complete!
  ← SNC: [Stopped - no further commands]
✅ MAZE continuous loop completed!
```

---

**Your NAVCON tester now includes CRITICAL edge cases! 🎉**

This enhanced test ensures your SNC can handle:
- ✅ All angle ranges (0° to 68°)
- ✅ Large angle corrections (>45°)
- ✅ Very large angle corrections (>60°)
- ✅ End-of-maze alignment verification (<5° requirement)
- ✅ Gradual rectification sequences

**Perfect for ensuring competition readiness!** 🏁
