Bud-wiser-er/ERD320-FinalReport/Phase3/Phase3/Phase3_Before_Distance_Update/Phase3/READMEs/compile_test.md

# Compilation Fixes Applied

## Issues Fixed:

1. **Color constants in switch statements**:
   - Changed from `extern const uint8_t` to `#define` macros in edge_case_matrix.h
   - Updated getColorName() function to use numeric literals (0-4)

2. **Missing function declaration**:
   - Added `updateLineDetectionWithEdgeCases()` declaration to navcon_core.h

3. **Enum conflicts between SPI and SCS protocols**:
   - Modified spi_protocol.h to include existing headers instead of redefining enums
   - Added typedef for Subsystem compatibility
   - Removed duplicate LineType enum

4. **Type mismatch in SPI calls**:
   - Added cast `(Subsystem)SUB_SNC` in Phase3.ino

5. **Circular include dependencies**:
   - Used forward declarations in edge_case_matrix.h
   - Added external variable and function declarations in edge_case_matrix.cpp

## Files Modified:

- `edge_case_matrix.h` - Forward declarations, color macros
- `edge_case_matrix.cpp` - Color literals, external declarations
- `navcon_core.h` - Added function declaration
- `navcon_core.cpp` - Updated function call
- `spi_protocol.h` - Removed duplicate enums
- `Phase3.ino` - Type cast fix

## Expected Result:

The project should now compile without the reported errors. The edge case handling system is integrated while maintaining backward compatibility with the existing NAVCON system.
