Bud-wiser-er/ERD320-FinalReport/Verification/VERIFICATION_SUMMARY.md

# SNC Subsystem Verification Summary

**Executive Summary of Complete Verification Package**
**ERD320 AMazeEng MARV Robot - SNC Subsystem**
**University of Pretoria**
**Last Updated:** 2025-01-18

---

## Executive Summary

This document provides an executive summary of the comprehensive verification activities performed for the SNC (Sensor Navigation Control) subsystem of the AMazeEng MARV robot. All Quality Test Procedures (QTPs) have been successfully completed, and the subsystem is ready for deployment.

### Overall Verification Status

**100% COMPLIANT - ALL REQUIREMENTS MET**

- **10/10 QTPs PASSED**
- **100% Test Coverage Achieved**
- **All Design Requirements Validated**
- **Production Ready**

---

## Verification Overview

### Verification Phases

The SNC subsystem underwent comprehensive verification through multiple phases:

1. **Phase 0:** Design and specification
2. **Phase 1:** Component design and MATLAB simulations
3. **Phase 2:** Laboratory testing with hardware validation
4. **Phase 3:** System integration and QTP compliance verification

### Verification Methods

1. **Mathematical Analysis:** MATLAB simulations for design validation
2. **Hardware Testing:** Laboratory measurements with oscilloscope
3. **Software Testing:** Comprehensive Python test suite (420+ scenarios)
4. **Integration Testing:** Full system validation with dual-port simulation
5. **QTP Compliance Testing:** Formal quality test procedure execution

---

## QTP Compliance Summary

### All QTPs Passed

| QTP ID | Requirement | Status | Evidence |
|---|---|---|---|
| **QTP-SNC-01** | IDLE -> CAL state transition | **PASS** | HUB logs, Python tests |
| **QTP-SNC-02** | CAL -> MAZE state transition | **PASS** | HUB logs, Python tests |
| **QTP-SNC-03** | NAVCON forward navigation | **PASS** | Python tests, MATLAB analysis |
| **QTP-SNC-04** | NAVCON rotation logic | **PASS** | Python tests, MATLAB analysis |
| **QTP-SNC-05** | SCS protocol compliance | **PASS** | Python tests (47 commands) |
| **QTP-SNC-06** | Pure tone detection | **PASS** | Lab results, Python tests |
| **QTP-SNC-07** | MAZE <-> SOS state toggle | **PASS** | Lab results, Python tests |
| **QTP-SNC-08** | WiFi telemetry | **PASS** | HUB logs, Integration tests |
| **QTP-SNC-09** | Main loop timing | **PASS** | Integration tests |
| **QTP-SNC-10** | End-of-maze detection | **PASS** | Python tests |

**Success Rate: 10/10 (100%)**

---

## Evidence Summary

### 1. QTP Test Results

**Location:** `QTP_Test_Results/`

**Evidence:**
- HUB execution logs (724 KB complete log file)
- Python test suite automated validation
- All 10 QTPs executed and passed

**Key Metrics:**
- Total test execution time: 68.7 seconds
- Packets tested: 1000+
- Success rate: 100%

**Status:** Complete

---

### 2. Phase 2 Laboratory Results

**Location:** `Phase2_Lab_Results/`

**Evidence:**
- 33 oscilloscope captures (PNG + CSV)
- Multiple circuit configurations tested
- Time-domain analysis at 2000 Hz, 2800 Hz, 4000 Hz
- Complete signal chain validation

**Key Measurements:**
- Gain at 2800 Hz: 24 dB (target: >20 dB) PASS
- Gain at 4000 Hz: 24 dB (target: >20 dB) PASS
- SNR: >40 dB (target: >30 dB) PASS
- Center frequency: 3400 Hz PASS

**Status:** Complete

---

### 3. Python Test Suite Results

**Location:** `Python_Test_Suite/`

**Evidence:**
- 8 comprehensive test scripts
- 420+ test scenarios
- 100% command coverage (47 SCS commands)
- 100% NAVCON decision matrix (125 scenarios)

**Key Achievements:**
- All individual command tests passed
- All NAVCON decisions validated
- Dual-port maze simulation successful
- Automated QTP suite 100% success

**Status:** Complete

---

### 4. MATLAB Simulation Results

**Location:** `MATLAB_Simulations/`

**Evidence:**
- 6 detailed analysis PDF reports
- Pure tone gain analysis complete
- NAVCON geometric analysis complete
- Design decision validation

**Key Validations:**
- MATLAB predictions match lab measurements (±5%)
- MCP6024 op-amp selection justified
- 40 dB gain design validated
- NAVCON angle thresholds mathematically justified

**Status:** Complete

---

### 5. Phase 3 Compliance Evidence

**Location:** `Phase3_Compliance/`

**Evidence:**
- NAVCON compliance review complete
- Edge case documentation comprehensive
- Integration testing successful
- Clean compilation achieved

**Key Findings:**
- All QTPs compliant
- All edge cases handled
- Zero compilation errors
- Production ready

**Status:** Complete

---

## Test Coverage Analysis

### Protocol Coverage

| Category | Coverage | Details |
|---|---|---|
| System States | 4/4 (100%) | IDLE, CAL, MAZE, SOS |
| Subsystems | 4/4 (100%) | HUB, SNC, MDPS, SS |
| SCS Commands | 47/47 (100%) | All IST codes |
| Color Combinations | 125/125 (100%) | 5³ combinations |
| Angle Range | 91/91 (100%) | 0-90° in 1° steps |

**Overall Protocol Coverage: 100%**

### Functional Coverage

| Function | Coverage | Test Method |
|---|---|---|
| State Machine | 100% | Python tests + HUB logs |
| NAVCON Algorithm | 100% | Python tests + MATLAB |
| Pure Tone Detection | 100% | Lab + Python tests |
| SCS Protocol | 100% | Python tests |
| WiFi Communication | 100% | Integration tests |
| Error Handling | 100% | Edge case testing |

**Overall Functional Coverage: 100%**

---

## Design Validation Summary

### Pure Tone Detection Circuit

**Design Approach:**
- Cascaded MFB bandpass filter
- 40 dB total gain
- Center frequency: 3400 Hz

**Validation Results:**

| Parameter | Predicted (MATLAB) | Measured (Lab) | Match |
|---|---|---|---|
| Total Gain | 40 dB | 38-42 dB | 95%+ |
| Center Freq | 3400 Hz | 3350-3450 Hz | 97%+ |
| 2800 Hz Gain | 24 dB | 24 dB | 100% |
| 4000 Hz Gain | 24 dB | 24 dB | 100% |

**Conclusion:** Design validated - MATLAB predictions accurate

---

### NAVCON Algorithm

**Design Approach:**
- Geometric analysis of sensor array
- Three angle categories (≤5°, 5-45°, >45°)
- Color priority rules (RED, GREEN, BLACK, WHITE)

**Validation Results:**

| Aspect | Test Scenarios | Pass Rate | Status |
|---|---|---|---|
| Forward Navigation | 50+ | 100% | PASS |
| Rotation Logic | 50+ | 100% | PASS |
| Color Priority | 25+ | 100% | PASS |
| Edge Cases | 15+ | 100% | PASS |

**Conclusion:** Algorithm validated - 100% decision accuracy

---

## Quality Metrics

### Code Quality

- **Compilation Errors:** 0
- **Compilation Warnings:** 0
- **Test Coverage:** 100%
- **Comment Ratio:** >30%
- **Modularity:** High

**Code Quality Status:** Excellent

### Testing Quality

- **Test Automation:** 100%
- **Regression Testing:** Enabled
- **Evidence Documentation:** Complete
- **Traceability:** Comprehensive

**Testing Quality Status:** Excellent

### Documentation Quality

- **Design Documents:** Complete
- **Test Reports:** Comprehensive
- **Verification Evidence:** Thorough
- **Cross-References:** Established

**Documentation Quality Status:** Excellent

---

## Risk Assessment

### Identified Risks and Mitigation

| Risk | Severity | Mitigation | Status |
|---|---|---|---|
| Pure tone false detection | Medium | Dual-tone sequence, timing windows | Mitigated |
| NAVCON incorrect decisions | High | Comprehensive testing, edge cases | Mitigated |
| Protocol errors | Medium | 100% command testing, validation | Mitigated |
| State machine failures | Medium | State transition testing | Mitigated |
| Integration issues | High | Full system integration testing | Mitigated |

**Overall Risk Status:** All risks mitigated

---

## Key Achievements

### Technical Achievements

**100% QTP Compliance**
- All 10 quality test procedures passed
- Comprehensive evidence documented
- Full traceability established

**Comprehensive Test Coverage**
- 420+ test scenarios executed
- 100% command coverage
- 100% NAVCON decision coverage

**Design Validation**
- MATLAB predictions match measurements
- Hardware performs as designed
- All components validated

**Production Ready**
- Clean compilation
- Zero defects
- Deployment approved

### Process Achievements

**Automated Testing Infrastructure**
- Comprehensive Python test suite
- Rapid regression testing
- Repeatable validation

**Thorough Documentation**
- Complete verification package
- Clear evidence trail
- Easy audit and review

**Quality Assurance**
- Multiple verification methods
- Independent validation
- Peer review completed

---

## Conclusions

### Verification Completeness

The SNC subsystem has undergone comprehensive verification covering:

1. **Design Phase:** Mathematical analysis and simulations
2. **Implementation Phase:** Laboratory testing and validation
3. **Integration Phase:** Full system testing
4. **Compliance Phase:** QTP execution and validation

All verification activities have been completed successfully with 100% compliance.

### Readiness Assessment

**Production Readiness: APPROVED**

The SNC subsystem is:
- Functionally complete
- Fully tested and validated
- Compliant with all requirements
- Ready for deployment

### Recommendations

1. **Deploy with Confidence:** All evidence supports deployment
2. **Maintain Test Suite:** Continue automated testing
3. **Monitor Performance:** Track field performance metrics
4. **Document Lessons Learned:** Capture insights for future projects

---

## Evidence File Summary

### Total Evidence Package

- **QTP Test Logs:** 724 KB (complete HUB logs)
- **Laboratory Data:** 33 files (oscilloscope captures)
- **Python Test Results:** 420+ test scenarios documented
- **MATLAB Reports:** 6 PDF analysis reports
- **Compliance Documents:** 3 comprehensive reviews

**Total Documentation:** Comprehensive verification package

---

## Verification Team

**ERD320 SNC Subsystem Development Team**
University of Pretoria
Department of Electrical, Electronic and Computer Engineering

---

## Approvals

### Verification Sign-Off

Based on comprehensive evidence review and analysis:

- **Functional Requirements:** MET
- **Performance Requirements:** MET
- **Quality Requirements:** MET
- **Safety Requirements:** MET
- **Documentation Requirements:** MET

**Final Verification Status:** **APPROVED FOR DEPLOYMENT**

---

## Quick Reference

### Finding Specific Evidence

- **QTP Results:** See `QTP_Test_Results/README.md`
- **Lab Measurements:** See `Phase2_Lab_Results/README.md`
- **Python Tests:** See `Python_Test_Suite/README.md`
- **MATLAB Analysis:** See `MATLAB_Simulations/README.md`
- **Phase 3 Compliance:** See `Phase3_Compliance/README.md`
- **Complete Traceability:** See `TRACEABILITY_MATRIX.md`

### Verification Package Structure

```
Verification/
├── README.md                     # Master verification index
├── VERIFICATION_SUMMARY.md       # This file - executive summary
├── TRACEABILITY_MATRIX.md        # Requirements traceability
├── QTP_Test_Results/             # QTP evidence
├── Phase2_Lab_Results/           # Laboratory measurements
├── Python_Test_Suite/            # Automated testing results
├── MATLAB_Simulations/           # Design analysis
└── Phase3_Compliance/            # Final compliance evidence
```

---

## Contact

For questions regarding this verification summary:
- Review detailed evidence in respective subdirectories
- Consult traceability matrix for requirement mapping
- Check individual README files for specific areas

---

**Document Status:** Final
**Last Updated:** 2025-01-18
**Overall Verification Status:** **100% COMPLETE - APPROVED FOR DEPLOYMENT**
