Bud-wiser-er/ERD320-FinalReport/EPR320_Group_45_Final_Report/02_SS/qualification_tests.tex

\subsection{Subsystem Qualification Tests Results}
\textit{-	Include ONLY the following details of the qualification tests in table format:\\
\hspace*{2em}o	Specification to be verified (as per the MARV practical guide)\\
\hspace*{2em}o	Expected Results, based on your design efforts and simulations. Be specific!\\
\hspace*{2em}o	Provide the measured results of your tests\\}

% Add your qualification test results here
