Bud-wiser-er/ERD320-FinalReport/Verification/Phase3_Compliance/NAVCON_TEST_COMPLIANCE_REVIEW.md

# NAVCON Test Suite Compliance Review

## Executive Summary

**Status:** ⚠️ **INCOMPLETE - Missing QTP1, QTP4, QTP5**

The current NAVCON_Test_Suite only implements QTP2 (Basic NAVCON) and has a placeholder for QTP3 (Advanced NAVCON). According to the HUB documentation (`All_QTP_From_HUB.txt`), there are **5 distinct QTP tests** (QTP1-5) that must be implemented to fully simulate a maze run.

---

## QTP Test Requirements from HUB

Based on analysis of `All_QTP_From_HUB.txt` and `demo_log.txt`, here are the QTP tests:

### ✅ QTP1: NAVCON (Line 1)
**Status:** ❌ **NOT IMPLEMENTED**

**Purpose:** Basic system initialization and first line detection

**Expected Flow:**
1. IDLE: Initial HUB contact `(0-0-0)`
2. IDLE: SNC ready `(0-1-0)` with DAT1=1, DAT0=50
3. CAL: SS calibration sequence `(1-3-0)` → `(1-3-1)`
4. CAL: MDPS calibration `(1-2-0)` → `(1-2-1)` with rotation 90°
5. CAL: Repeated calibration cycles (lines 9-110 show ~60 seconds)
6. CAL: SNC signals ready with DAT1=1 `(1-1-0)`
7. MAZE: Transition to MAZE state `(2-1-1)` → `(2-1-2)` → `(2-1-3)`
8. MAZE: First line detection with GREEN `(2-3-1)` DAT0=128 (binary: 10000000)
9. MAZE: Incidence angle reported `(2-3-2)` DAT1=40 (40°)

**Key Line from Log:**
```
Error (QS 31): Incorrect TX found in MAZE -> SNC (Error: REVERSE required at GGWWW / WWWGG - N1.2 Fail)
```
This indicates QTP1 tests the first GREEN line encounter and expects proper REVERSE behavior before rotation.

**Critical Test Point:** N1.2 compliance - REVERSE before rotation on angled GREEN lines (GGWWW or WWWGG sensor patterns)

---

### ✅ QTP2: NAVCON (Line 16)
**Status:** ⚠️ **PARTIALLY IMPLEMENTED**

**Purpose:** Multiple GREEN line rotations

**Expected Flow:**
```
Line 16: Rotation test (QS  8). Ctrl (2-2-1): Rotation 1/2 with GREEN on the RIGHT
Line 71: Rotation test (QS  8). Ctrl (2-2-1): Rotation 2/2 with GREEN on the RIGHT
```

Shows two complete GREEN line encounters with rotation sequences.

**Current Implementation:** Basic test exists but may not fully cover the 2-rotation sequence

**Key Sequence:**
1. GREEN line detected
2. MDPS rotation command `(2-2-1)` with 90° rotation
3. MDPS stop `(2-2-2)`
4. MDPS movement `(2-2-3)` with speeds
5. MDPS distance reporting `(2-2-4)` with accumulated distance
6. SS color updates `(2-3-1)`
7. SS angle updates `(2-3-2)`

**Test Validation:** Must complete 2 full rotation sequences successfully

---

### ❌ QTP3: NAVCON
**Status:** ❌ **NOT IMPLEMENTED** (placeholder only)

**Purpose:** Unknown from available logs (no "Start QTP3" found in documentation)

**Likely Requirements:**
- BLACK/BLUE wall line handling
- 180° turn sequences
- Wall avoidance behavior
- More complex routing decisions

**Recommendation:** Review official AMazeEng QTP documentation to determine exact requirements

---

### ❌ QTP4: NAVCON
**Status:** ❌ **NOT IMPLEMENTED**

**Purpose:** Unknown - no reference found in provided logs

**Speculation:** May test:
- Multiple wall encounters
- Complex maze sections
- Error recovery
- SOS state transitions

---

### ❌ QTP5: NAVCON
**Status:** ❌ **NOT IMPLEMENTED**

**Purpose:** Unknown - no reference found in provided logs

**Speculation:** May test:
- End-of-maze detection
- Complete maze run
- All line types in sequence
- Final state transitions back to IDLE

---

## Current Test Suite Analysis

### File: `NAVCON_Test_Suite/navcon_tester.py`

**Lines 471-516: Test Scenario Creation**

```python
def create_test_scenarios(self):
    """Create predefined test scenarios"""
    self.scenarios = {}

    # QTP2: Basic NAVCON Test
    qtp2 = NAVCONTestScenario("QTP2: Basic NAVCON",
                            "Tests basic NAVCON functionality...")
    # ... steps defined ...
    self.scenarios["QTP2"] = qtp2

    # QTP3: Advanced NAVCON Test
    qtp3 = NAVCONTestScenario("QTP3: Advanced NAVCON",
                            "Advanced navigation test...")
    # Add more complex scenarios...  # ← NO ACTUAL STEPS!
    self.scenarios["QTP3"] = qtp3

    # Full Maze Test
    full_maze = NAVCONTestScenario("Full Maze Navigation",
                                 "Complete maze navigation test...")
    self.scenarios["Full Maze"] = full_maze  # ← NO STEPS!
```

### Problems Identified:

1. **QTP1 Missing Entirely**
   - No test for initial calibration and first line
   - N1.2 compliance (REVERSE requirement) not validated

2. **QTP2 Incomplete**
   - Only has basic packet sequence
   - Missing validation of 2-rotation completion
   - No verification of "Rotation 1/2" and "Rotation 2/2" markers

3. **QTP3 Empty**
   - Declared but has no test steps
   - Comment says "Add more complex scenarios..." but nothing implemented

4. **QTP4 and QTP5 Missing**
   - Not even declared
   - Unknown requirements

5. **Full Maze Test Empty**
   - Declared but no steps
   - Should simulate complete QTP1-5 sequence

---

## HUB Log Analysis

### Successful QTP2 Run (demo_log.txt lines 1-100)

**Calibration Phase (60 seconds):**
- Lines 2-110: Repeated CAL packets every ~0.5 seconds
- HUB sends: `(1-2-1)` MDPS rotation 90° and `(1-3-1)` SS ready
- SNC responds: `(1-1-0)` calibration complete
- **Duration:** ~60 seconds before MAZE transition

**MAZE Phase:**
- Line 111: SNC enters MAZE `(2-1-1)` → `(2-1-2)` → `(2-1-3)`
- Line 114-119: HUB sends MDPS rotation and SS GREEN line
- Pattern repeats for Rotation 1/2 (line 16) and Rotation 2/2 (line 71)

**Key Observations:**
1. Calibration requires sustained packet exchange (not just one-shot)
2. MAZE IST sequence: 1 → 2 → 3 (activates NAVCON)
3. GREEN line uses DAT0 encoding:
   - Line 20: `DAT0=2` = GREEN (binary 00000010)
   - Line 38: `DAT0=2` = GREEN
   - Line 56: `DAT0=2` = GREEN
4. Distance accumulates: 100mm → 160mm → 60mm cycles

---

## Compliance with HUB Requirements

### ✅ What the Test Suite Does Correctly:

1. **SCS Protocol Implementation**
   - Correct control byte format: `(SYS<1:0> | SUB<1:0> | IST<3:0>)`
   - Proper packet structure: CONTROL | DAT1 | DAT0 | DEC
   - State machine states: IDLE, CAL, MAZE, SOS

2. **Subsystem Emulation**
   - SS emulation (sensor colors, angles)
   - MDPS emulation (rotations, speeds, distances)
   - Serial communication at 19200 baud

3. **Real-time Monitoring**
   - Packet logging with timestamps
   - GUI with packet display
   - Protocol analysis

### ❌ What's Missing for Full Compliance:

1. **QTP1 Test**
   - Must implement 60-second calibration cycle
   - Must test first GREEN line detection
   - Must validate N1.2 REVERSE requirement
   - Must fail test if REVERSE not sent for GGWWW/WWWGG patterns

2. **QTP2 Enhancement**
   - Add validation for 2-rotation completion markers
   - Track "Rotation X/Y" progress
   - Verify distance accumulation patterns
   - Check color encoding (DAT0 values)

3. **QTP3-5 Implementation**
   - Need official QTP specifications
   - BLACK/BLUE wall tests (QTP3 likely)
   - 180° turn tests
   - End-of-maze validation (QTP5 likely)

4. **Full Maze Simulation**
   - Sequential execution of QTP1 → QTP2 → QTP3 → QTP4 → QTP5
   - Complete state transitions: IDLE → CAL → MAZE → IDLE
   - End-of-maze packet `(2-3-3)` SS IST=3
   - Final IDLE return

---

## Recommended Test Suite Improvements

### Priority 1: Implement QTP1

```python
def create_qtp1_test():
    """QTP1: First line detection and N1.2 compliance"""
    qtp1 = NAVCONTestScenario("QTP1: NAVCON (First Line)",
                             "Tests initial calibration and first GREEN line with REVERSE validation")

    # IDLE phase
    qtp1.add_step(SCSPacket(0, 0, 0, 0), "HUB: Initial contact")

    # CAL phase (60-second cycle)
    for i in range(120):  # 120 cycles at 0.5s = 60 seconds
        qtp1.add_step(SCSPacket(97, 90, 0, 0), "MDPS: Rotation calibration")
        qtp1.add_step(SCSPacket(113, 0, 0, 0), "SS: Sensor calibration")
        time.sleep(0.5)

    # MAZE transition
    # Wait for SNC to send (2-1-1) → (2-1-2) → (2-1-3)

    # First GREEN line (GGWWW pattern - 2 sensors on left)
    qtp1.add_step(SCSPacket(161, 90, 0, 0), "MDPS: Stop command")
    qtp1.add_step(SCSPacket(162, 0, 0, 0), "MDPS: Stopped")
    qtp1.add_step(SCSPacket(177, 0, 2, 0), "SS: GREEN detected (S1+S2)")
    qtp1.add_step(SCSPacket(178, 40, 0, 0), "SS: Angle 40°")

    # VALIDATE: SNC must send (2-1-2) REVERSE before rotation
    # If SNC sends (2-1-1) rotation without REVERSE → FAIL N1.2

    return qtp1
```

**Critical Validation:**
- Monitor for SNC IST=2 (REVERSE) packet before accepting IST=1 (rotation request)
- If rotation requested without prior REVERSE for angled lines → **TEST FAILS**
- Error message: "N1.2 Fail - REVERSE required at GGWWW / WWWGG"

### Priority 2: Complete QTP2

Add validation logic:
```python
# Track rotation progress
rotation_count = 0
expected_rotations = 2

# After each rotation sequence completion
rotation_count += 1
print(f"Rotation test (QS X). Ctrl (2-2-1): Rotation {rotation_count}/{expected_rotations}")

# Test passes only if rotation_count == expected_rotations
if rotation_count != expected_rotations:
    return FAIL("Expected 2 rotations, got {rotation_count}")
```

### Priority 3: Research and Implement QTP3-5

**Action Items:**
1. Obtain official AMazeEng QTP specifications
2. Analyze what each QTP tests:
   - QTP3: Likely BLACK/BLUE walls
   - QTP4: Likely complex multi-line sequences
   - QTP5: Likely end-of-maze and final state
3. Implement based on specifications

### Priority 4: Full Maze Test

```python
def create_full_maze_test():
    """Complete maze simulation - all QTPs in sequence"""
    full_maze = NAVCONTestScenario("Full Maze Navigation",
                                  "Simulates complete maze run: QTP1→QTP2→QTP3→QTP4→QTP5")

    # Execute QTP1 steps
    full_maze.steps.extend(qtp1.steps)

    # Execute QTP2 steps
    full_maze.steps.extend(qtp2.steps)

    # Execute QTP3 steps
    full_maze.steps.extend(qtp3.steps)

    # Execute QTP4 steps
    full_maze.steps.extend(qtp4.steps)

    # Execute QTP5 steps
    full_maze.steps.extend(qtp5.steps)

    # End-of-maze
    full_maze.add_step(SCSPacket(179, 0, 0, 0), "SS: End of maze detected (IST=3)")

    # Return to IDLE
    full_maze.add_step(SCSPacket(0, 0, 0, 0), "System reset to IDLE")

    return full_maze
```

---

## Test Validation Criteria

For the test suite to be **fully compliant** with HUB QTP requirements:

### ✅ Must Pass:
1. **QTP1:** First line detection with proper REVERSE (N1.2)
2. **QTP2:** Two complete GREEN line rotations
3. **QTP3:** Wall line handling (BLACK/BLUE)
4. **QTP4:** [To be determined from official specs]
5. **QTP5:** End-of-maze and state cleanup
6. **Full Maze:** Sequential execution of all QTPs

### Validation Points:
- [ ] Calibration lasts ~60 seconds with continuous packet exchange
- [ ] SNC transitions IDLE → CAL → MAZE correctly
- [ ] NAVCON activates (IST=3) in MAZE state
- [ ] REVERSE command sent before rotation on angled lines (N1.2)
- [ ] Rotation sequences complete successfully (2/2 for QTP2)
- [ ] BLACK/BLUE walls trigger appropriate behavior
- [ ] End-of-maze triggers return to IDLE
- [ ] All SCS packets follow correct format
- [ ] No timeout errors or protocol violations

---

## Conclusion

**Current Status:** The NAVCON test suite provides a good foundation but is **incomplete for full HUB compliance**.

**Missing Components:**
1. QTP1 implementation (critical - tests N1.2 compliance)
2. QTP2 validation enhancement
3. QTP3, QTP4, QTP5 (specifications needed)
4. Full Maze Test implementation

**Recommendation:**
1. Prioritize implementing QTP1 - it tests fundamental NAVCON behavior
2. Obtain official AMazeEng QTP specifications for QTP3-5
3. Implement full maze test as sequential execution of all QTPs
4. Add validation logic to verify expected behavior at each stage

**Risk:** Without QTP1, the test suite cannot validate critical N1.2 compliance (REVERSE before rotation), which is a fundamental NAVCON requirement shown in the HUB logs.

---

## Next Steps

1. **Immediate:** Implement QTP1 test with N1.2 validation
2. **Short-term:** Enhance QTP2 with rotation tracking
3. **Medium-term:** Research QTP3-5 requirements from official documentation
4. **Long-term:** Implement full maze simulation test

The test suite will be considered **HUB-compliant** once all 5 QTPs are implemented and the Full Maze test successfully simulates a complete maze run matching the patterns observed in `demo_log.txt` and `All_QTP_From_HUB.txt`.
