Bud-wiser-er/ERD320-FinalReport/Phase3/Phase3/NAVCON_Test_Suite/navcon_test_log_20251005_144902.txt

MARV NAVCON Test Log
==================================================
Generated: 2025-10-05 14:49:02
Scenario: Full Maze: All Colors
==================================================
