Bud-wiser-er/ERD320-FinalReport/Phase3/Phase3/NAVCON_Test_Suite/navcon_test_log_20251005_151916.txt

MARV NAVCON Test Log
==================================================
Generated: 2025-10-05 15:19:16
Scenario: Full Maze: All Colors
==================================================
