Bud-wiser-er/ERD320-FinalReport/Phase 1/Pure tone sims/MATLAB sims for gain/MCP6024_Analysis_Results.csv

Input_Signal_uV | Input_Signal_mV | Required_Gain | Required_Gain_dB | GBW_Limit_Hz | Slew_Rate_Limit_Hz | Output_Swing_OK | Overall_Feasible
20 | 0.02 | 250000 | 107.958800173441 | 40 | 381971.863420549 | 0 | 0
23.2192498421648 | 0.0232192498421648 | 215338.567524274 | 106.662436394234 | 46.4384996843296 | 381971.863420549 | 0 | 0
26.9566781616436 | 0.0269566781616436 | 185482.794653625 | 105.366072615028 | 53.9133563232871 | 381971.863420549 | 0 | 0
31.2956922575015 | 0.0312956922575015 | 159766.397204443 | 104.069708835822 | 62.591384515003 | 381971.863420549 | 0 | 0
36.3331248755215 | 0.0363331248755215 | 137615.468450076 | 102.773345056615 | 72.6662497510431 | 381971.863420549 | 0 | 0
42.1813952015654 | 0.0421813952015654 | 118535.671380885 | 101.476981277409 | 84.3627904031308 | 381971.863420549 | 0 | 0
48.971017693812 | 0.048971017693812 | 102101.206702752 | 100.180617498202 | 97.942035387624 | 381971.863420549 | 0 | 0
56.8535147428846 | 0.0568535147428846 | 87945.3103754815 | 98.884253718996 | 113.707029485769 | 381971.863420549 | 0 | 0
66.0047981610119 | 0.0660047981610119 | 75752.0686269355 | 97.5878899397895 | 132.009596322024 | 381971.863420549 | 0 | 0
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
