Bud-wiser-er/ERD320-FinalReport/Verification/Phase2_Lab_Results/Pure_Tone_Oscilloscope/Cascaded MFB/TEK00000.CSV

Model | TBS1072C
Firmware Version | v2015-08-04-prequal4ch70_v1.3
Point Format | Y
Horizontal Units | S
Horizontal Scale | 0.004
Sample Interval | 3.2e-05
Filter Frequency | 2e+08
Record Length | 2000
Gating | 0.0% to 100.0%
Probe Attenuation | 1
Vertical Units | V
Vertical Offset | 0
Vertical Scale | 0.05
Label
TIME | CH1
-3.200e-02 | 0
-3.197e-02 | 0
-3.194e-02 | 0
-3.190e-02 | 0.004
-3.187e-02 | 0
-3.184e-02 | 0
-3.181e-02 | 0
-3.178e-02 | 0
-3.174e-02 | 0
-3.171e-02 | 0
-3.168e-02 | 0
-3.165e-02 | 0
-3.162e-02 | 0
-3.158e-02 | 0
-3.155e-02 | 0.002
-3.152e-02 | 0.002
-3.149e-02 | 0
-3.146e-02 | 0
-3.142e-02 | 0.002
-3.139e-02 | 0
-3.136e-02 | 0
-3.133e-02 | 0
-3.130e-02 | 0
-3.126e-02 | 0
-3.123e-02 | 0
-3.120e-02 | 0
-3.117e-02 | 0
-3.114e-02 | 0
-3.110e-02 | 0
-3.107e-02 | 0
-3.104e-02 | 0
-3.101e-02 | 0
-3.098e-02 | 0
-3.094e-02 | 0
-3.091e-02 | 0
-3.088e-02 | 0
-3.085e-02 | 0
-3.082e-02 | 0
-3.078e-02 | 0.002
-3.075e-02 | 0
-3.072e-02 | 0
-3.069e-02 | 0
-3.066e-02 | 0
-3.062e-02 | 0
-3.059e-02 | 0
-3.056e-02 | 0
-3.053e-02 | 0
-3.050e-02 | 0
-3.046e-02 | 0
-3.043e-02 | 0
-3.040e-02 | 0
-3.037e-02 | 0
-3.034e-02 | 0
-3.030e-02 | 0
-3.027e-02 | 0
-3.024e-02 | 0
-3.021e-02 | 0
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
