Bud-wiser-er/ERD320-FinalReport/Verification/Phase2_Lab_Results/Pure_Tone_Oscilloscope/First MFB connected to MIC input/TEK00000.CSV

Model | TBS1072C
Firmware Version | v2015-08-04-prequal4ch70_v1.3
Point Format | Y
Horizontal Units | Hz
Horizontal Scale | 390.625
Sample Interval | 12.5
Filter Frequency | 2e+08
Record Length | 1250
Gating | 0.0% to 100.0%
Probe Attenuation | 1
Vertical Units | dB
Vertical Offset | 0
Vertical Scale | 20
Label
FFT-FREQ | FFT-AMPL
0.000e+00 | -78.4156
1.250e+01 | -82.0406
2.500e+01 | -85.6656
3.750e+01 | -80.7875
5.000e+01 | -75.9094
6.250e+01 | -84.1469
7.500e+01 | -92.3812
8.750e+01 | -86.2281
1.000e+02 | -80.075
1.125e+02 | -83.3469
1.250e+02 | -86.6188
1.375e+02 | -86.575
1.500e+02 | -86.5312
1.625e+02 | -89.0062
1.750e+02 | -91.4781
1.875e+02 | -94.0062
2.000e+02 | -96.5312
2.125e+02 | -94.4563
2.250e+02 | -92.3812
2.375e+02 | -90.9625
2.500e+02 | -89.5406
2.625e+02 | -89.4563
2.750e+02 | -89.3719
2.875e+02 | -96.4469
3.000e+02 | -103.519
3.125e+02 | -97.0156
3.250e+02 | -90.5094
3.375e+02 | -92.5
3.500e+02 | -94.4906
3.625e+02 | -99.0062
3.750e+02 | -103.519
3.875e+02 | -100.025
4.000e+02 | -96.5312
4.125e+02 | -93.75
4.250e+02 | -90.9688
4.375e+02 | -97.2438
4.500e+02 | -103.519
4.625e+02 | -97.95
4.750e+02 | -92.3812
4.875e+02 | -92.95
5.000e+02 | -93.5188
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
