Bud-wiser-er/ERD320-FinalReport/Verification/Phase2_Lab_Results/Pure_Tone_Oscilloscope/First MFB/TEK00000.CSV

Model | TBS1072C
Firmware Version | v2015-08-04-prequal4ch70_v1.3
Point Format | Y
Horizontal Units | Hz
Horizontal Scale | 390.625
Sample Interval | 12.5
Filter Frequency | 2e+08
Record Length | 1250
Gating | 0.0% to 100.0%
Probe Attenuation | 1
Vertical Units | dB
Vertical Offset | 0
Vertical Scale | 20
Label
FFT-FREQ | FFT-AMPL
0.000e+00 | -103.519
1.250e+01 | -96.2094
2.500e+01 | -88.8969
3.750e+01 | -93.2
5.000e+01 | -97.5
6.250e+01 | -95.5094
7.500e+01 | -93.5188
8.750e+01 | -92.95
1.000e+02 | -92.3812
1.125e+02 | -94.9406
1.250e+02 | -97.5
1.375e+02 | -97.0156
1.500e+02 | -96.5312
1.625e+02 | -96.5312
1.750e+02 | -96.5312
1.875e+02 | -94.0062
2.000e+02 | -91.4781
2.125e+02 | -94.0062
2.250e+02 | -96.5312
2.375e+02 | -95.5125
2.500e+02 | -94.4906
2.625e+02 | -94.0062
2.750e+02 | -93.5188
2.875e+02 | -92.95
3.000e+02 | -92.3812
3.125e+02 | -93.1813
3.250e+02 | -93.9781
3.375e+02 | -95.2562
3.500e+02 | -96.5312
3.625e+02 | -98.5219
3.750e+02 | -100.509
3.875e+02 | -102.016
4.000e+02 | -103.519
4.125e+02 | -102.016
4.250e+02 | -100.509
4.375e+02 | -98.5219
4.500e+02 | -96.5312
4.625e+02 | -100.025
4.750e+02 | -103.519
4.875e+02 | -100.025
5.000e+02 | -96.5312
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
