Bud-wiser-er/ERD320-FinalReport/EPR320_Group_45_Final_Report/02_SS/figures/display_led_array_sim_result.png

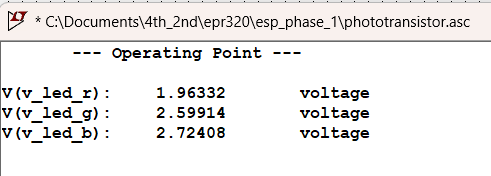
EPR320_Group_45_Final_Report/02_SS/figures/display_led_array_sim_result.png
