Bud-wiser-er/ERD320-FinalReport/Phase3/out/Documentation/FlowCharts/1_NAVCON_Tester_Maze_Flow/NAVCON_Tester_Maze_Flow.png

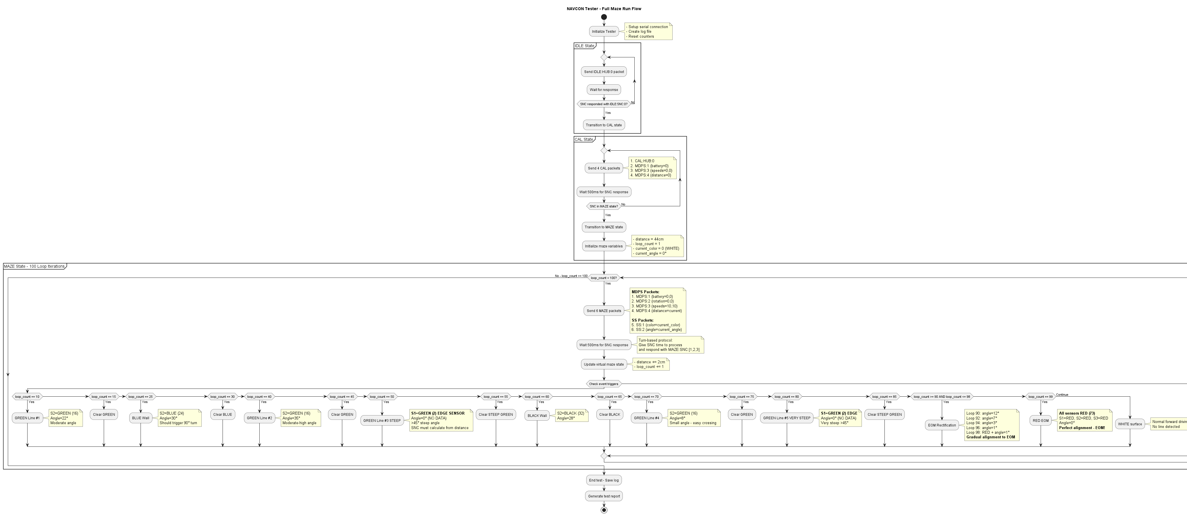
Phase3/out/Documentation/FlowCharts/1_NAVCON_Tester_Maze_Flow/NAVCON_Tester_Maze_Flow.png
