Bud-wiser-er/ERD320-FinalReport/Verification/Phase2_Lab_Results/Pure_Tone_Oscilloscope/Cascaded MFB/TEK00002.PNG

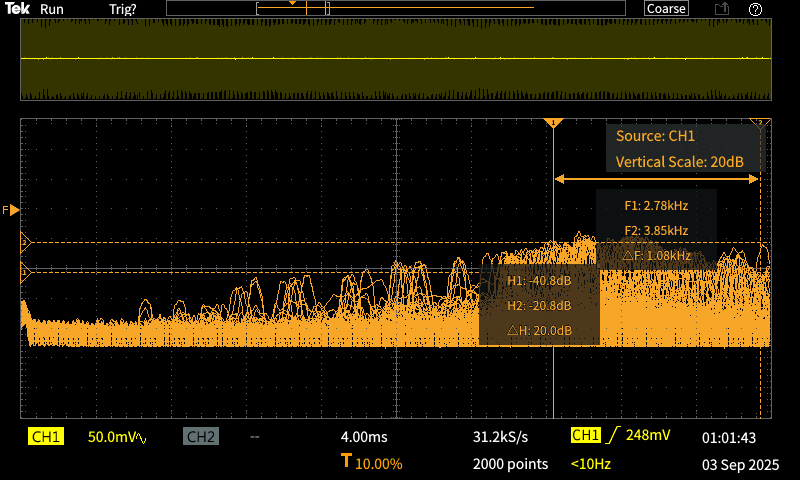
Verification/Phase2_Lab_Results/Pure_Tone_Oscilloscope/Cascaded MFB/TEK00002.PNG
