Bud-wiser-er/ERD320-FinalReport/Verification/Phase2_Lab_Results/Pure_Tone_Oscilloscope/First MFB connected to MIC input/TEK00000.PNG

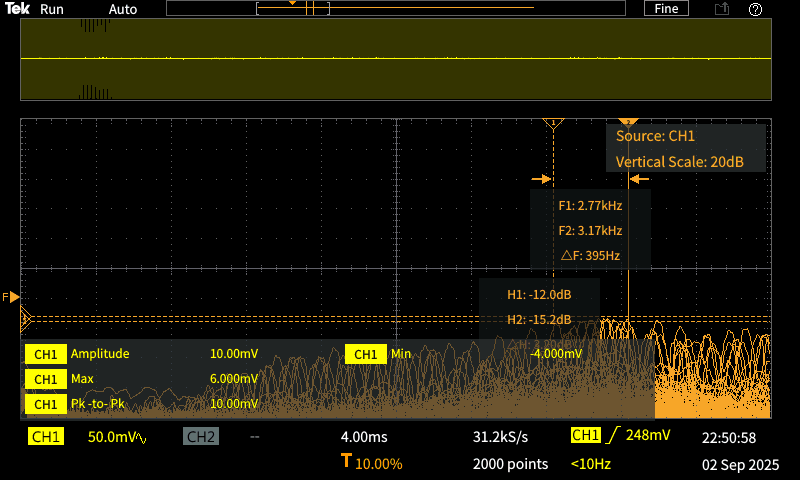
Verification/Phase2_Lab_Results/Pure_Tone_Oscilloscope/First MFB connected to MIC input/TEK00000.PNG
