Bud-wiser-er/ERD320-FinalReport/Verification/Phase2_Lab_Results/Pure_Tone_Oscilloscope/First MFB/TEK00000.PNG

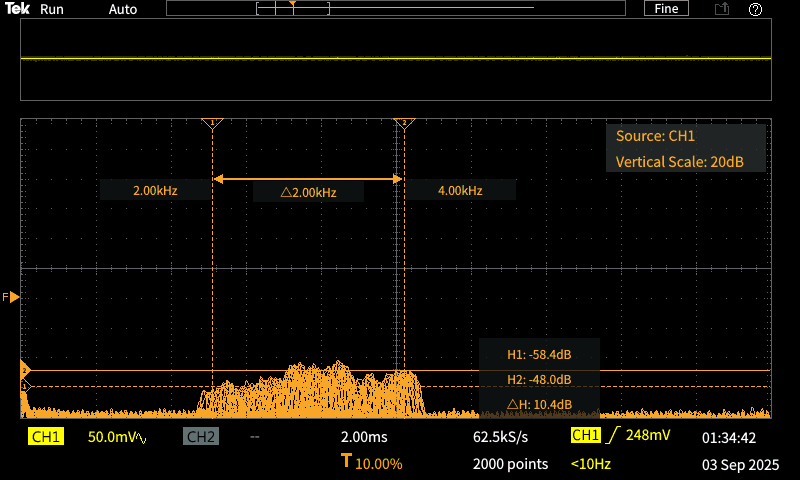
Verification/Phase2_Lab_Results/Pure_Tone_Oscilloscope/First MFB/TEK00000.PNG
