Bud-wiser-er/ERD320-FinalReport/Verification/Phase2_Lab_Results/Pure_Tone_Oscilloscope/Time Domain 2000/TEK00002.PNG

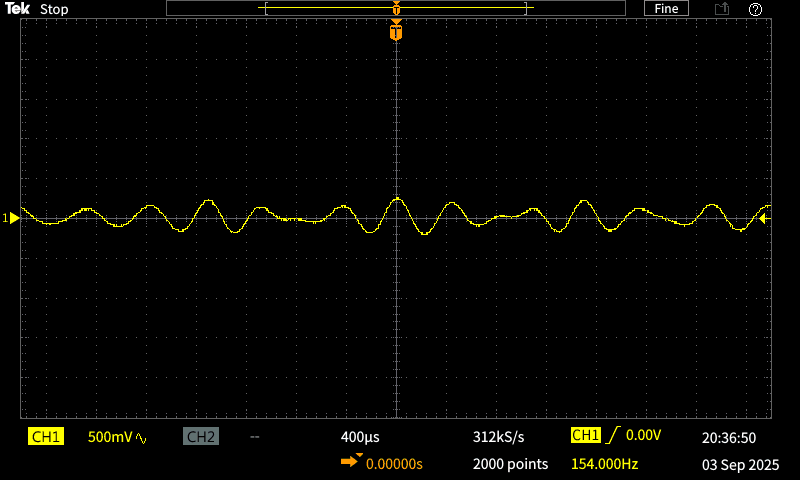
Verification/Phase2_Lab_Results/Pure_Tone_Oscilloscope/Time Domain 2000/TEK00002.PNG
