Bud-wiser-er/ERD320-FinalReport/Verification/Phase2_Lab_Results/Pure_Tone_Oscilloscope/Time Domain 2800/TEK00000.PNG

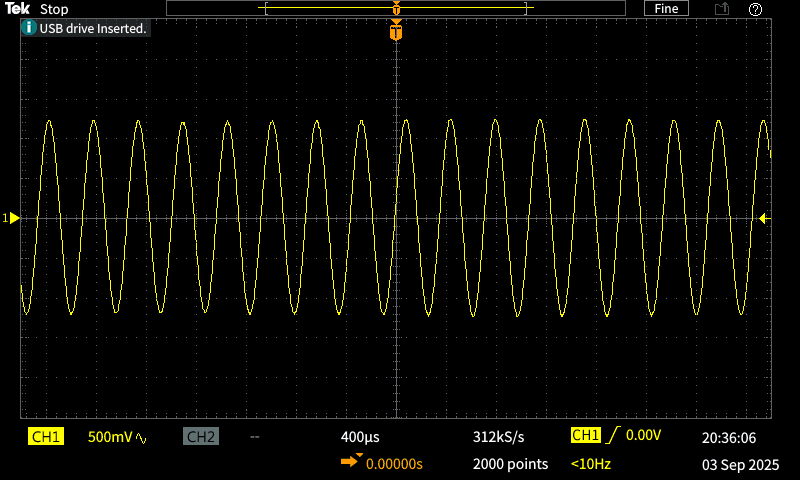
Verification/Phase2_Lab_Results/Pure_Tone_Oscilloscope/Time Domain 2800/TEK00000.PNG
