Bud-wiser-er/ERD320-FinalReport/Verification/Phase2_Lab_Results/Pure_Tone_Oscilloscope/Time Domain at diffrent Freq/TEK00003.PNG

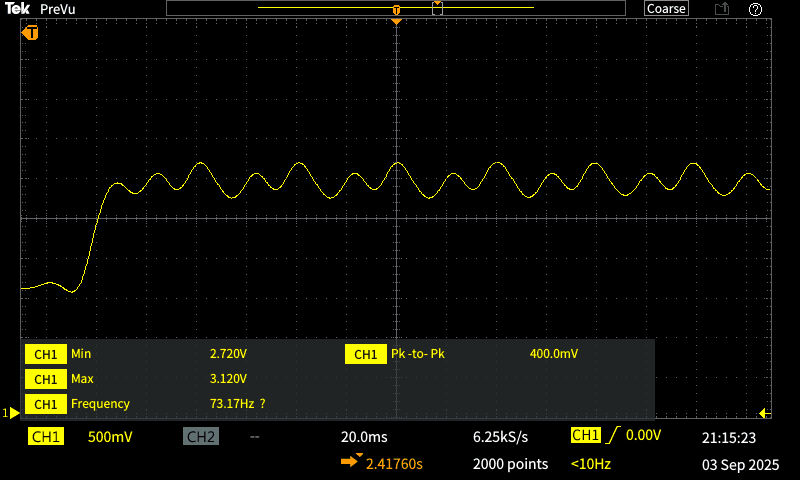
Verification/Phase2_Lab_Results/Pure_Tone_Oscilloscope/Time Domain at diffrent Freq/TEK00003.PNG
