Bud-wiser-er/ERD320-FinalReport/EPR320_Group_45_Final_Report/01_SNC/diagrams/architecture_interfaces/out/architecture_interfaces.pdf

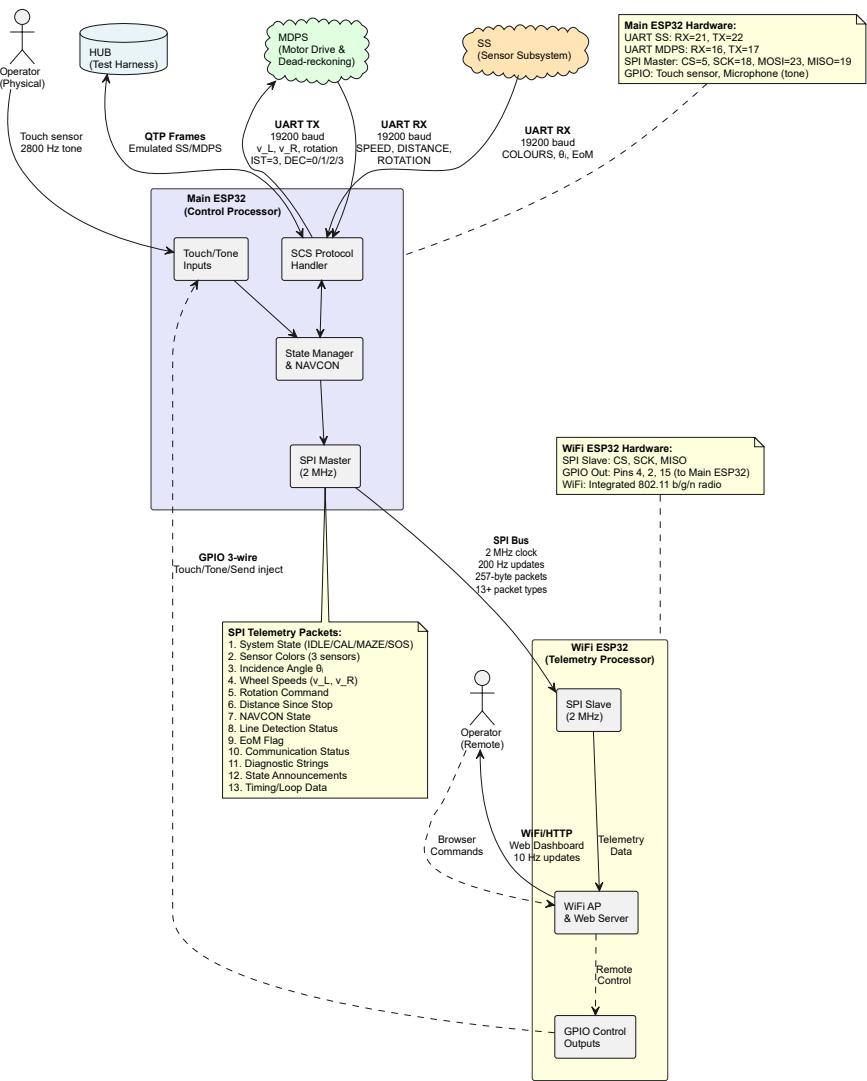
[picture p120: page 1]
Main ESP32 (Control Processor); WiFi ESP32 (Telemetry Processor); SCS Protocol Handler; State Manager & NAVCON; SPI Master (2 MHz); Touch/Tone Inputs; SPI Slave (2 MHz); WiFi AP & Web Server; GPIO Control Outputs; SS (Sensor Subsystem); MDPS (Motor Drive & Dead-reckoning); HUB; Operator (Remote); UART RX 19200 baud SPEED, DISTANCE, ROTATION; UART TX 19200 baud v_L, v_R, rotation IST=3, DEC=0/1/2/3; Touch sensor 2800 Hz tone; SPI Bus 2 MHz clock 200 Hz updates 257-byte packets 13+ packet types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

Main ESP32 Hardware:
UART SS: RX=21, TX=22
UART MDPS: RX=16, TX=17
SPI Master: CS=5, SCK=18, MOSI=23, MISO=19
GPIO: Touch sensor, Microphone (tone)

(Test Harness) Operator
(Physical)

UART RX
19200 baud
COLOURS, θᵢ, EoM

QTP Frames
Emulated SS/MDPS

WiFi ESP32 Hardware:
SPI Slave: CS, SCK, MISO
GPIO Out: Pins 4, 2, 15 (to Main ESP32)
WiFi: Integrated 802.11 b/g/n radio

GPIO 3-wire
Touch/Tone/Send inject

SPI Telemetry Packets:
1. System State (IDLE/CAL/MAZE/SOS)
2. Sensor Colors (3 sensors)
3. Incidence Angle θᵢ
4. Wheel Speeds (v_L, v_R)
5. Rotation Command
6. Distance Since Stop
7. NAVCON State
8. Line Detection Status
9. EoM Flag
10. Communication Status
11. Diagnostic Strings
12. State Announcements
13. Timing/Loop Data
