Bud-wiser-er/ERD320-FinalReport/EPR320_Group_45_Final_Report/01_SNC/diagrams/architecture_main_esp32/out/architecture_main_esp32.pdf

## Main ESP32 Functional Architecture (Control Processor)

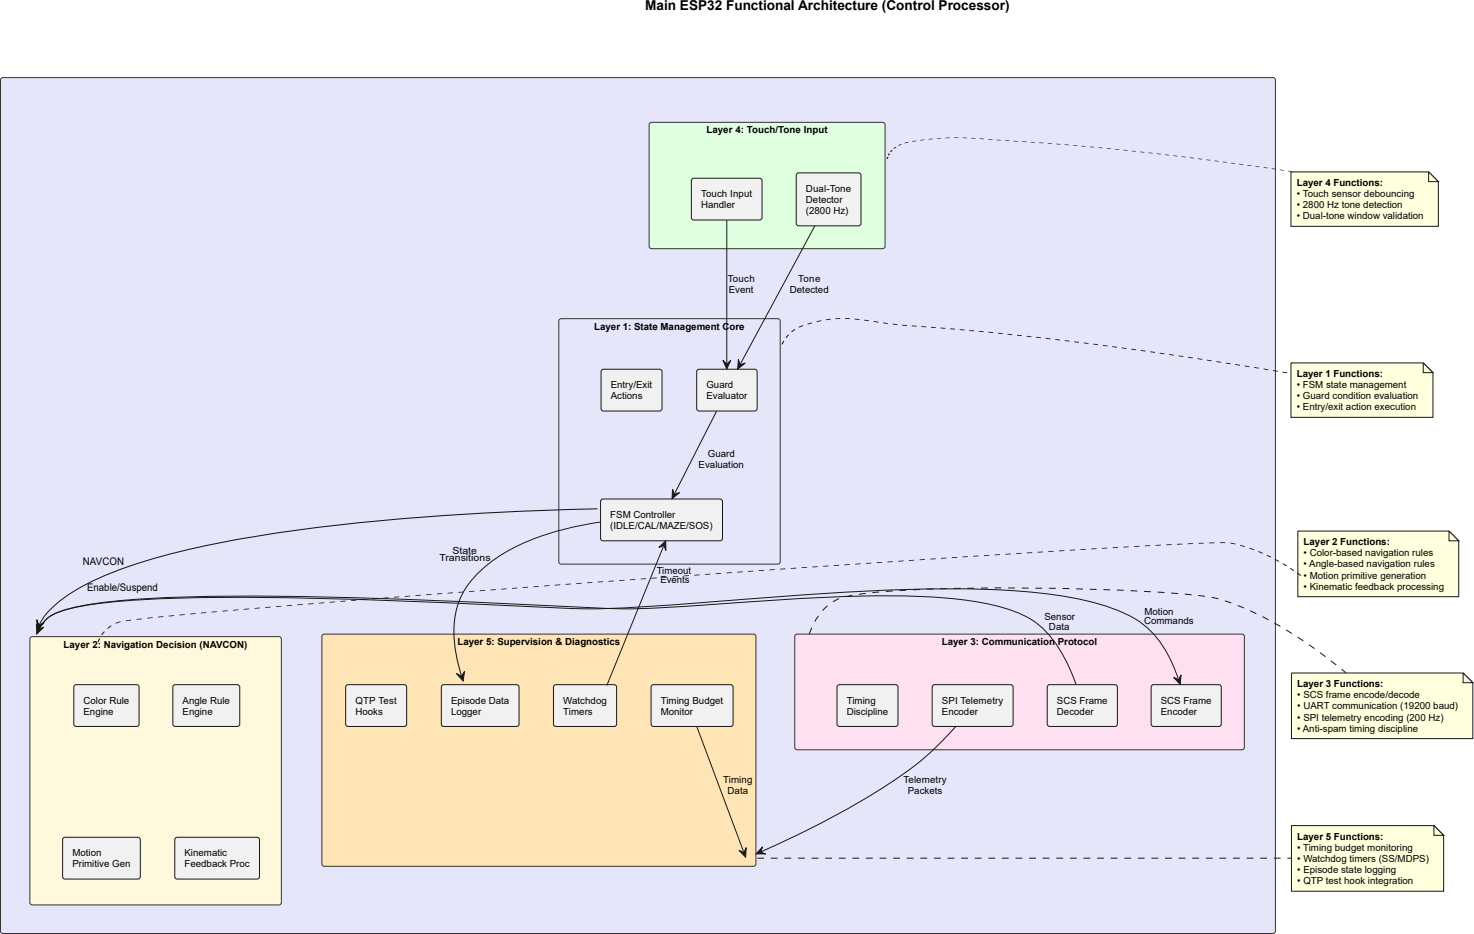
[picture p121: page 1]
Layer 2: Navigation Decision (NAVCON); Layer 3: Communication Protocol; Timing Budget Monitor; Watchdog Timers; Episode Data Logger; QTP Test Hooks; Touch Input Handler; Dual-Tone Detector (2800 Hz); SCS Frame Encoder; SCS Frame Decoder; SPI Telemetry Encoder; Timing Discipline; Color Rule Engine; Angle Rule Engine; Motion Primitive Gen; Kinematic Feedback Proc; Guard Evaluator; Entry/Exit Actions; Tone Detected; Touch Event; Guard Evaluation; Enable/Suspend; NAVCON; Sensor Data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

Layer 4: Touch/Tone Input

Layer 4 Functions:
• Touch sensor debouncing
• 2800 Hz tone detection
• Dual-tone window validation

Layer 1: State Management Core

Layer 1 Functions:
• FSM state management
• Guard condition evaluation
• Entry/exit action execution

FSM Controller
(IDLE/CAL/MAZE/SOS)

Layer 2 Functions:
• Color-based navigation rules
• Angle-based navigation rules
• Motion primitive generation
• Kinematic feedback processing

Layer 5: Supervision & Diagnostics

Layer 3 Functions:
• SCS frame encode/decode
• UART communication (19200 baud)
• SPI telemetry encoding (200 Hz)
• Anti-spam timing discipline

Layer 5 Functions:
• Timing budget monitoring
• Watchdog timers (SS/MDPS)
• Episode state logging
• QTP test hook integration
