Bud-wiser-er/ERD320-FinalReport/EPR320_Group_45_Final_Report/01_SNC/diagrams/architecture_wifi_esp32/out/architecture_wifi_esp32.pdf

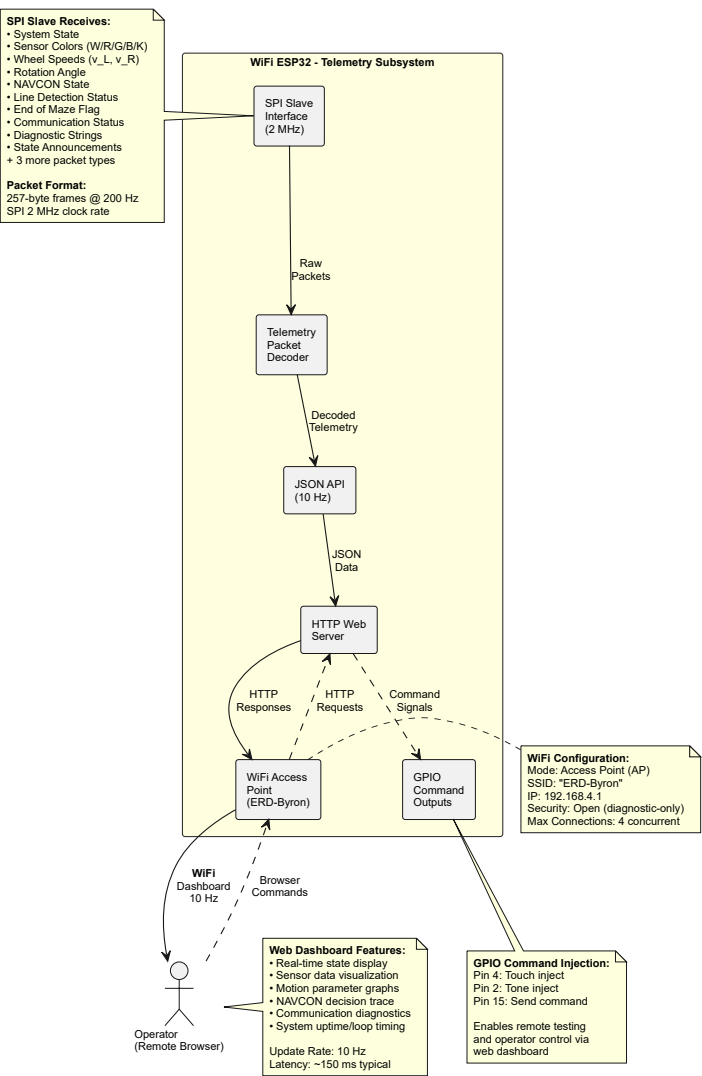
[picture p122: page 1]
SPI Slave Interface (2 MHz); Telemetry Packet Decoder; WiFi Access Point (ERD-Byron); HTTP Web Server; JSON API (10 Hz); GPIO Command Outputs; Operator (Remote Browser); Raw Packets; Decoded Telemetry; JSON Data; HTTP Responses; HTTP Requests; WiFi Dashboard 10 Hz; Browser Commands; Command Signals

SPI Slave Receives:
• System State
• Sensor Colors (W/R/G/B/K)
• Wheel Speeds (v_L, v_R)
• Rotation Angle
• NAVCON State
• Line Detection Status
• End of Maze Flag
• Communication Status
• Diagnostic Strings
• State Announcements
+ 3 more packet types

WiFi ESP32 - Telemetry Subsystem

Packet Format:
257-byte frames @ 200 Hz
SPI 2 MHz clock rate

WiFi Configuration:
Mode: Access Point (AP)
SSID: "ERD-Byron"
Security: Open (diagnostic-only)
Max Connections: 4 concurrent

Web Dashboard Features:
• Real-time state display
• Sensor data visualization
• Motion parameter graphs
• NAVCON decision trace
• Communication diagnostics
• System uptime/loop timing

GPIO Command Injection:
Pin 4: Touch inject
Pin 2: Tone inject
Pin 15: Send command

Enables remote testing
and operator control via
web dashboard

Update Rate: 10 Hz
Latency: ~150 ms typical
