Bud-wiser-er/ERD320-FinalReport/EPR320_Group_45_Final_Report/01_SNC/diagrams/conops_swimlane/out/conops_swimlane.pdf

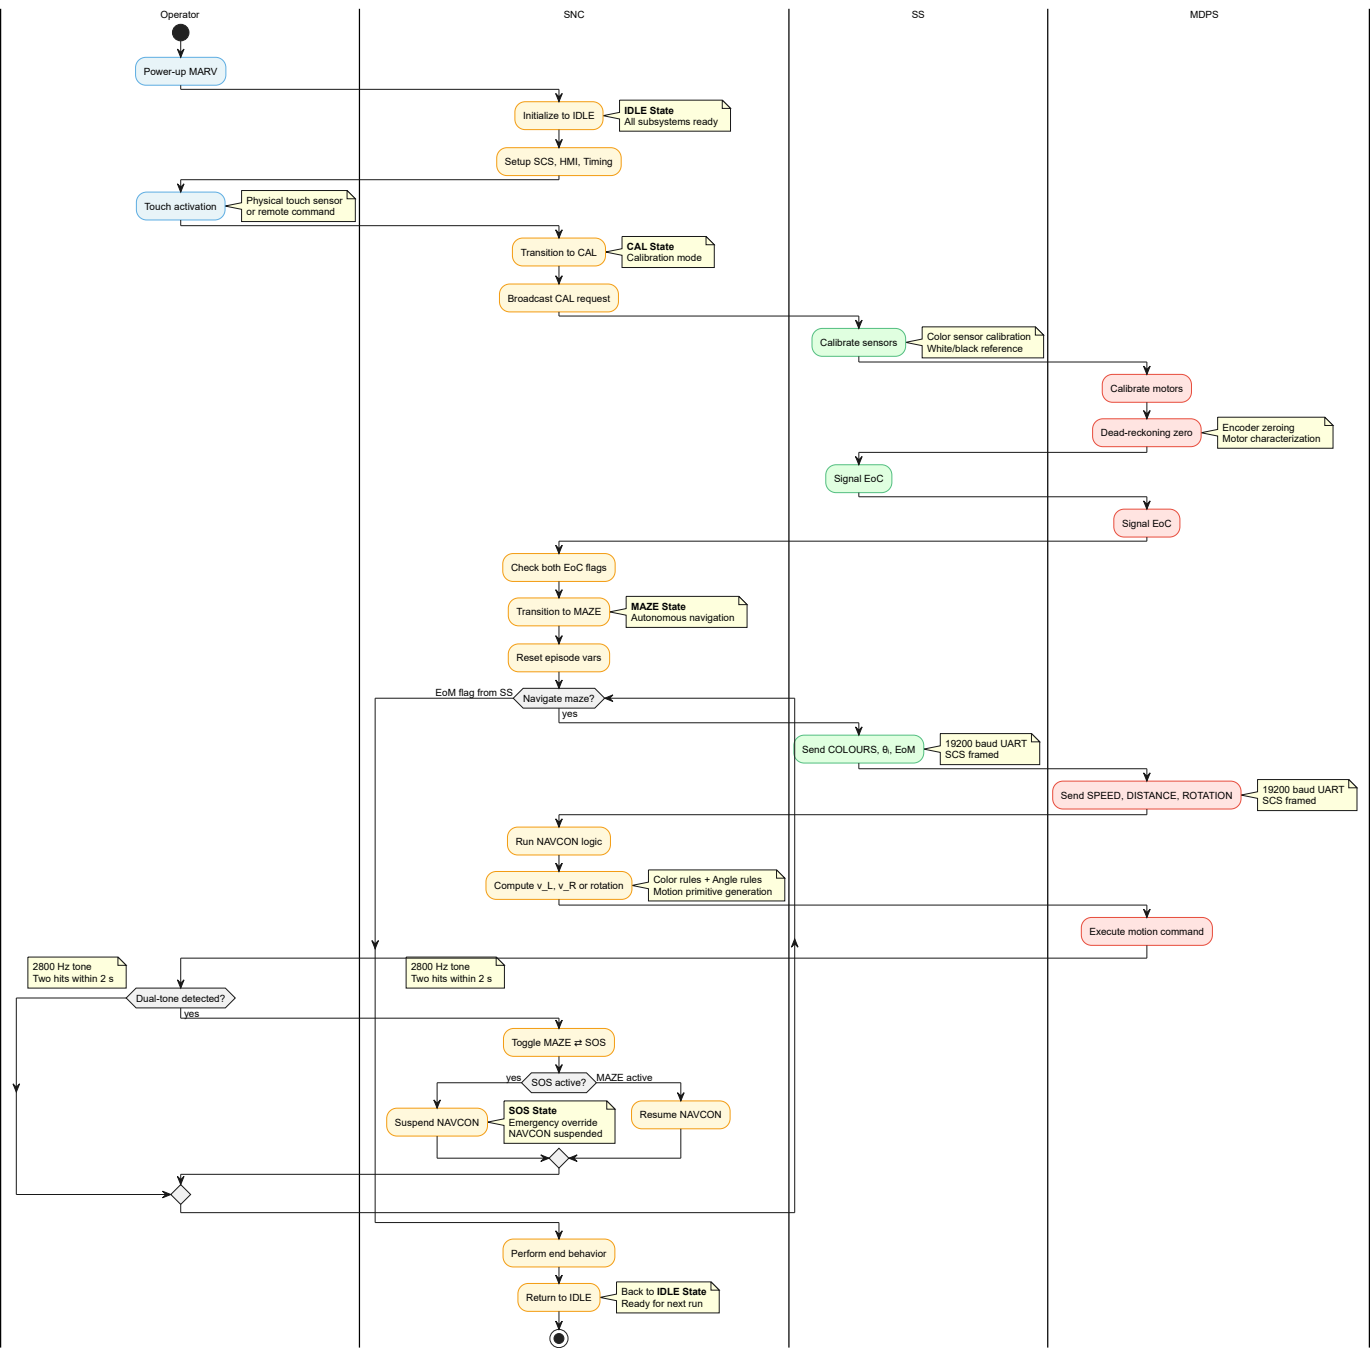
[picture p123: page 1]
yes; IDLE State; CAL State; MAZE State; NAVCON suspended; Signal EoC; 19200 baud UART; Calibrate motors; Encoder zeroing; Operator; SNC; MDPS

Power-up MARV

All subsystems ready Initialize to IDLE

Setup SCS, HMI, Timing

or remote command Touch activation

Physical touch sensor

Calibration mode Transition to CAL

Broadcast CAL request

Color sensor calibration

White/black reference Calibrate sensors

Motor characterization Dead-reckoning zero

Check both EoC flags

Autonomous navigation Transition to MAZE

Reset episode vars

Navigate maze? EoM flag from SS

SCS framed Send COLOURS, θᵢ, EoM

SCS framed Send SPEED, DISTANCE, ROTATION

Run NAVCON logic

Motion primitive generation Compute v_L, v_R or rotation

Color rules + Angle rules

Execute motion command

2800 Hz tone
Two hits within 2 s

2800 Hz tone Two hits within 2 s MAZE active Resume NAVCON

Dual-tone detected?

Suspend NAVCON | Toggle MAZE ⇄ SOS SOS active? yes SOS State Emergency override

Perform end behavior

Back to IDLE State

Ready for next run Return to IDLE
