Bud-wiser-er/ERD320-FinalReport/EPR320_Group_45_Final_Report/01_SNC/diagrams/dataflow/out/dataflow.pdf

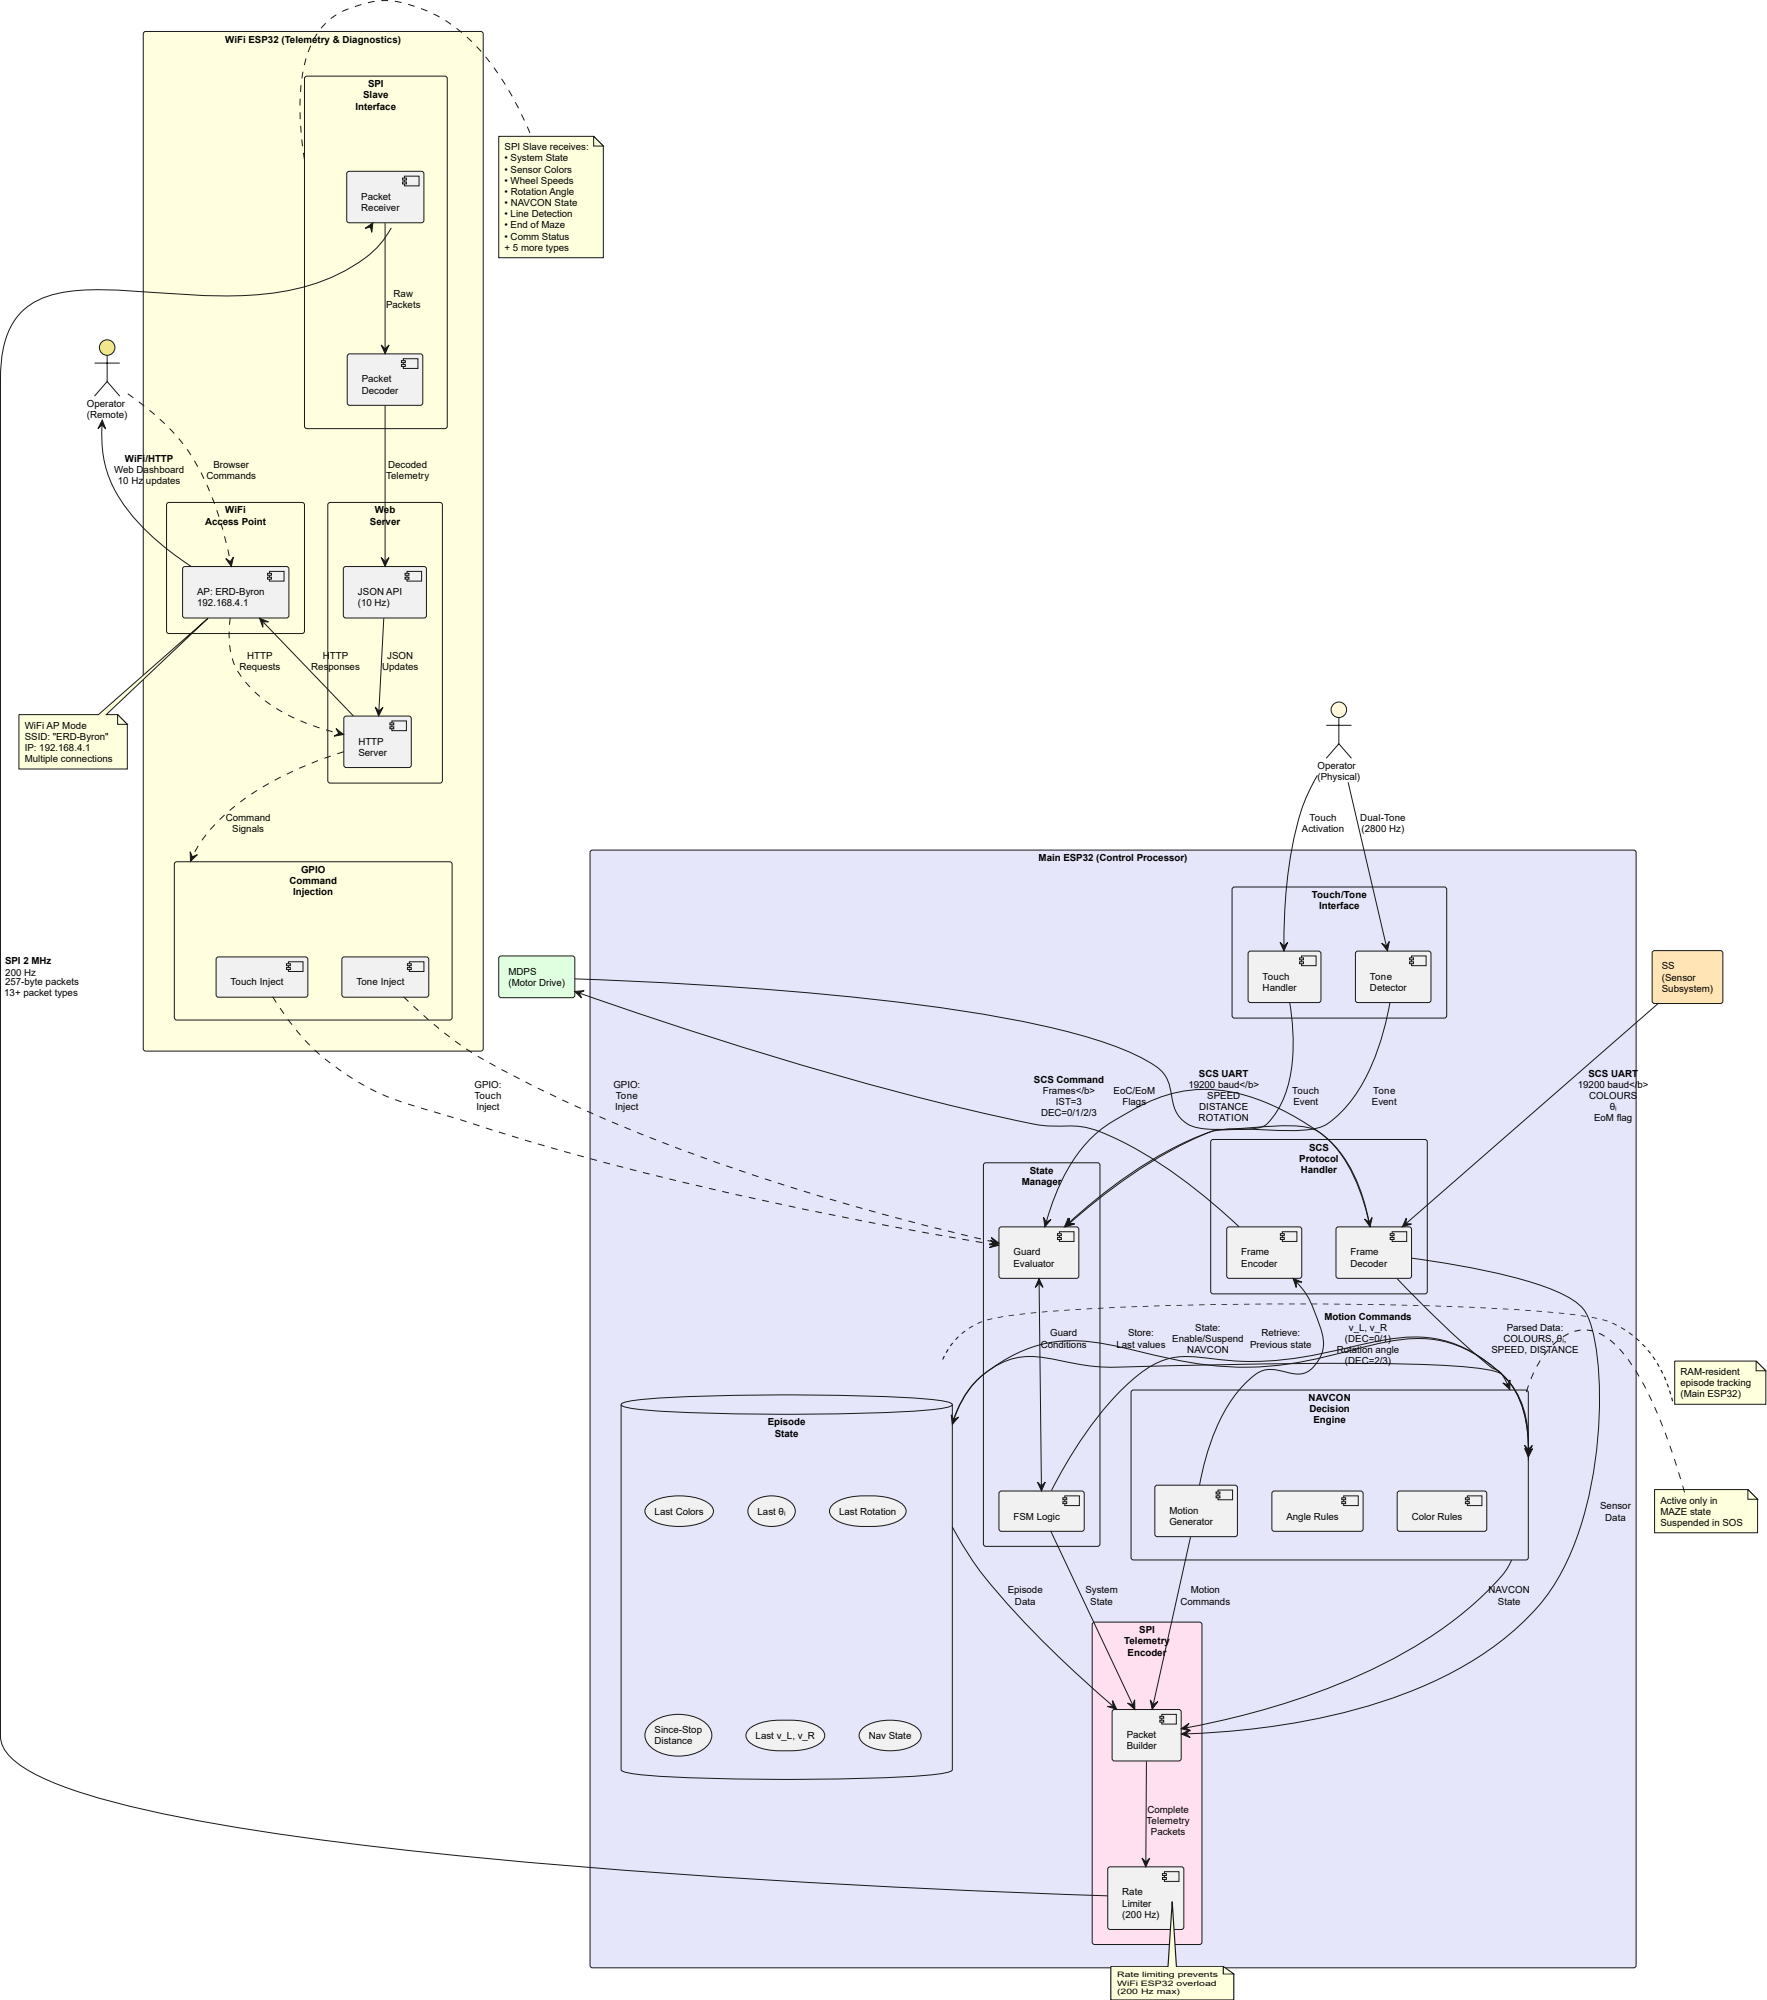
[picture p124: page 1]
State Manager; NAVCON Decision Engine; SCS Protocol Handler; Touch/Tone Interface; SPI Telemetry Encoder; Episode State; SPI Slave Interface; Web Server; WiFi Access Point; GPIO Command Injection; FSM Logic; Guard Evaluator; Angle Rules; Color Rules Motion; Generator; Frame Decoder; Frame Encoder; Touch Handler; Tone Detector; Packet Builder; Rate Limiter (200 Hz); Last Colors; Last θᵢ; Last Rotation; Since-Stop; Distance; Last v_L, v_R; Nav State; Packet Receiver; Packet Decoder; HTTP Server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

WiFi ESP32 (Telemetry & Diagnostics)

SPI Slave receives:
• System State
• Sensor Colors
• Wheel Speeds
• Rotation Angle
• NAVCON State
• Line Detection
• End of Maze
• Comm Status
+ 5 more types

AP: ERD-Byron

WiFi AP Mode
SSID: "ERD-Byron"
Multiple connections

Main ESP32 (Control Processor)

Active only in
MAZE state
Suspended in SOS

Rate limiting prevents
WiFi ESP32 overload
(200 Hz max)
