Bud-wiser-er/ERD320-FinalReport/EPR320_Group_45_Final_Report/01_SNC/diagrams/dataflow_main_control/out/dataflow_main_control.pdf

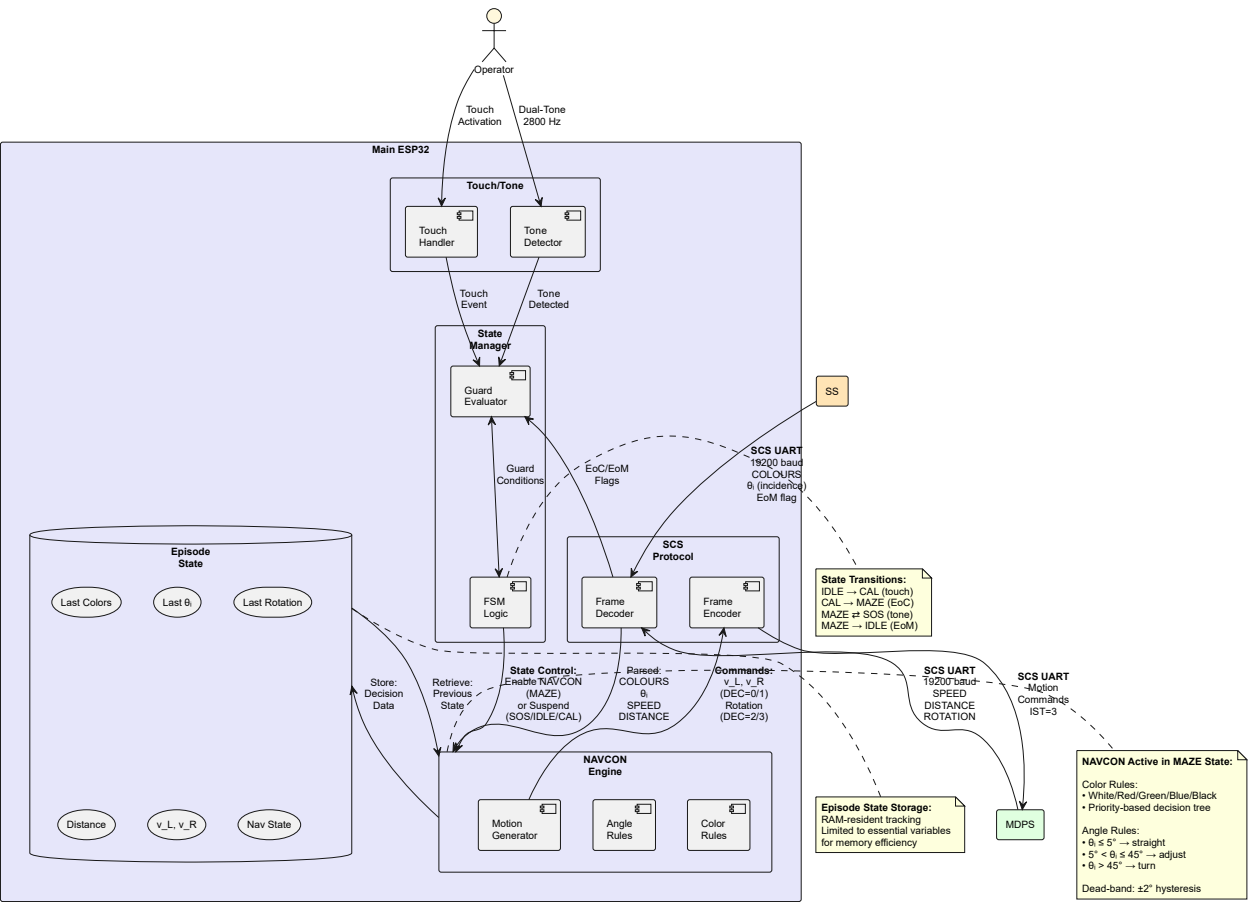
[picture p125: page 1]
Main ESP32; State Manager; NAVCON Engine; SCS Protocol; Touch/Tone; Episode State; FSM Logic; Guard Evaluator; Color Rules; Angle Rules; Motion Generator; Frame Decoder; Frame Encoder; Touch Handler; Tone Detector; Last Colors; Last θᵢ; Last Rotation; Distance; Nav State; MDPS; Operator; Angle Rules: • θᵢ ≤ 5° → straight • 5° < θᵢ ≤ 45° → adjust • θᵢ > 45° → turn; SCS UART 19200 baud COLOURS θᵢ (incidence) EoM flag; SCS UART 19200 baud SPEED DISTANCE ROTATION; Touch Activation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

State Transitions:
IDLE → CAL (touch)
CAL → MAZE (EoC)
MAZE ⇄ SOS (tone)
MAZE → IDLE (EoM)

State Control:
Enable NAVCON
(MAZE)
or Suspend
(SOS/IDLE/CAL)

NAVCON Active in MAZE State:

Color Rules:
• White/Red/Green/Blue/Black
• Priority-based decision tree

Episode State Storage:
RAM-resident tracking
Limited to essential variables
for memory efficiency

Dead-band: ±2° hysteresis
