Bud-wiser-er/ERD320-FinalReport/EPR320_Group_45_Final_Report/01_SNC/diagrams/navcon_decision_logic/out/navcon_decision_logic.pdf

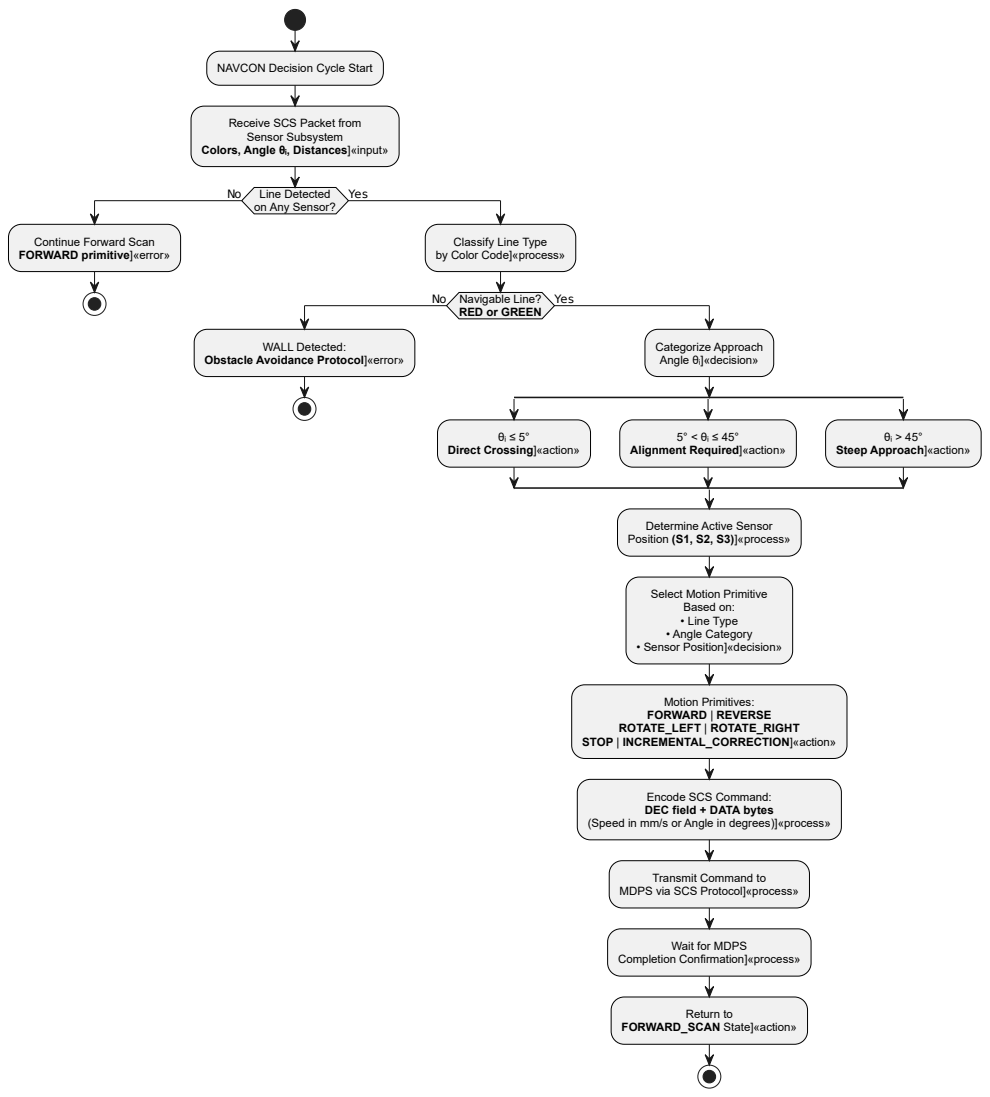
[picture p126: page 1]
Yes; WALL Detected:; Motion Primitives: FORWARD | REVERSE ROTATE_LEFT | ROTATE_RIGHT STOP | INCREMENTAL_CORRECTION]«action»; Return to FORWARD_SCAN State]«action»

NAVCON Decision Cycle Start

Receive SCS Packet from
Sensor Subsystem

Colors, Angle θᵢ, Distances]«input»

Line Detected
on Any Sensor?

Continue Forward Scan
FORWARD primitive]«error»

Classify Line Type
by Color Code]«process»

Navigable Line?
RED or GREEN

Categorize Approach
Angle θᵢ]«decision»

Obstacle Avoidance Protocol]«error»

Direct Crossing]«action»

Alignment Required]«action»

Steep Approach]«action»

Determine Active Sensor
Position (S1, S2, S3)]«process»

Select Motion Primitive
Based on:
• Line Type
• Angle Category
• Sensor Position]«decision»

Encode SCS Command:
DEC field + DATA bytes

(Speed in mm/s or Angle in degrees)]«process»

Transmit Command to
MDPS via SCS Protocol]«process»

Wait for MDPS

Completion Confirmation]«process»
