Bud-wiser-er/ERD320-FinalReport/EPR320_Group_45_Final_Report/01_SNC/diagrams/navcon_state_machine/out/navcon_state_machine.pdf

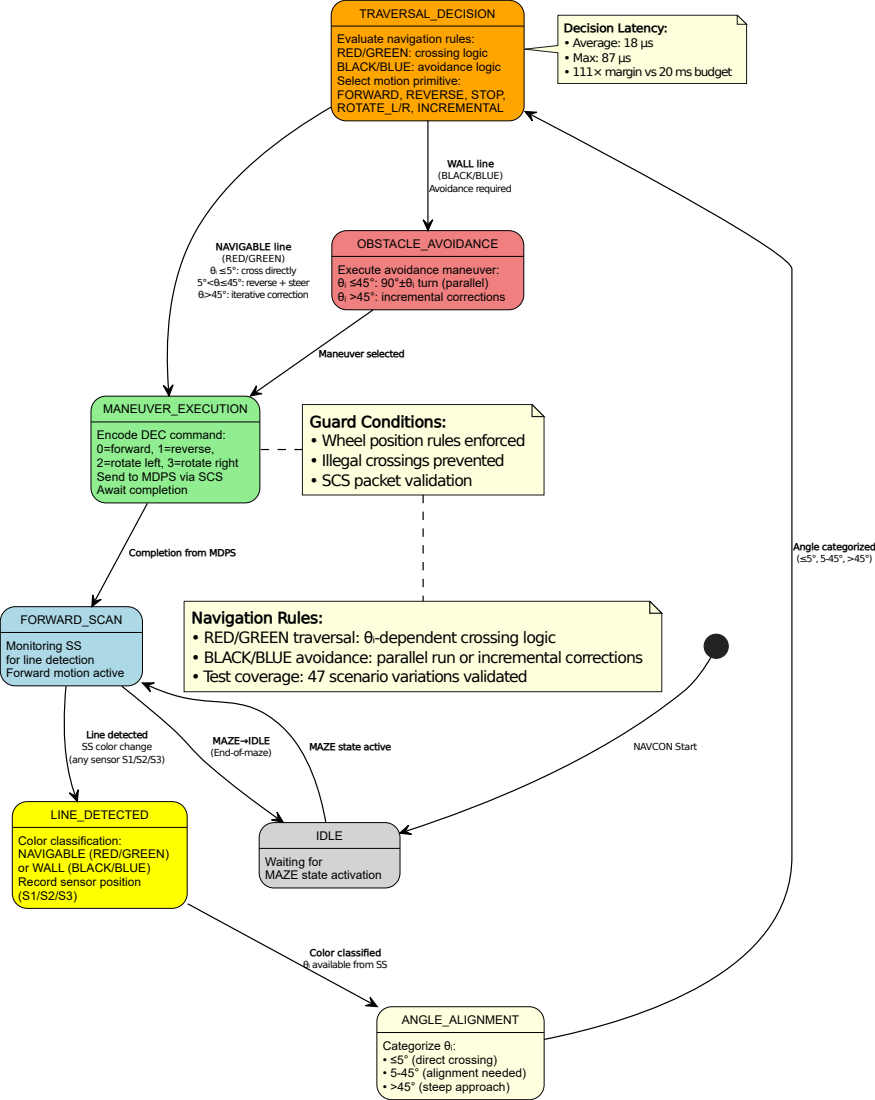
[picture p127: page 1]
IDLE; ANGLE_ALIGNMENT; Categorize θᵢ: • ≤5° (direct crossing) • 5-45° (alignment needed) • >45° (steep approach); MAZE state active; NAVCON Start MAZE→IDLE; Angle categorized (≤5°, 5-45°, >45°); WALL line (BLACK/BLUE) Avoidance required; Maneuver selected

TRAVERSAL_DECISION
Evaluate navigation rules:
RED/GREEN: crossing logic
BLACK/BLUE: avoidance logic
Select motion primitive:
FORWARD, REVERSE, STOP,
ROTATE_L/R, INCREMENTAL

Decision Latency:
• Average: 18 µs
• Max: 87 µs
• 111× margin vs 20 ms budget

NAVIGABLE line
(RED/GREEN)
θᵢ ≤5°: cross directly
5°<θᵢ≤45°: reverse+ steer
θᵢ>45°: iterative correction

OBSTACLE_AVOIDANCE
Execute avoidance maneuver:
θᵢ ≤45°: 90°±θᵢ turn (parallel)
θᵢ >45°: incremental corrections

MANEUVER_EXECUTION
Encode DEC command:
0=forward, 1=reverse,
2=rotate left, 3=rotate right
Send to MDPS via SCS
Await completion

Guard Conditions:
• Wheel position rules enforced
• Illegal crossings prevented
• SCS packet validation

Completion from MDPS

FORWARD_SCAN
Monitoring SS
for line detection
Forward motion active

Navigation Rules:
• RED/GREEN traversal: θᵢ-dependent crossing logic
• BLACK/BLUE avoidance: parallel run or incremental corrections
• Test coverage: 47 scenario variations validated

Line detected
SS color change
(any sensor S1/S2/S3)

(End-of-maze)

LINE_DETECTED
Color classification:
NAVIGABLE (RED/GREEN)
or WALL (BLACK/BLUE)
Record sensor position

Waiting for
MAZE state activation

Color classified
θᵢ available from SS
