Bud-wiser-er/ERD320-FinalReport/EPR320_Group_45_Final_Report/01_SNC/diagrams/pure_tone_detection_flow/out/pure_tone_detection_flow.pdf

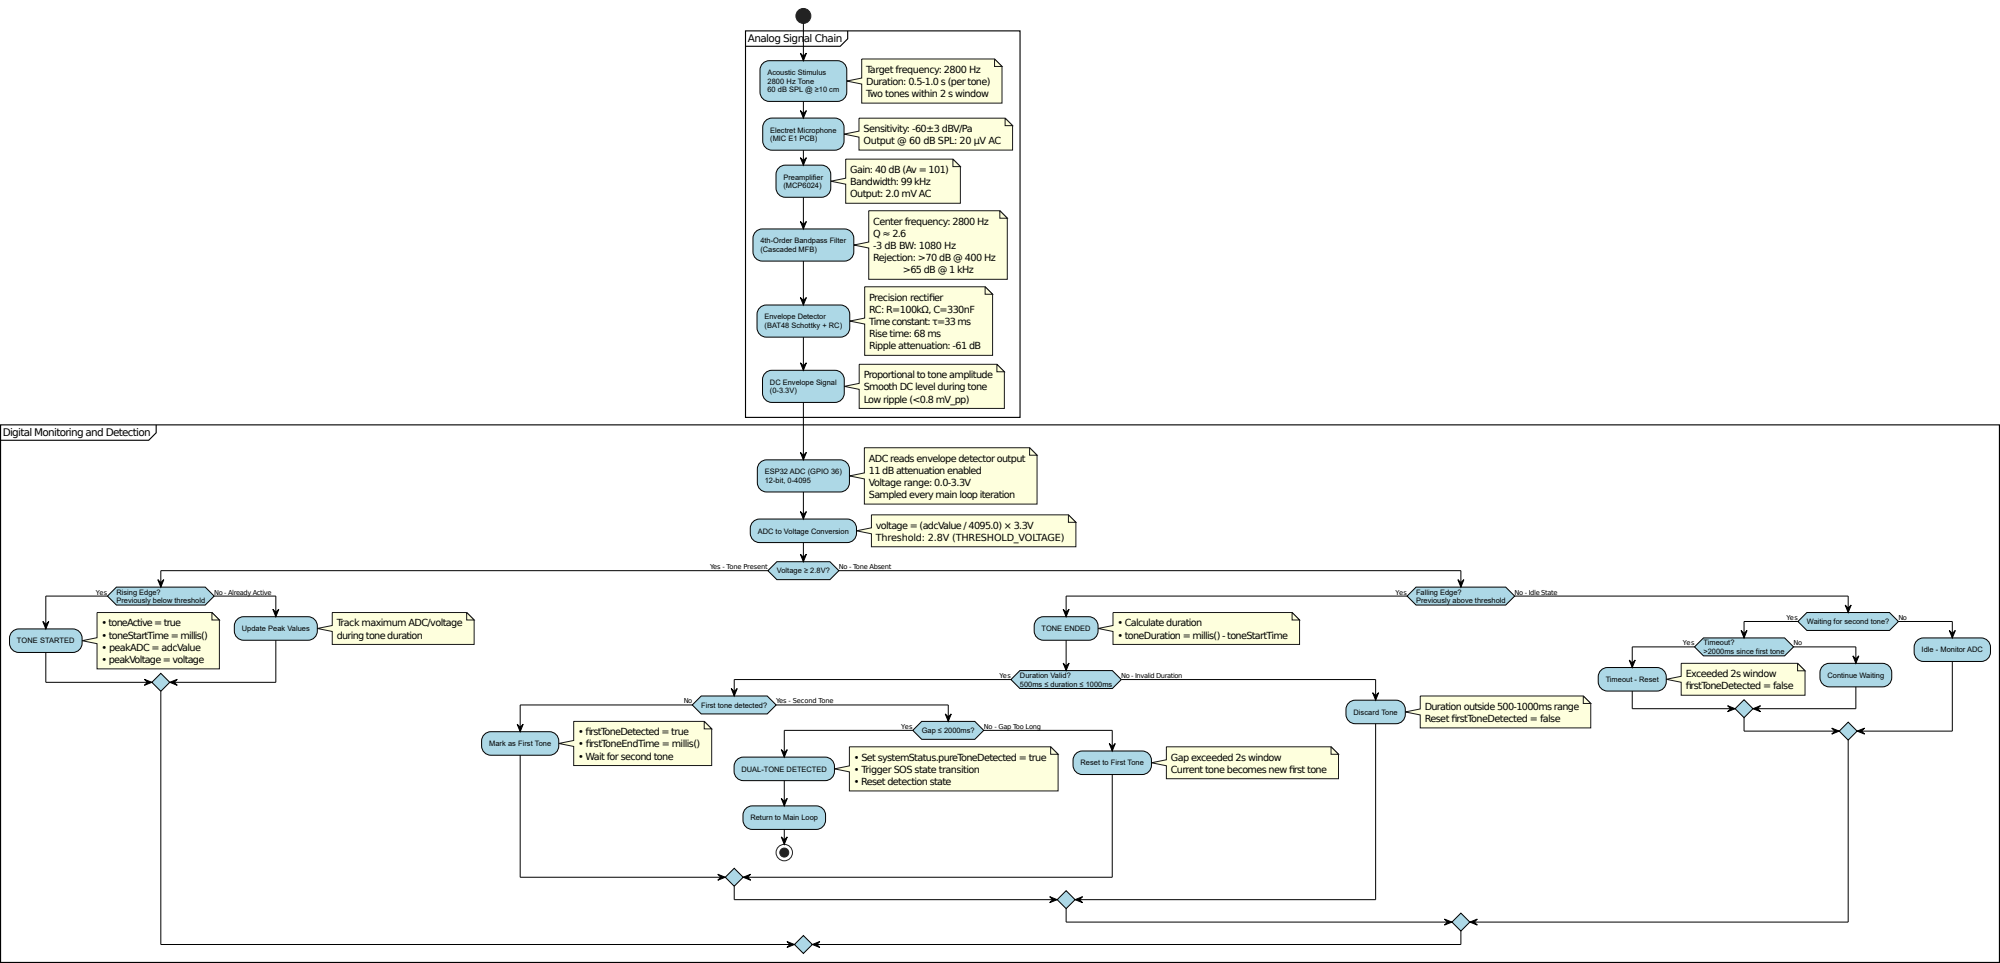
[picture p128: page 1]
Electret Microphone (MIC E1 PCB); Preamplifier (MCP6024); Envelope Detector (BAT48 Schottky + RC); ESP32 ADC (GPIO 36) 12-bit, 0-4095; voltage = (adcValue / 4095.0) × 3.3V; Voltage ≥ 2.8V? Yes - Tone Present; No - Tone Absent; Yes; No - Already Active; TONE STARTED; No - Idle State; • Calculate duration; Duration Valid? 500ms ≤ duration ≤ 1000ms; No - Invalid Duration; First tone detected? No; Yes - Second Tone; Gap ≤ 2000ms? Yes; No - Gap Too Long; Waiting for second tone? Yes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

Analog Signal Chain

Target frequency: 2800 Hz
Duration: 0.5-1.0 s (per tone)
Two tones within 2 s window

Acoustic Stimulus
2800 Hz Tone
60 dB SPL @ ≥10 cm

Sensitivity: -60±3 dBV/Pa
Output @ 60 dB SPL: 20 µV AC

Gain: 40 dB (Av = 101)
Bandwidth: 99 kHz
Output: 2.0 mV AC

Center frequency: 2800 Hz
Rejection: >70 dB @ 400 Hz
>65 dB @ 1 kHz

4th-Order Bandpass Filter
(Cascaded MFB)

Precision rectifier
Time constant: τ=33 ms
Rise time: 68 ms
Ripple attenuation: -61 dB

Proportional to tone amplitude
Smooth DC level during tone
Low ripple (<0.8 mV_pp)

DC Envelope Signal

Digital Monitoring and Detection

ADC reads envelope detector output
11 dB attenuation enabled
Voltage range: 0.0-3.3V
Sampled every main loop iteration

Threshold: 2.8V (THRESHOLD_VOLTAGE) ADC to Voltage Conversion

Rising Edge?
Previously below threshold
• toneActive = true
• toneStartTime = millis()
• peakADC = adcValue
• peakVoltage = voltage

Falling Edge?
Previously above threshold

Track maximum ADC/voltage

during tone duration Update Peak Values

• toneDuration = millis() - toneStartTime TONE ENDED

Timeout?
>2000ms since first tone
Exceeded 2s window

Idle - Monitor ADC

Duration outside 500-1000ms range

Reset firstToneDetected = false Discard Tone

• firstToneDetected = true
• firstToneEndTime = millis()
• Wait for second tone

Mark as First Tone

• Set systemStatus.pureToneDetected = true
• Trigger SOS state transition
• Reset detection state

Reset to First Tone

Gap exceeded 2s window
Current tone becomes new first tone

DUAL-TONE DETECTED

Return to Main Loop
