Bud-wiser-er/ERD320-FinalReport/EPR320_Group_45_Final_Report/01_SNC/diagrams/snc_architecture/out/snc_architecture.pdf

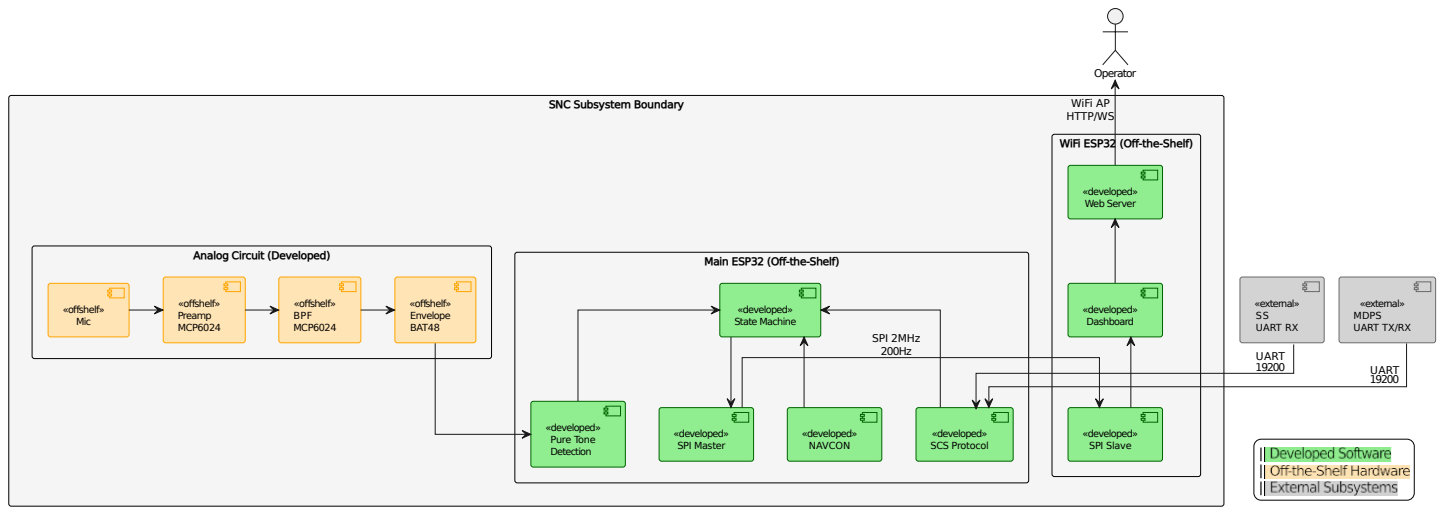
[picture p129: page 1]
«developed» State Machine; «developed» NAVCON; «developed» SCS Protocol; «developed» Pure Tone Detection; «developed» SPI Master; «developed» SPI Slave; «developed» Web Server; «developed» Dashboard; «offshelf» Mic; «offshelf» Preamp MCP6024; «offshelf» BPF MCP6024; «offshelf» Envelope BAT48; «external» SS UART RX; Operator; UART; SPI 2MHz 200Hz; WiFi AP HTTP/WS

SNC Subsystem Boundary

WiFi ESP32 (Off-the-Shelf)

Analog Circuit (Developed)

Main ESP32 (Off-the-Shelf)

«external»
MDPS
UART TX/RX
