Bud-wiser-er/ERD320-FinalReport/EPR320_Group_45_Final_Report/01_SNC/diagrams/state_machine/out/state_machine.pdf

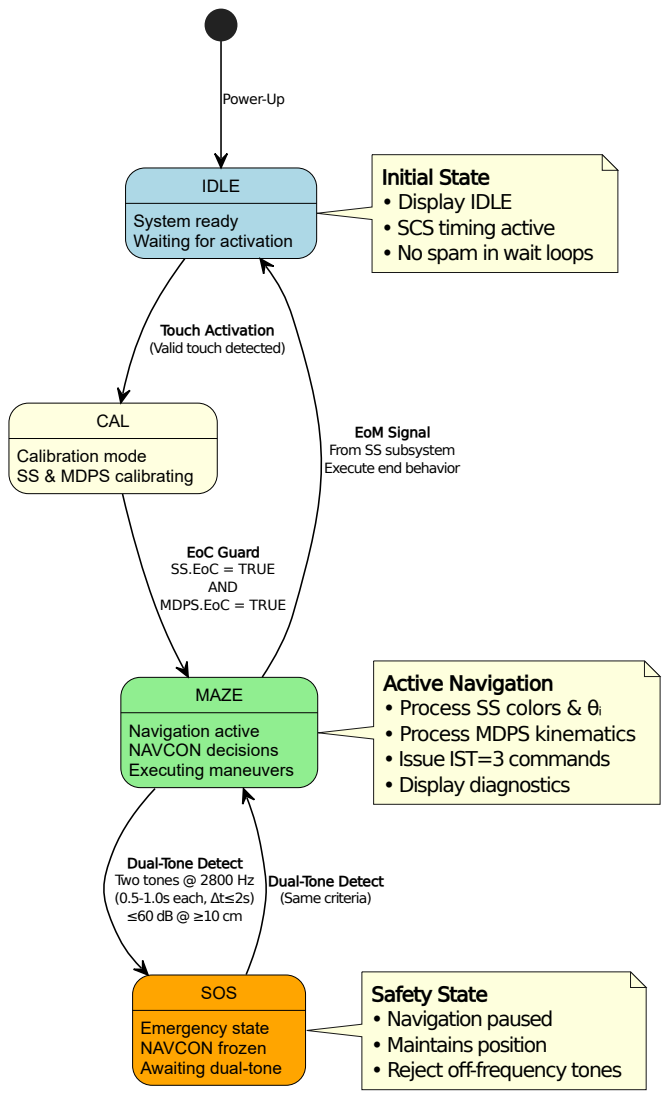
[picture p130: page 1]
IDLE; CAL; MAZE; Navigation active NAVCON decisions Executing maneuvers; SOS; Power-Up

Initial State
• Display IDLE
• SCS timing active
• No spam in wait loops

System ready
Waiting for activation

Touch Activation
(Valid touch detected)

EoM Signal
From SS subsystem
Execute end behavior

Calibration mode
SS & MDPS calibrating

EoC Guard
SS.EoC = TRUE
AND
MDPS.EoC = TRUE

Active Navigation
• Process SS colors & θᵢ
• Process MDPS kinematics
• Issue IST=3 commands
• Display diagnostics

Dual-Tone Detect
Two tones @ 2800 Hz
(0.5-1.0s each, Δt≤2s)

(Same criteria)

Safety State
• Navigation paused
• Maintains position
• Reject off-frequency tones

Emergency state
NAVCON frozen
Awaiting dual-tone
