Bud-wiser-er/ERD320-FinalReport/Phase 1/Pure tone sims/MATLAB sims for gain/MCP6024_Output_Signal_Level.pdf

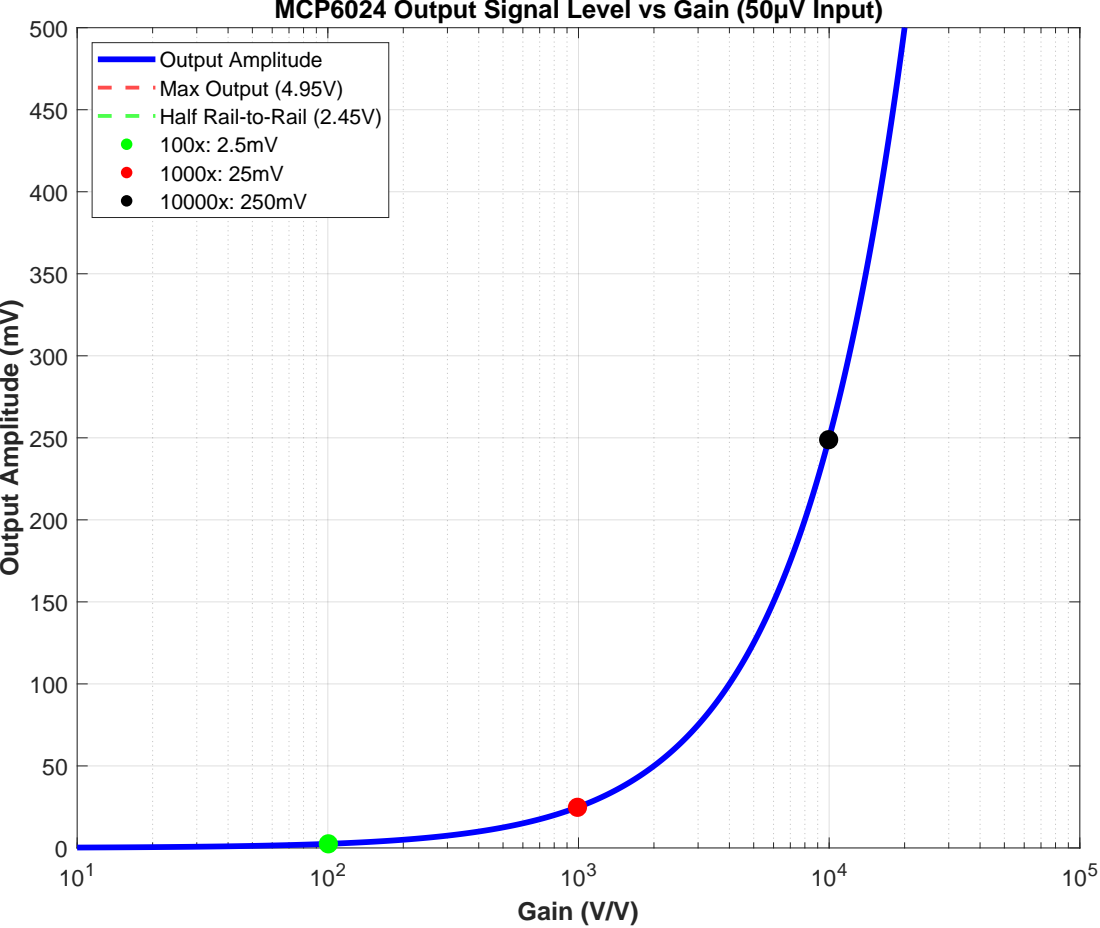
[picture p131: page 1]
Gain (V/V)

MCP6024 Output Signal Level vs Gain (50µV Input)

Output Amplitude Max Output (4.95V)

Half Rail-to-Rail (2.45V) 100x: 2.5mV 1000x: 25mV

Output Amplitude (mV)
