Bud-wiser-er/ERD320-FinalReport/Phase 1/Pure tone sims/MATLAB sims for gain/Required_PostAmp_Gain.pdf

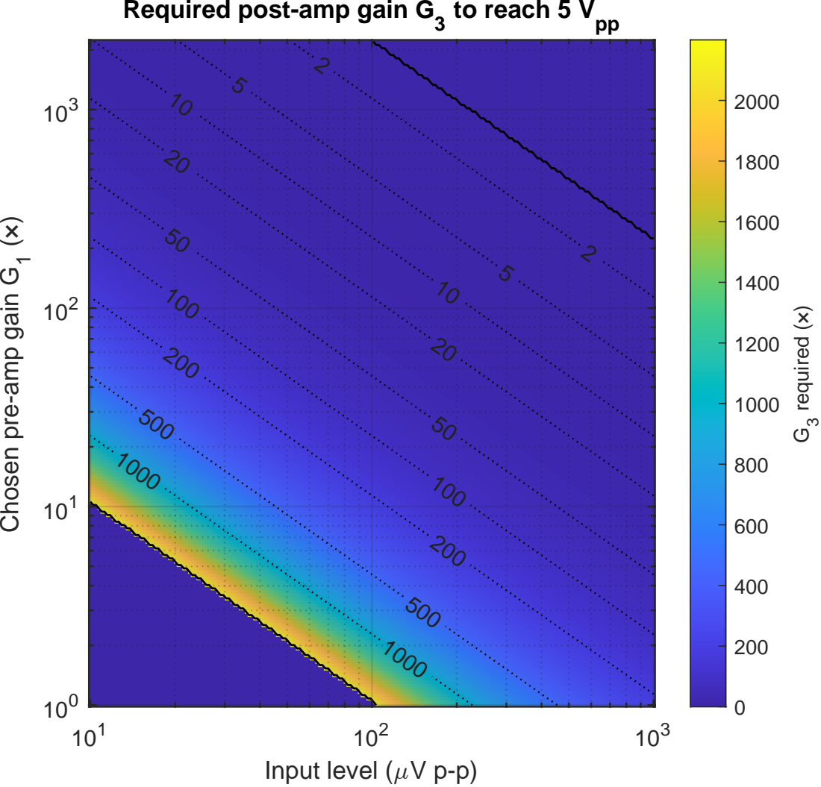
[picture p132: page 1]
to reach 5 V pp; Input level (7V p-p); G3 required (×)

Required post-amp gain G3

Chosen pre-amp gain G1 (×)
