Bud-wiser-er/ERD320-FinalReport/Phase 1/Pure tone sims/MATLAB sims for gain/StageGains_Feasibility_Combined.pdf

## Filter gain fixed at Gf

## = 22 | Target output = 5.0 Vpp

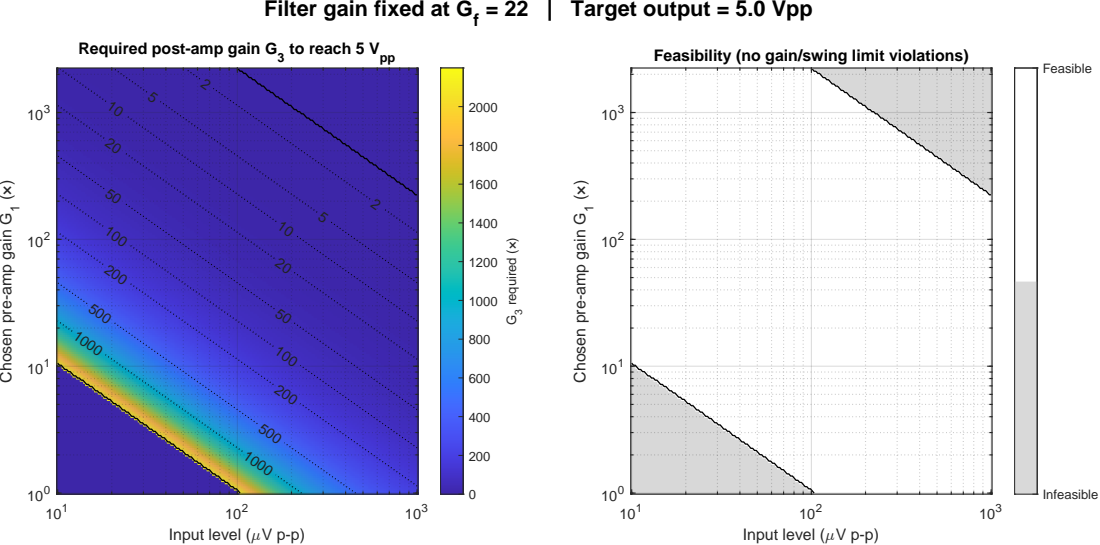
[picture p133: page 1]
to reach 5 V pp; Input level (7V p-p); G3 required (×); Infeasible; Feasible

Required post-amp gain G3

Feasibility (no gain/swing limit violations)

Chosen pre-amp gain G1 (×)
