Bud-wiser-er/ERD320-FinalReport/Phase 1/NAVCON/out/NAVCON_Flow/NAVCON_Flow.pdf

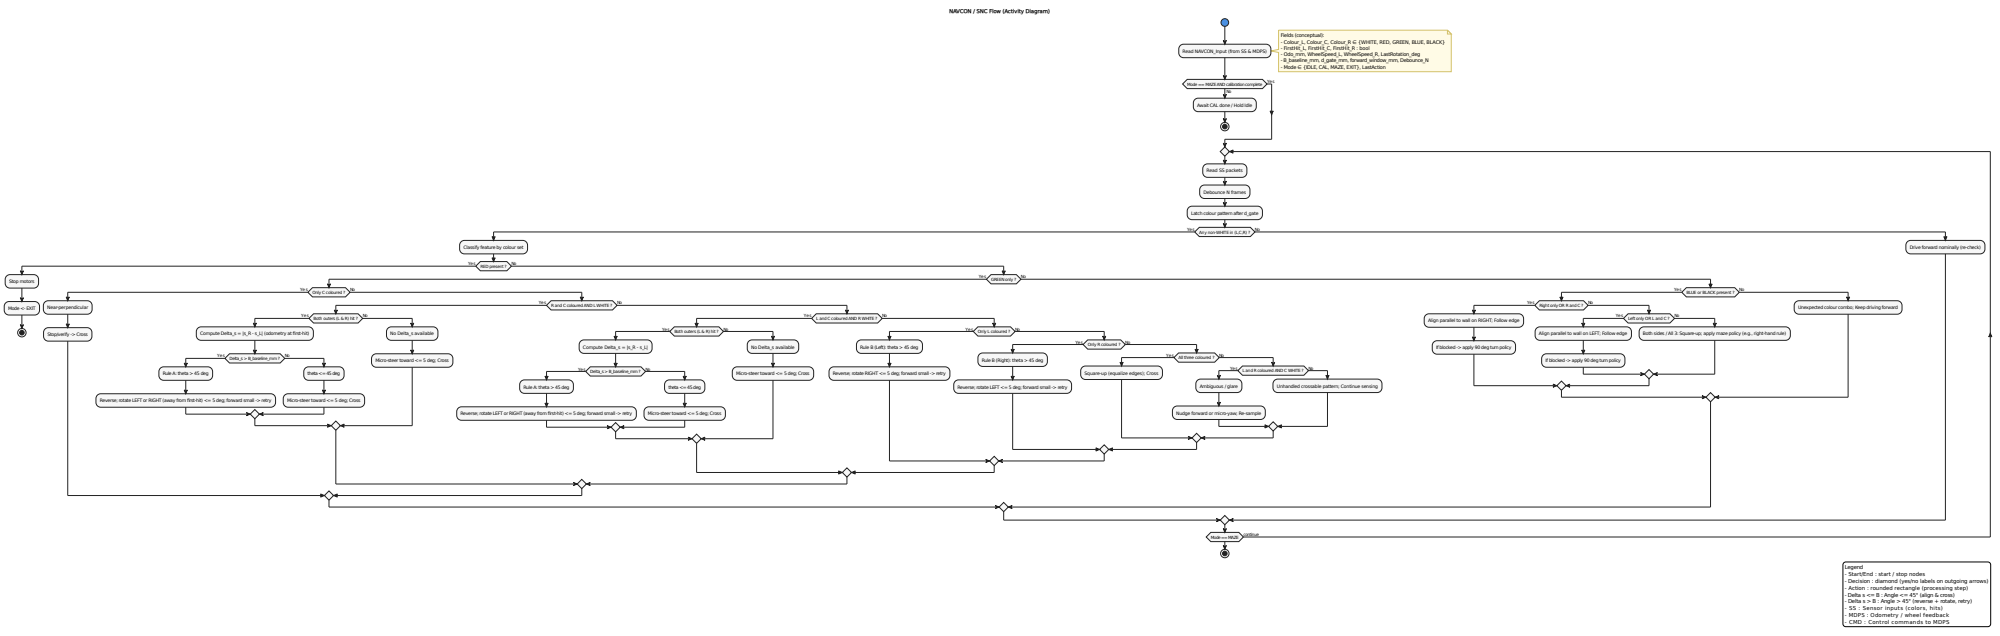
[picture p134: page 1]
Debounce N frames; Any non-WHITE in (L,C,R) ? Yes; RED present ? Yes; Stop motors; Mode <- EXIT; GREEN only ? Yes; Only C coloured ? Yes; Near-perpendicular; R and C coloured AND L WHITE ? Yes; Both outers (L & R) hit ? Yes; Delta_s > B_baseline_mm ? Yes; theta <= 45 deg; No Delta_s available; L and C coloured AND R WHITE ? Yes; Compute Delta_s = |s_R - s_L|; Only L coloured ? Yes; Only R coloured ? Yes; All three coloured ? Yes; Square-up (equalize edges); Cross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

NAVCON / SNC Flow (Activity Diagram)

Fields (conceptual):
- Colour_L, Colour_C, Colour_R ∈ {WHITE, RED, GREEN, BLUE, BLACK}
- FirstHit_L, FirstHit_C, FirstHit_R : bool
- Odo_mm, WheelSpeed_L, WheelSpeed_R, LastRotation_deg
- B_baseline_mm, d_gate_mm, forward_window_mm, Debounce_N
- Mode ∈ {IDLE, CAL, MAZE, EXIT}, LastAction

Read NAVCON_Input (from SS & MDPS)

Mode == MAZE AND calibration complete Yes

Await CAL done / Hold Idle

Read SS packets

Latch colour pattern after d_gate

Classify feature by colour set

Drive forward nominally (re-check)

Unexpected colour combo; Keep driving forward

Align parallel to wall on RIGHT; Follow edge

Stop/verify -> Cross

Compute Delta_s = |s_R - s_L| (odometry at first-hit)

Align parallel to wall on LEFT; Follow edge

Both sides / All 3: Square-up; apply maze policy (e.g., right-hand rule)

Rule B (Left): theta > 45 deg

If blocked -> apply 90 deg turn policy

Micro-steer toward <= 5 deg; Cross

Rule B (Right): theta > 45 deg

Rule A: theta > 45 deg

Reverse; rotate RIGHT <= 5 deg; forward small -> retry

Reverse; rotate LEFT <= 5 deg; forward small -> retry

Unhandled crossable pattern; Continue sensing

Reverse; rotate LEFT or RIGHT (away from first-hit) <= 5 deg; forward small -> retry

Nudge forward or micro-yaw; Re-sample

Mode == MAZE continue

Legend
- Start/End : start / stop nodes
- Decision : diamond (yes/no labels on outgoing arrows)
- Action : rounded rectangle (processing step)
- Delta s <= B : Angle <= 45° (align & cross)
- Delta s > B : Angle > 45° (reverse + rotate, retry)
- SS : Sensor inputs (colors, hits)
- MDPS : Odometry / wheel feedback
- CMD : Control commands to MDPS
