Bud-wiser-er/ERD320-FinalReport/EPR320_Group_45_Final_Report/01_SNC/diagrams/pure_tone_circuit_schematic.pdf

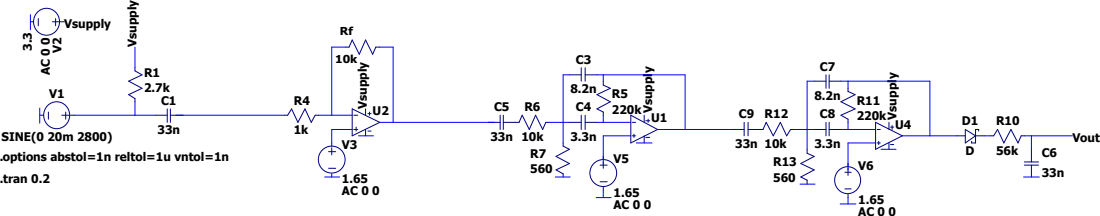
[picture p135: page 1]

.options abstol=1n reltol=1u vntol=1n
.tran 0.2
