Bud-wiser-er/ERD320-FinalReport/EPR320_Group_45_Final_Report/01_SNC/diagrams/architecture_block/out/architecture_block.pdf

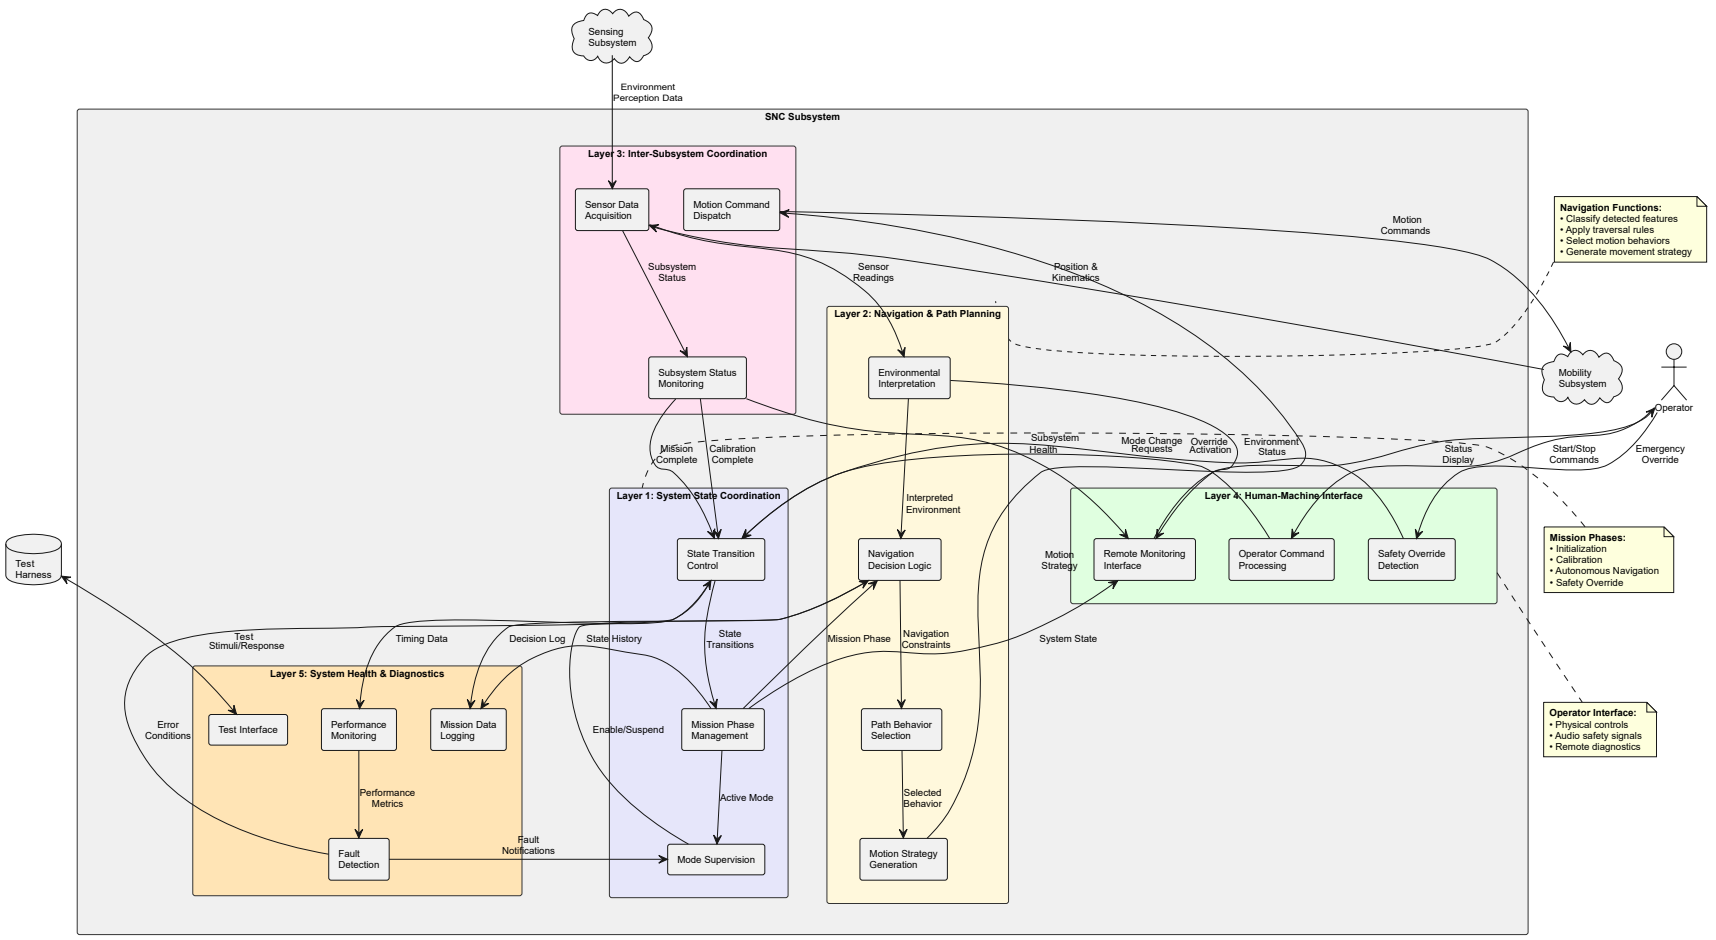
[picture p136: page 1]
SNC Subsystem; Mission Phase Management; State Transition Control; Mode Supervision; Environmental Interpretation; Navigation Decision Logic; Path Behavior Selection; Motion Strategy Generation; Sensor Data Acquisition; Motion Command Dispatch; Subsystem Status Monitoring; Operator Command Processing; Safety Override Detection; Remote Monitoring Interface; Performance Monitoring; Fault Detection; Mission Data; Operator; Sensing Subsystem; Mobility Subsystem; Test Harness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

Layer 3: Inter-Subsystem Coordination

Navigation Functions:
• Classify detected features
• Apply traversal rules
• Select motion behaviors
• Generate movement strategy

Layer 2: Navigation & Path Planning

Layer 1: System State Coordination

Layer 4: Human-Machine Interface

Layer 5: System Health & Diagnostics

Operator Interface:
• Physical controls
• Audio safety signals
• Remote diagnostics

Enable/Suspend Error
Conditions

Logging Test Interface
