Bud-wiser-er/ERD320-FinalReport/Phase 1/Pure tone sims/MATLAB sims for gain/Feasibility_Map.pdf

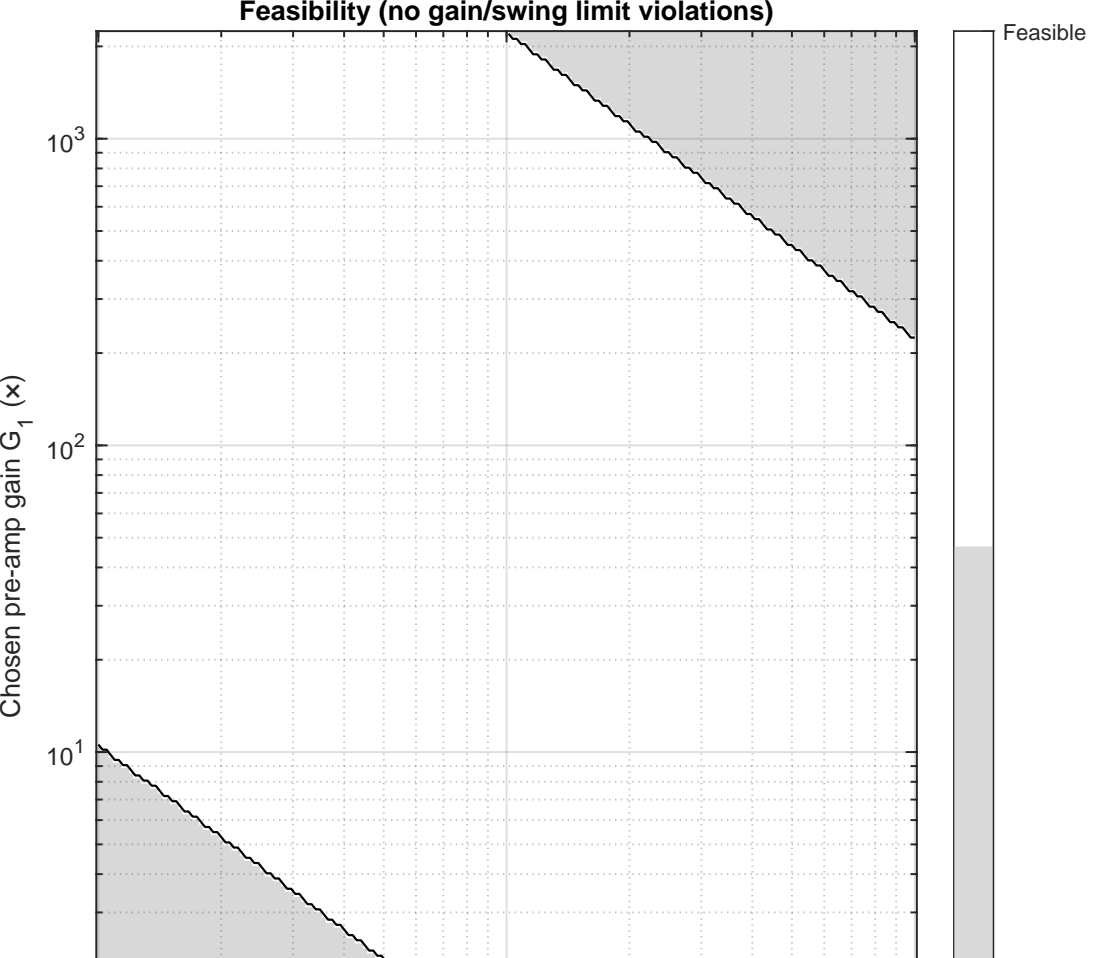
[picture p137: page 1]
Feasible

Feasibility (no gain/swing limit violations)

Chosen pre-amp gain G1 (×)
