Bud-wiser-er/ERD320-FinalReport/Phase 1/Pure tone sims/MATLAB sims for gain/MCP6024_Frequency_Limitations.pdf

## MCP6024 Frequency Limitations vs Gain (Enhanced)

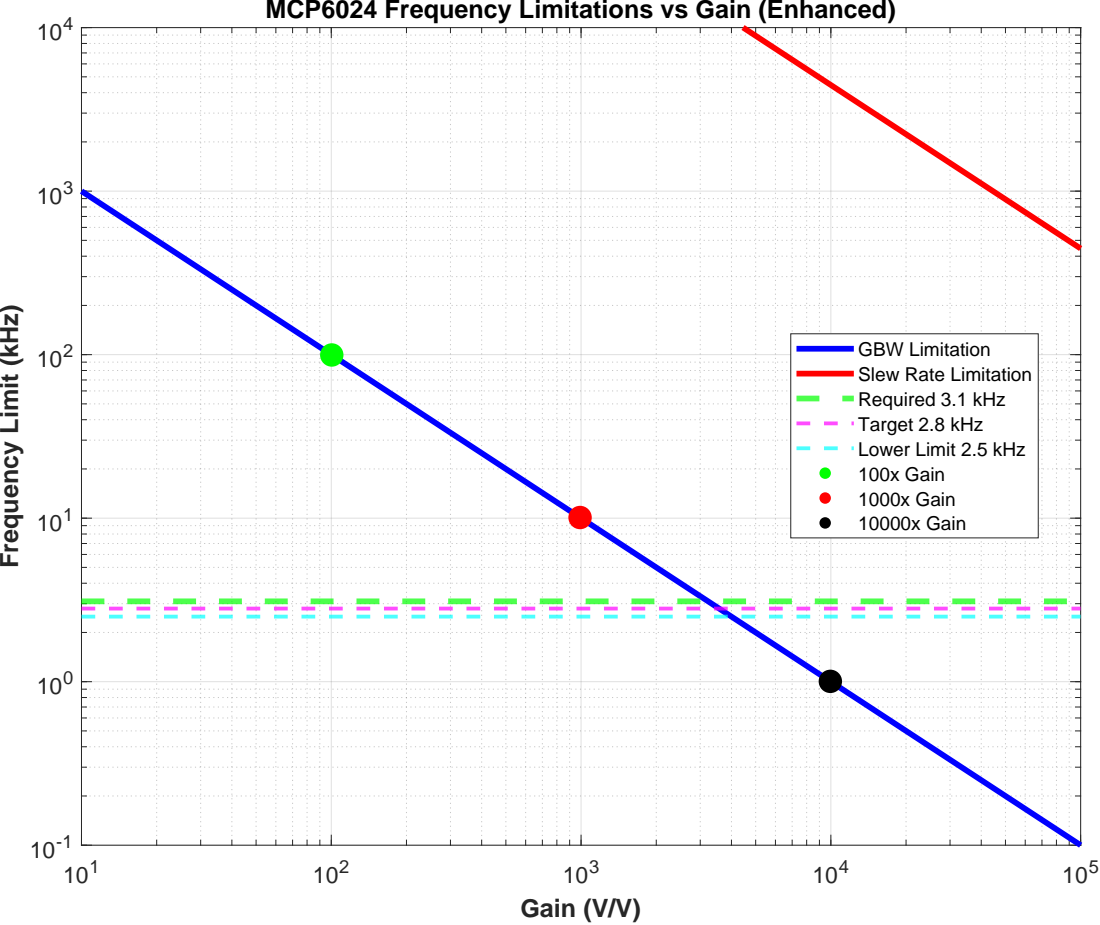
[picture p138: page 1]
Gain (V/V)

Frequency Limit (kHz)

GBW Limitation
Slew Rate Limitation
Required 3.1 kHz
Target 2.8 kHz
Lower Limit 2.5 kHz
100x Gain 1000x Gain

10000x Gain
