Bud-wiser-er/ERD320-FinalReport/Phase 1/Pure tone sims/Draft1.asc

C1: cap; 5pF
Ctouch: cap; {C2val}
R1: res; 56k
V1: voltage; PULSE(0 3.3 0 1n 1n 10u 100u)
Named nets: 0, V_MCU
.step param C2val list 0p 25p 35p
.tran 0 1m 0 20n
