Bud-wiser-er/ERD320-FinalReport/Phase 1/Pure tone sims/FullSim.asc

C1: cap; 33n
C2: cap; 33n
C3: cap; 8.2n
C4: cap; 3.3n
C5: cap; 33n
C6: cap; 33n
C7: cap; 8.2n
C8: cap; 3.3n
C9: cap; 33n
D1: schottky
R1: res; 2.7k
R2: res; 270k
R3: res; 270k
R4: res; 1k
R5: res; 220k
R6: res; 10k
R7: res; 560
R10: res; 56k
R11: res; 220k
R12: res; 10k
R13: res; 560
Rf: res; 10k
U1: UniversalOpAmp2; ""; Aol=100k GBW=10Meg Slew=5.5Meg Vos=0.5m
U2: UniversalOpAmp2; ""; Aol=100k GBW=10Meg Slew=5.5Meg Vos=0.5m
U4: UniversalOpAmp2; ""; Aol=100k GBW=10Meg Slew=5.5Meg Vos=0.5m
U5: UniversalOpAmp2; ""; Aol=100k GBW=10Meg Slew=5.5Meg Vos=0.5m
V1: voltage; SINE(0 20m 2800)
V2: voltage; 3.3; AC 0 0
V3: voltage; 1.65; AC 0 0
V4: voltage; 2.28
V5: voltage; 1.65; AC 0 0
V6: voltage; 1.65; AC 0 0
Named nets: 0, Vsupply, Vtransducer, Vout, Vfilter, VcompratorIN, VFilter2, Vfinal
.options abstol=1n reltol=1u vntol=1n
.tran 0.2
