Bud-wiser-er/ERD320-FinalReport/Phase 1/Pure tone sims/Filter/MFB.asc

C1: cap; 1.5n
C2: cap; 4.7n
C3: cap; 1.5n
C4: cap; 4.7n
R1: res; 5.1k
R2: res; 1.1k
R3: res; 510k
R4: res; 1.1k
R5: res; 510k
R6: res; 5.1k
U1: UniversalOpAmp2
U2: UniversalOpAmp2
V1: voltage; ""; AC 1
V2: voltage; 5
V3: voltage; 2.5
V4: voltage; 2.5
Named nets: 0, V+
.ac dec 100 1 20k
