Bud-wiser-er/ERD320-FinalReport/Phase3/Phase3/Phase3_Before_Distance_Update/Phase3/gpio_commands.h

#ifndef GPIO_COMMANDS_H
#define GPIO_COMMANDS_H

#include <Arduino.h>

// ==================== GPIO PIN DEFINITIONS ====================
// GPIO Command pins (inputs from WiFi ESP32)
#define CMD_TOUCH_PIN     4   // Input from WiFi ESP32 GPIO 4
#define CMD_TONE_PIN      2   // Input from WiFi ESP32 GPIO 2
#define CMD_SEND_PIN      15  // Input from WiFi ESP32 GPIO 15

// ADC Pin for Pure Tone Detection
#define PURE_TONE_ADC_PIN 36  // ADC input for pure tone voltage (1.65V-3.3V)

// ==================== GPIO FUNCTIONS ====================
/**
 * Initialize GPIO pins for command inputs
 * Sets up pins as INPUT_PULLDOWN and prints initialization status
 */
void setupGPIOCommands();

/**
 * Check for WiFi commands from GPIO pins
 * Monitors all three command pins and updates system status
 * @return: true if any command was received
 */
bool checkWiFiCommands();

/**
 * Check pure tone ADC input
 * Reads GPIO 36 ADC, ignores voltages below 2.5V
 * Sets pureToneDetected flag if voltage >= 2.5V
 * @return: true if pure tone detected
 */
bool checkPureToneADC();

#endif // GPIO_COMMANDS_H
